KoalbyMQP/Hardware-Parts/datasheets/ESP-Prog/Info.txt

Product
https://www.amazon.com/dp/B0CB3Y18Z5?ref=ppx_yo2ov_dt_b_fed_asin_title

Setup
https://www.youtube.com/watch?v=d6toH-qJbOI
