KoalbyMQP/Hardware-Parts/mechanical/cad/assemblies/subsystems/hand/gripperAssem.SLDASM

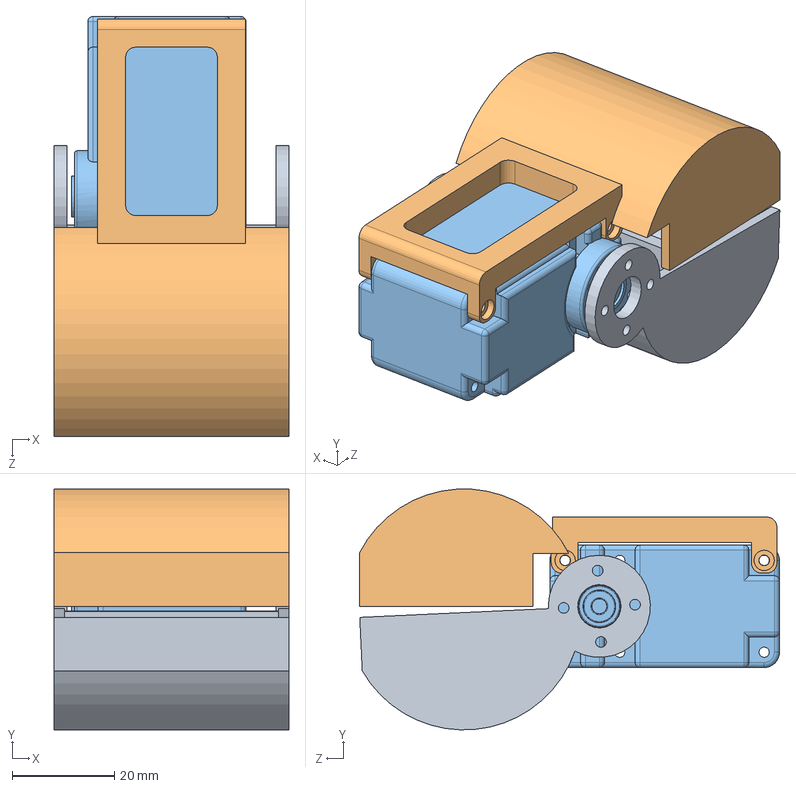
[picture p1: CAD file, 2025-09-24]
mechanical/cad/assemblies/subsystems/hand/gripperAssem.SLDASM
46.0 x 47.2 x 82.3 mm
herkulex_0201
SmallScoopFixed v1
SmallScoopFloat v1
