KoalbyMQP/Hardware-Parts/mechanical/cad/assemblies/subsystems/leg/Right Leg Assembly.SLDASM

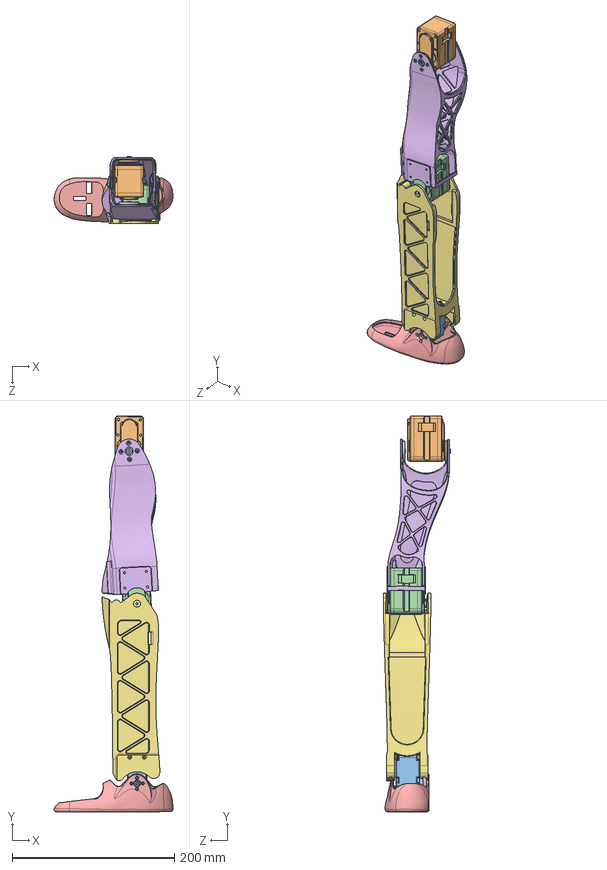
[picture p2: CAD file, 2025-09-24]
mechanical/cad/assemblies/subsystems/leg/Right Leg Assembly.SLDASM
146.7 x 488.7 x 83.3 mm
Right Shin v1
Right Thigh v1
Foot v1
0601_No_Horn
herkulex_0201
herkulex_0601
0601 Spacer v1
