KoalbyMQP/Hardware-Parts/Chess/Board/Chess Board asembly.SLDASM

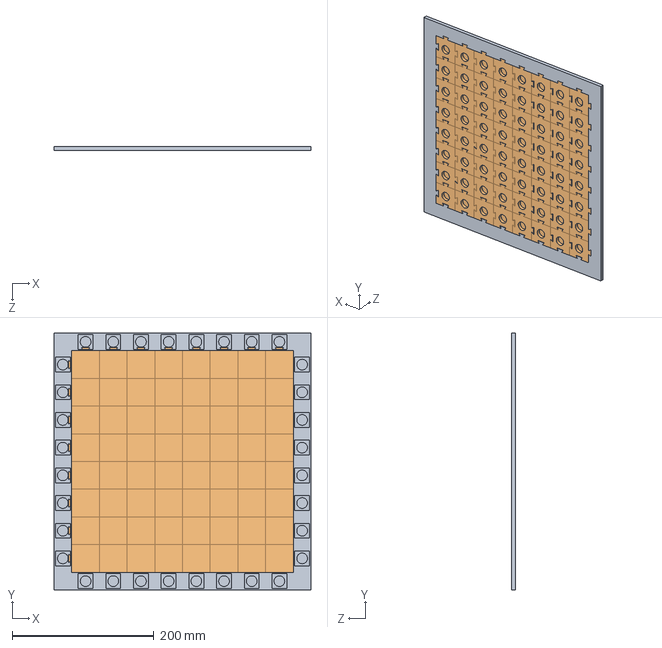
[picture p3: CAD file, 2026-02-05]
Chess/Board/Chess Board asembly.SLDASM
362.0 x 362.0 x 6.00 mm
chess square v4 x 64
Chess-Board-Boarder
