KoalbyMQP/Hardware-Parts/Chess/Board/chess square v4.SLDPRT

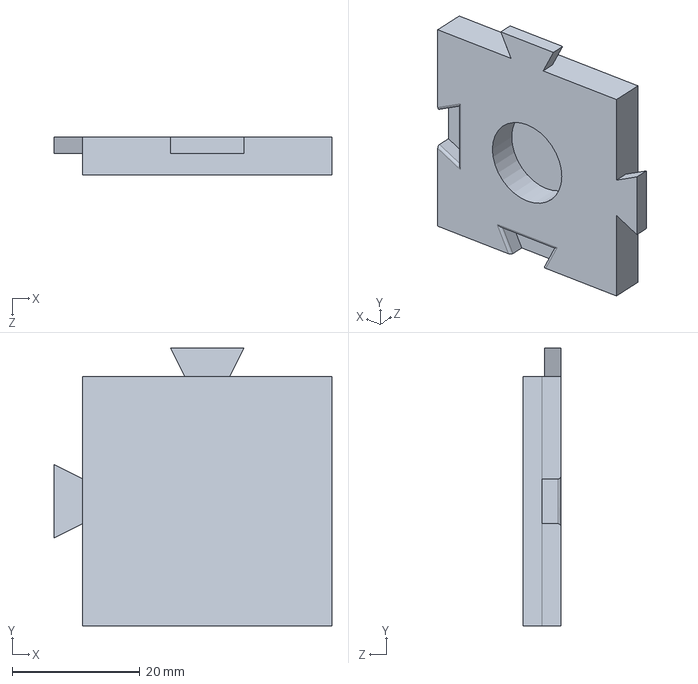
[picture p4: CAD file, 2026-02-05]
Chess/Board/chess square v4.SLDPRT
43.5 x 43.5 x 6.00 mm
