KoalbyMQP/Hardware-Parts/Chess/Camera/camera mount.SLDPRT

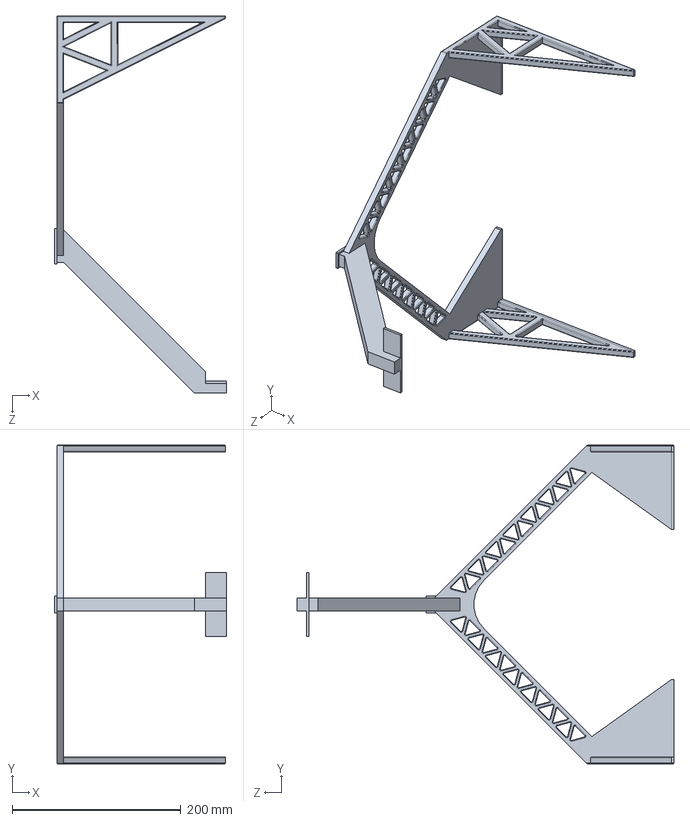
[picture p5: CAD file, 2026-02-05]
Chess/Camera/camera mount.SLDPRT
204.1 x 378.0 x 447.3 mm
