KoalbyMQP/Hardware-Parts/Chess/Pieces/Chess Board Squares/chess square v3.3mf

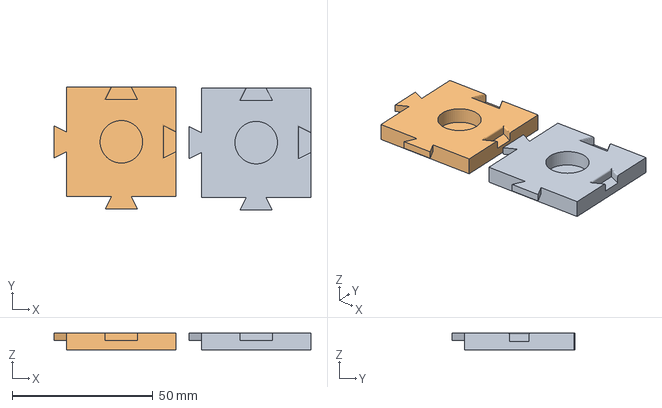
[picture p6: CAD file, 2026-02-05]
Chess/Pieces/Chess Board Squares/chess square v3.3mf
91.5 x 43.8 x 6.00 mm
chess square v3.stl x 2
