KoalbyMQP/Hardware-Parts/Chess/Pieces/Queen/Queen_Redo.3mf

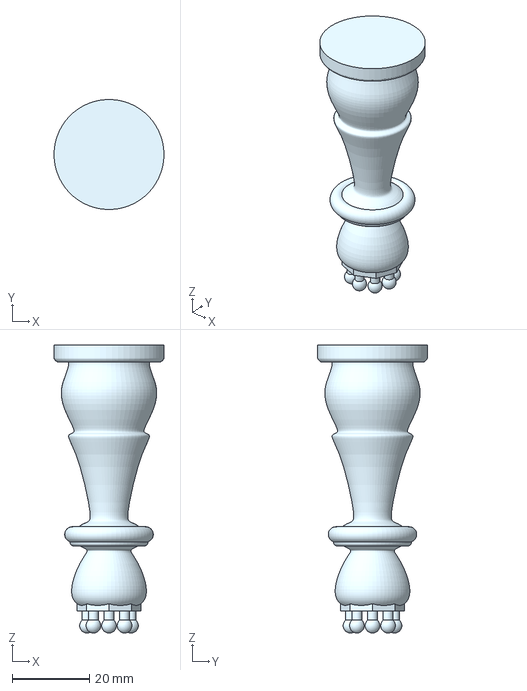
[picture p7: CAD file, 2026-02-05]
Chess/Pieces/Queen/Queen_Redo.3mf
28.5 x 28.5 x 74.6 mm
