KoalbyMQP/Hardware-Parts/mechanical/cad/parts/custom/grippers/scoops/SmallScoopFloat v1.SLDPRT

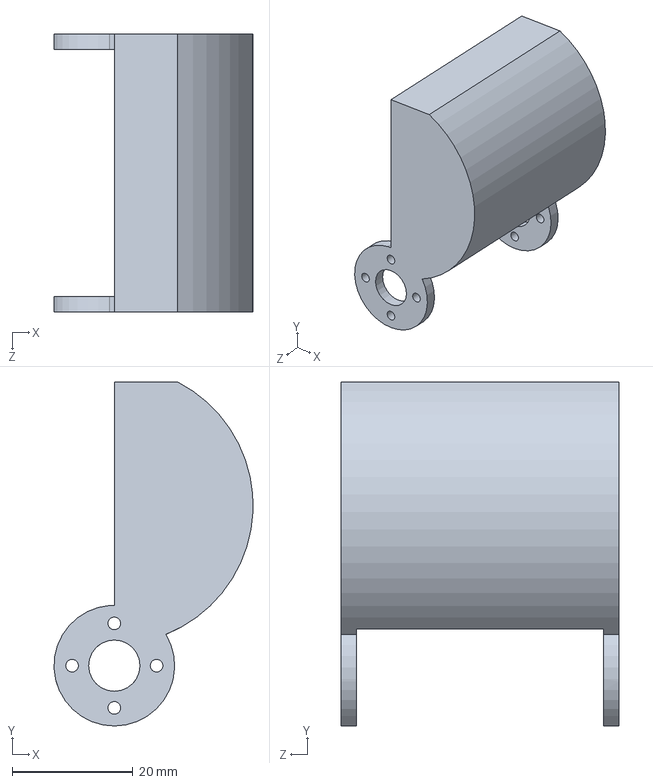
[picture p8: CAD file, 2025-09-24]
mechanical/cad/parts/custom/grippers/scoops/SmallScoopFloat v1.SLDPRT
33.0 x 57.0 x 46.0 mm
