KoalbyMQP/Hardware-Parts/mechanical/cad/parts/custom/mounts/0601 Spacer v1.SLDPRT

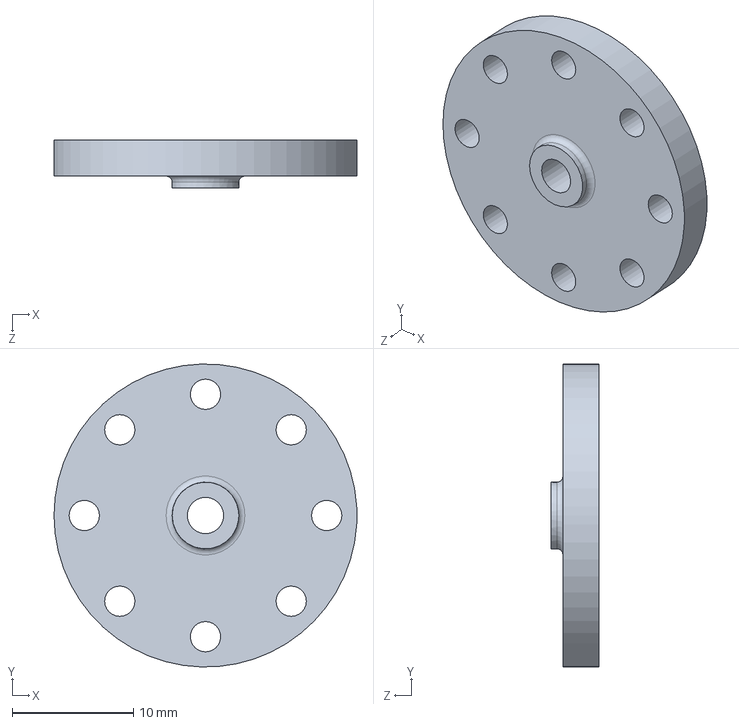
[picture p9: CAD file, 2025-09-24]
mechanical/cad/parts/custom/mounts/0601 Spacer v1.SLDPRT
25.0 x 25.0 x 4.00 mm
