KoalbyMQP/Hardware-Parts/mechanical/cad/parts/custom/mounts/Mounts_Head/RPi_Backplate_Head.SLDPRT

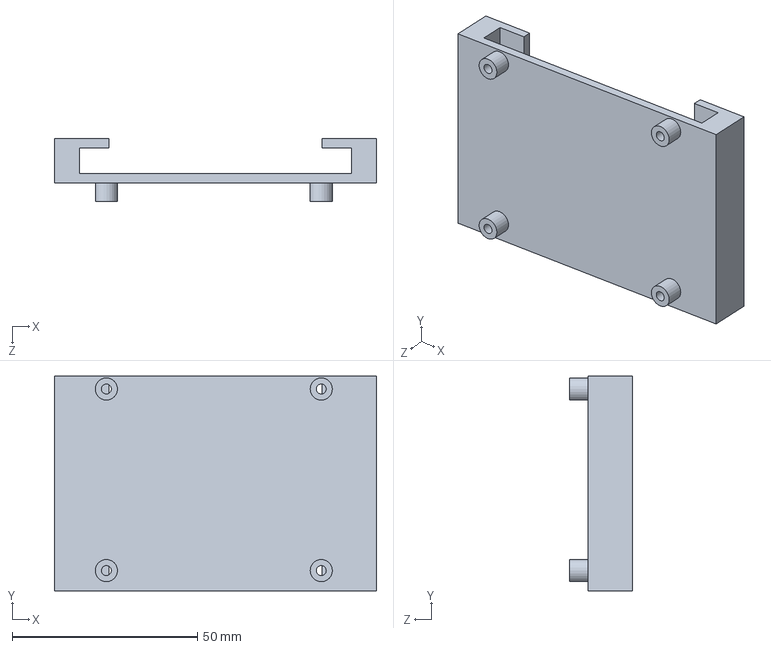
[picture p10: CAD file, 2025-09-24]
mechanical/cad/parts/custom/mounts/Mounts_Head/RPi_Backplate_Head.SLDPRT
86.9 x 58.0 x 17.0 mm
