KoalbyMQP/Hardware-Parts/mechanical/cad/parts/custom/structural/arms/Finley Shoulder Pulley/3421-0014-0060/3421-0014-0060 SW part.SLDPRT

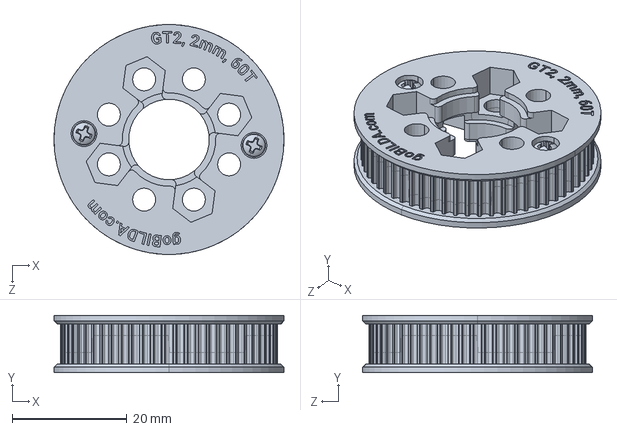
[picture p11: CAD file, 2025-09-10]
mechanical/cad/parts/custom/structural/arms/Finley Shoulder Pulley/3421-0014-0060/3421-0014-0060 SW part.SLDPRT
40.0 x 10.0 x 40.0 mm
