KoalbyMQP/Hardware-Parts/mechanical/cad/parts/custom/structural/arms/Finley Shoulder Pulley/Bicep v1.SLDPRT

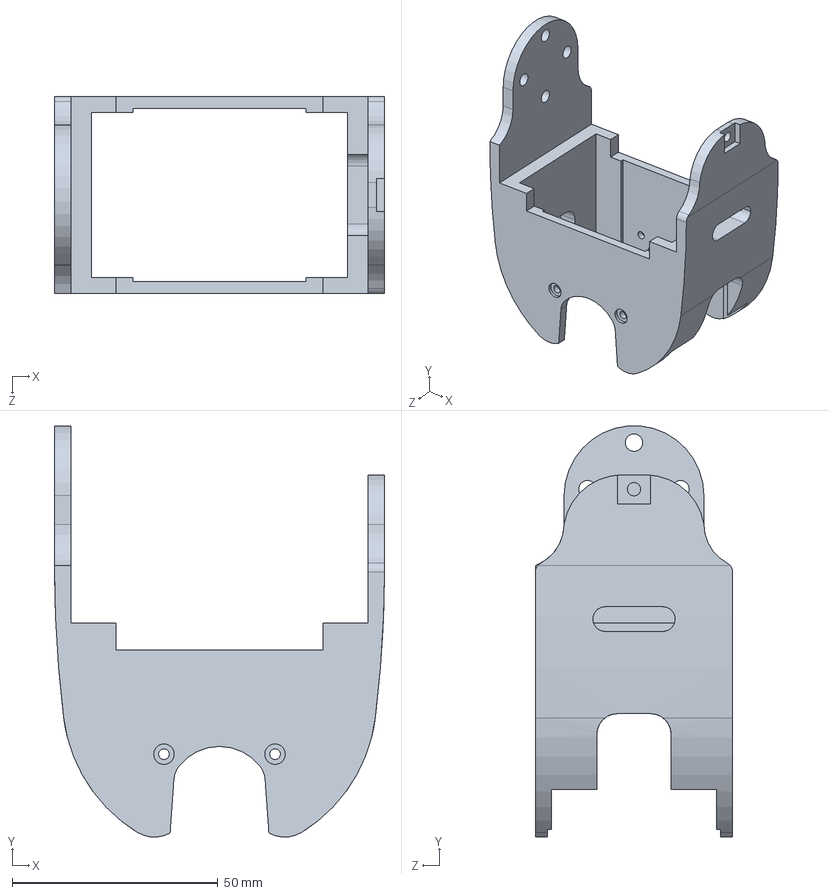
[picture p12: CAD file, 2025-09-24]
mechanical/cad/parts/custom/structural/arms/Finley Shoulder Pulley/Bicep v1.SLDPRT
80.2 x 99.9 x 48.0 mm
