KoalbyMQP/Hardware-Parts/mechanical/cad/parts/custom/structural/arms/Lower Forearm Bracket v1.SLDPRT

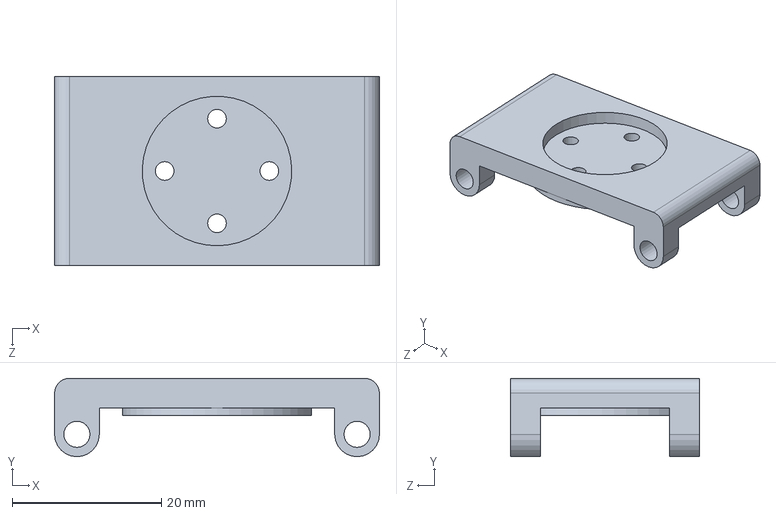
[picture p13: CAD file, 2025-09-24]
mechanical/cad/parts/custom/structural/arms/Lower Forearm Bracket v1.SLDPRT
43.5 x 10.5 x 25.2 mm
