KoalbyMQP/Hardware-Parts/mechanical/cad/parts/custom/structural/head/Head 2.0/Head 2.0.SLDPRT

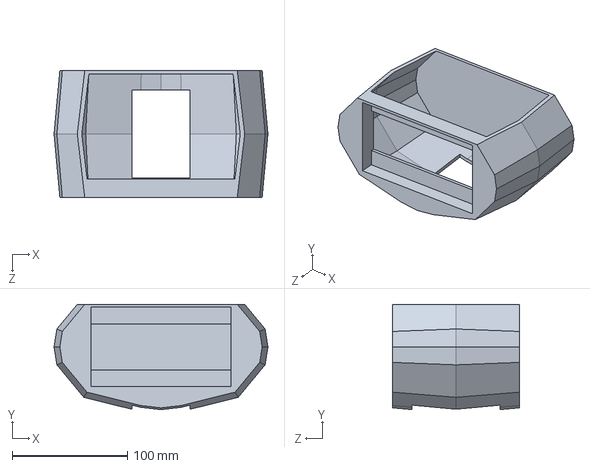
[picture p14: CAD file, 2025-09-24]
mechanical/cad/parts/custom/structural/head/Head 2.0/Head 2.0.SLDPRT
186.0 x 91.5 x 110.0 mm
