KoalbyMQP/Hardware-Parts/mechanical/cad/parts/custom/structural/head/Head v1.SLDPRT

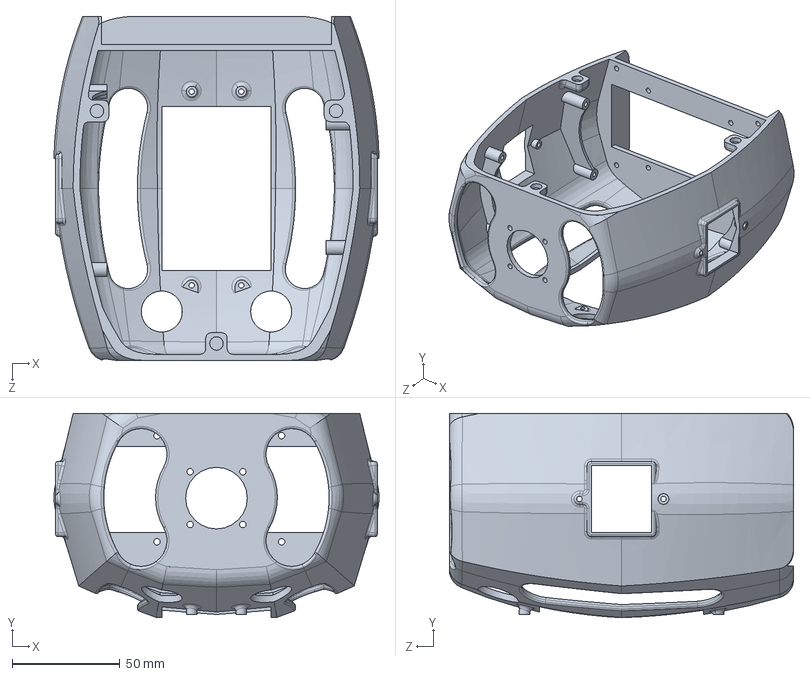
[picture p15: CAD file, 2025-09-24]
mechanical/cad/parts/custom/structural/head/Head v1.SLDPRT
151.0 x 95.0 x 160.0 mm
