KoalbyMQP/Hardware-Parts/mechanical/cad/parts/custom/structural/legs/Foot v1.SLDPRT

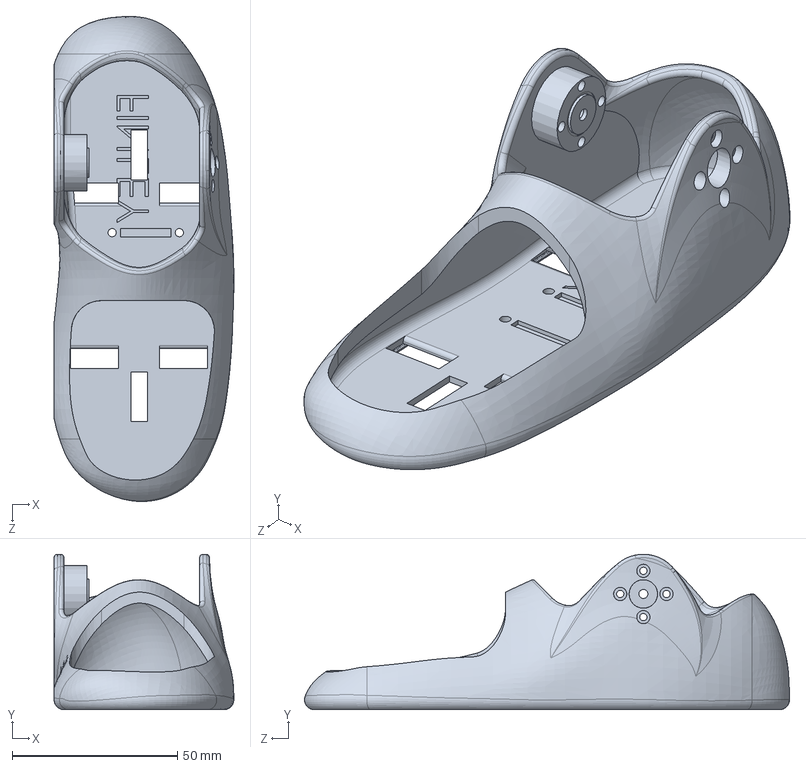
[picture p16: CAD file, 2025-09-24]
mechanical/cad/parts/custom/structural/legs/Foot v1.SLDPRT
54.4 x 47.0 x 146.7 mm
