KoalbyMQP/Hardware-Parts/mechanical/cad/parts/custom/structural/torso/Left Hip v1.SLDPRT

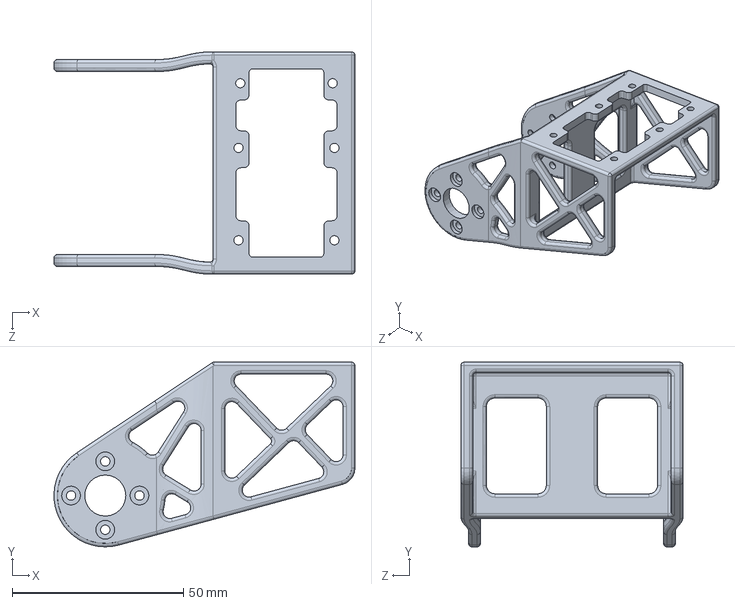
[picture p17: CAD file, 2025-09-24]
mechanical/cad/parts/custom/structural/torso/Left Hip v1.SLDPRT
88.0 x 54.0 x 65.0 mm
