KoalbyMQP/Hardware-Parts/mechanical/cad/parts/open-source/hardware/misc/electromagnet.SLDPRT

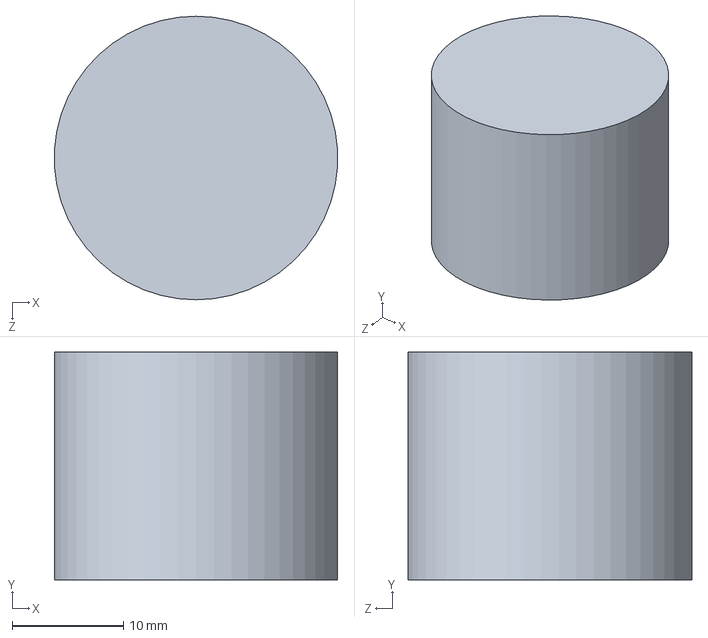
[picture p18: CAD file, 2025-09-03]
mechanical/cad/parts/open-source/hardware/misc/electromagnet.SLDPRT
25.4 x 20.5 x 25.5 mm
