KoalbyMQP/Hardware-Parts/mechanical/cad/parts/open-source/motors/herkulex_0201.SLDPRT

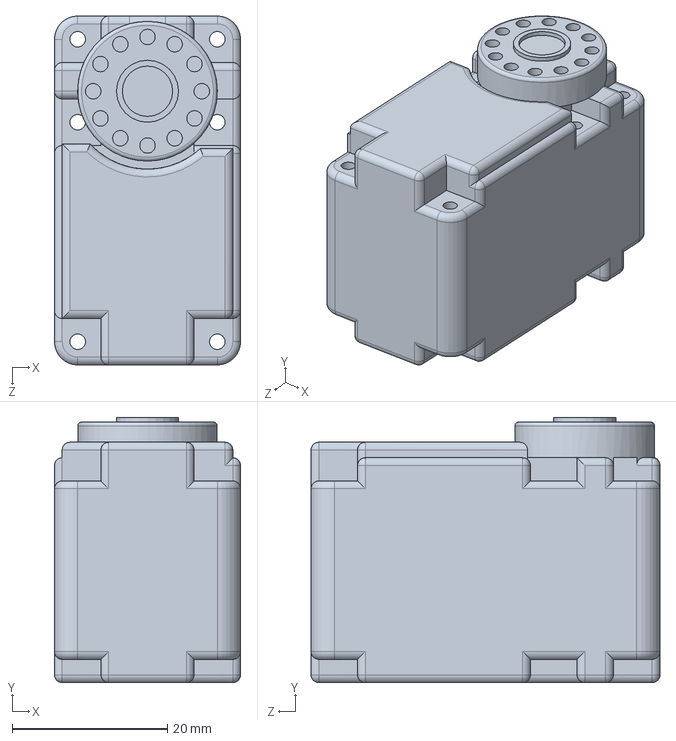
[picture p19: CAD file, 2025-09-10]
mechanical/cad/parts/open-source/motors/herkulex_0201.SLDPRT
24.0 x 34.2 x 45.0 mm
