KoalbyMQP/Hardware-Parts/mechanical/Simulation Files/SolidWorks/URDF_Links_Parts/foot_right.SLDPRT

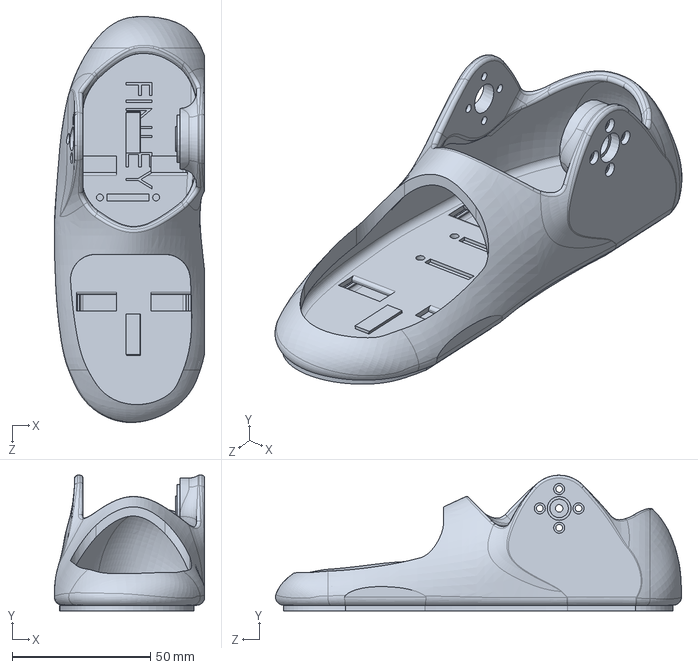
[picture p20: CAD file, 2025-09-10]
mechanical/Simulation Files/SolidWorks/URDF_Links_Parts/foot_right.SLDPRT
54.4 x 49.0 x 146.7 mm
