KoalbyMQP/Hardware-Parts/Chess/Board/Chess-Board-Boarder.SLDPRT

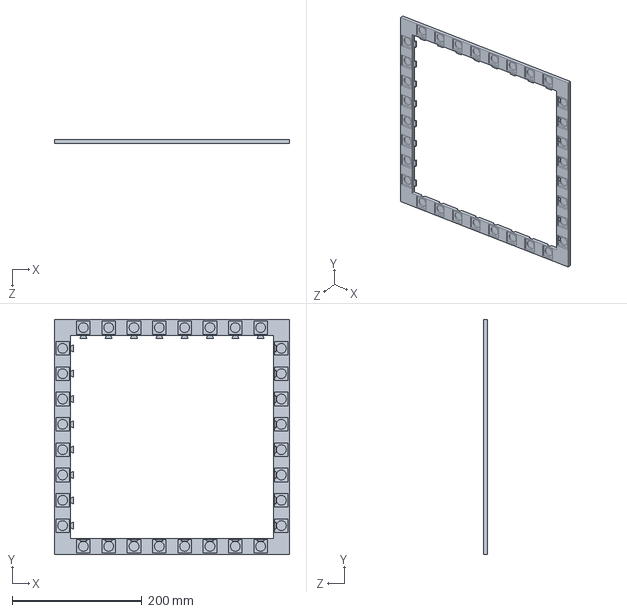
[picture p21: CAD file, 2026-02-05]
Chess/Board/Chess-Board-Boarder.SLDPRT
362.0 x 362.0 x 6.00 mm
