KoalbyMQP/Hardware-Parts/Chess/Camera/oakd camera.SLDPRT

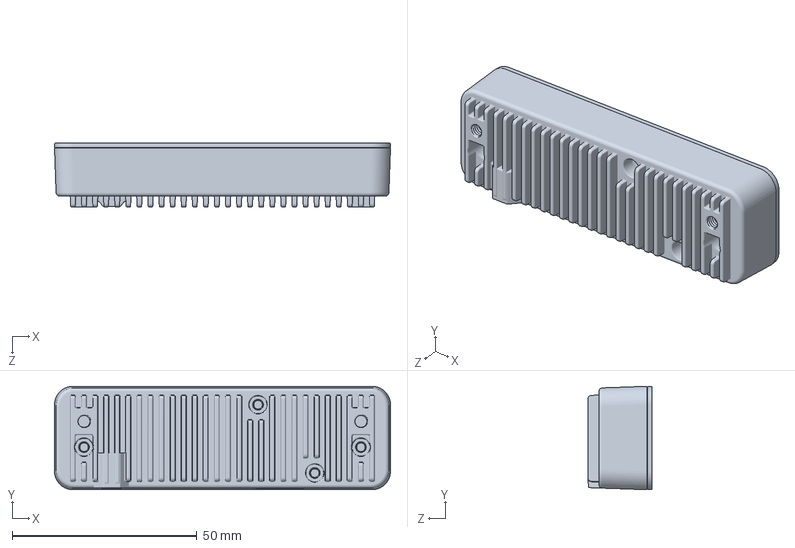
[picture p22: CAD file, 2026-02-05]
Chess/Camera/oakd camera.SLDPRT
91.0 x 28.0 x 17.5 mm
