KoalbyMQP/Hardware-Parts/Chess/Pieces/Pawn/insence match holder.3mf

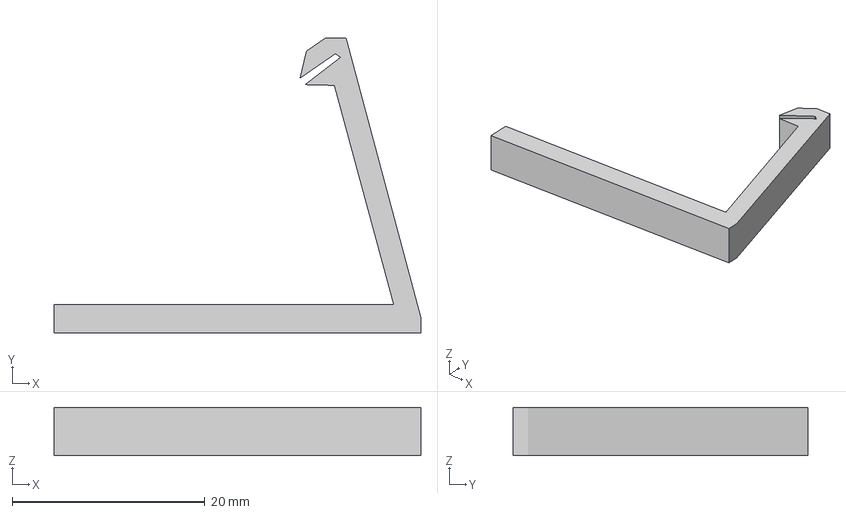
[picture p23: CAD file, 2026-02-05]
Chess/Pieces/Pawn/insence match holder.3mf
38.1 x 30.7 x 5.00 mm
