KoalbyMQP/Hardware-Parts/mechanical/cad/parts/custom/grippers/scoops/SmallScoopFixed v1.SLDPRT

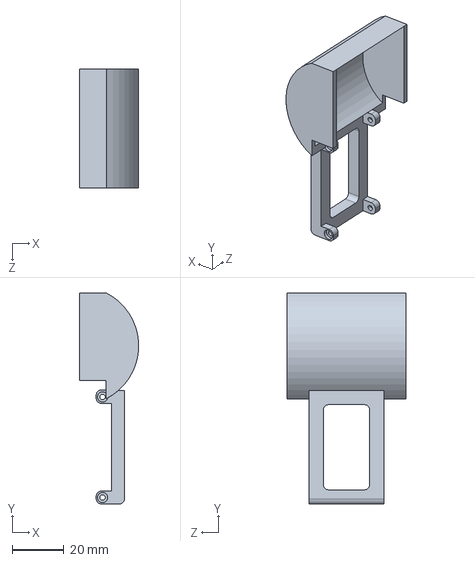
[picture p24: CAD file, 2025-09-24]
mechanical/cad/parts/custom/grippers/scoops/SmallScoopFixed v1.SLDPRT
23.0 x 81.8 x 46.0 mm
