KoalbyMQP/Hardware-Parts/mechanical/cad/parts/custom/KneeGearboxRedesign/24T_Carrier.SLDPRT

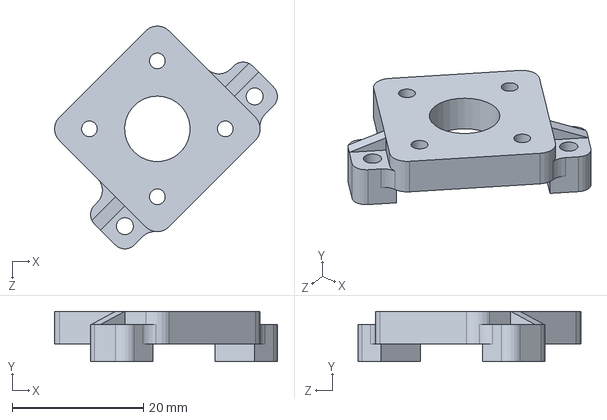
[picture p25: CAD file, 2025-12-09]
mechanical/cad/parts/custom/KneeGearboxRedesign/24T_Carrier.SLDPRT
34.0 x 7.70 x 34.0 mm
