KoalbyMQP/Hardware-Parts/mechanical/cad/parts/custom/mounts/Switch Mount v1.SLDPRT

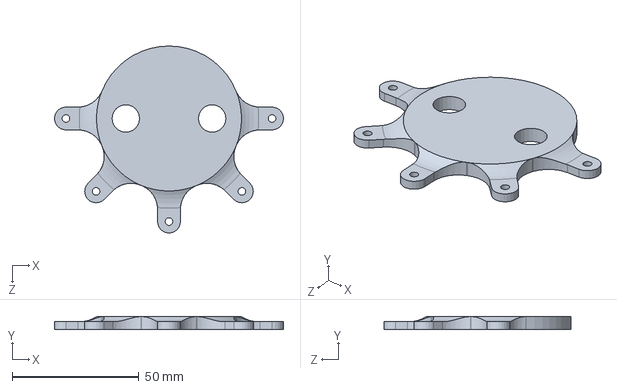
[picture p26: CAD file, 2025-09-24]
mechanical/cad/parts/custom/mounts/Switch Mount v1.SLDPRT
90.3 x 5.00 x 73.7 mm
