KoalbyMQP/Hardware-Parts/mechanical/cad/parts/custom/structural/arms/Finley Shoulder Pulley/Shoulder v1.SLDPRT

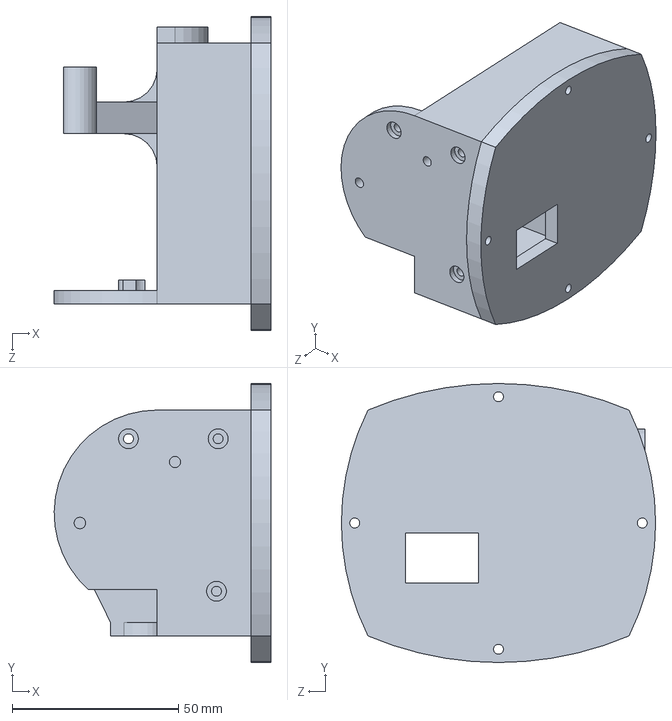
[picture p27: CAD file, 2025-09-24]
mechanical/cad/parts/custom/structural/arms/Finley Shoulder Pulley/Shoulder v1.SLDPRT
65.2 x 84.0 x 94.6 mm
