KoalbyMQP/Hardware-Parts/mechanical/cad/parts/custom/structural/arms/Wrist Mounting Pyramid v1.SLDPRT

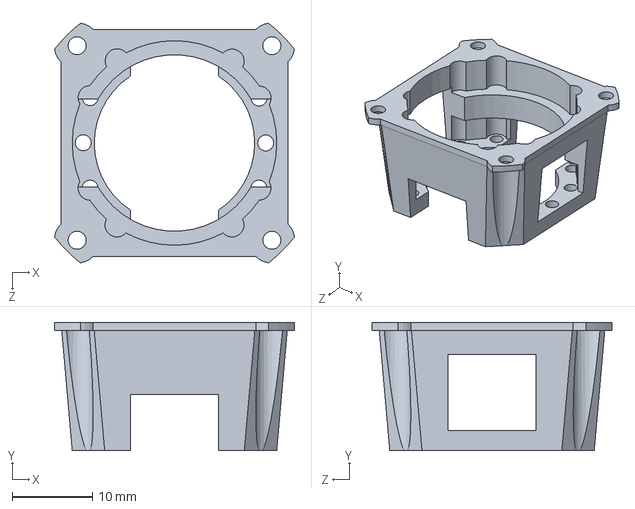
[picture p28: CAD file, 2025-09-24]
mechanical/cad/parts/custom/structural/arms/Wrist Mounting Pyramid v1.SLDPRT
29.9 x 16.0 x 29.9 mm
