KoalbyMQP/Hardware-Parts/mechanical/cad/parts/custom/structural/head/Blindfold v1.SLDPRT

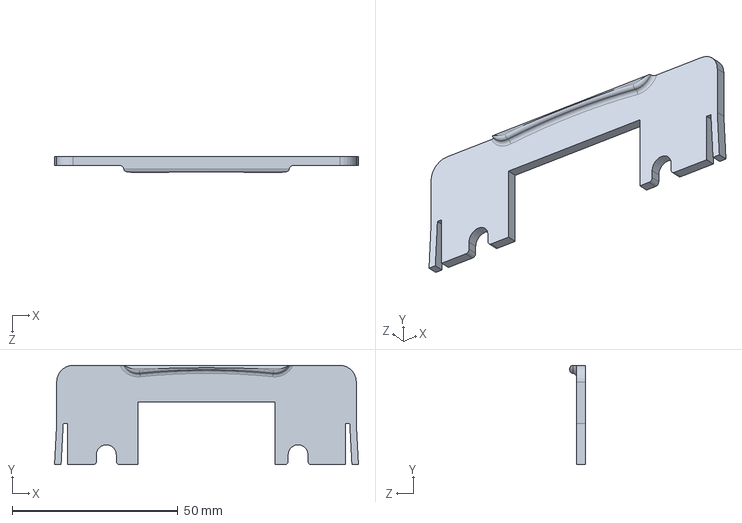
[picture p29: CAD file, 2025-09-24]
mechanical/cad/parts/custom/structural/head/Blindfold v1.SLDPRT
91.8 x 30.0 x 4.70 mm
