KoalbyMQP/Hardware-Parts/mechanical/cad/parts/custom/structural/legs/Right Thigh v1.SLDPRT

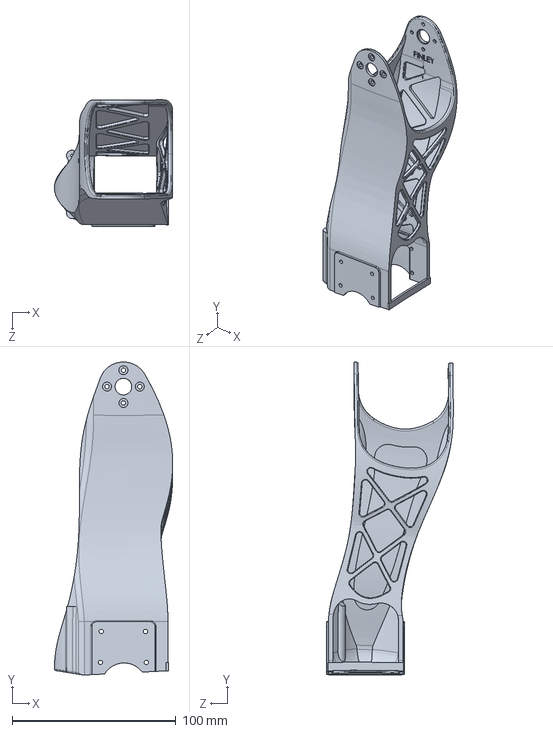
[picture p30: CAD file, 2025-09-24]
mechanical/cad/parts/custom/structural/legs/Right Thigh v1.SLDPRT
72.2 x 191.1 x 77.3 mm
