KoalbyMQP/Hardware-Parts/mechanical/cad/parts/open-source/motors/herkulex_0601.SLDPRT

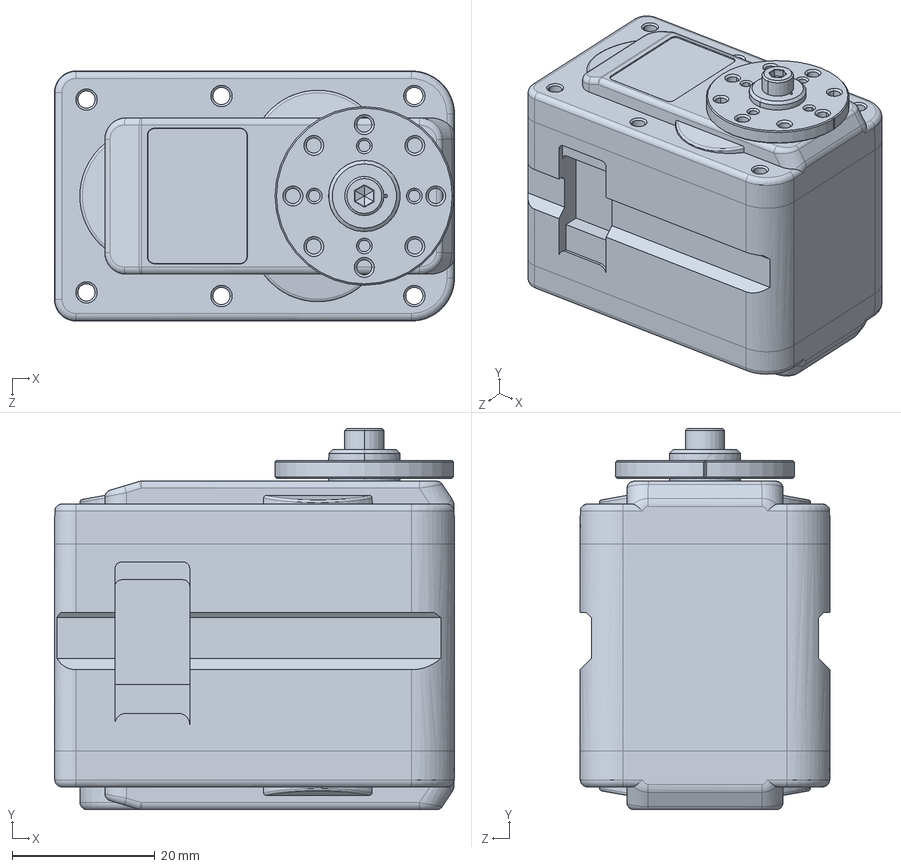
[picture p31: CAD file, 2025-09-10]
mechanical/cad/parts/open-source/motors/herkulex_0601.SLDPRT
56.0 x 53.4 x 35.0 mm
