KoalbyMQP/Hardware-Parts/mechanical/Simulation Files/SolidWorks/URDF_Links_Parts/head.SLDPRT

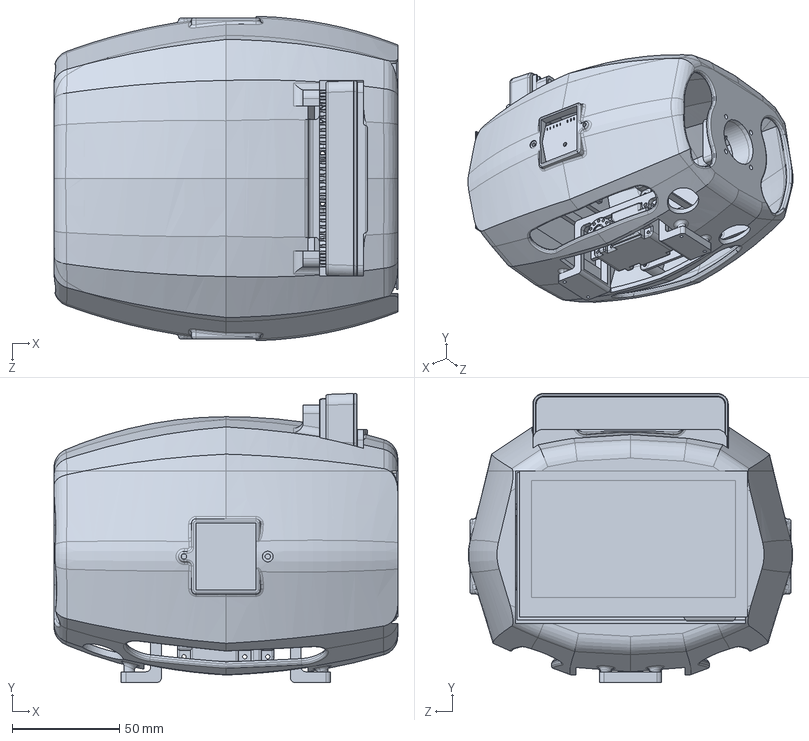
[picture p32: CAD file, 2025-09-10]
mechanical/Simulation Files/SolidWorks/URDF_Links_Parts/head.SLDPRT
160.1 x 134.5 x 151.0 mm
