KoalbyMQP/Hardware-Parts/mechanical/cad/parts/custom/KneeGearboxRedesign/16-24Ring.SLDPRT

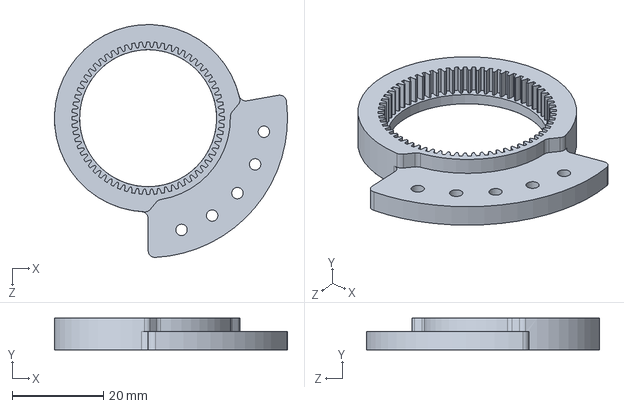
[picture p33: CAD file, 2025-12-09]
mechanical/cad/parts/custom/KneeGearboxRedesign/16-24Ring.SLDPRT
51.0 x 7.00 x 50.9 mm
