KoalbyMQP/Hardware-Parts/mechanical/cad/parts/custom/mounts/Head Mounting Bracket v1.SLDPRT

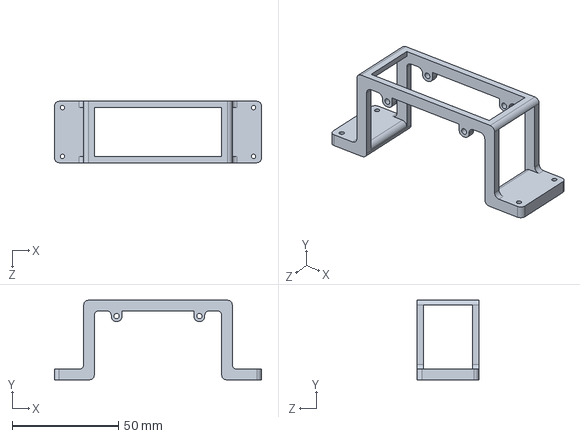
[picture p34: CAD file, 2025-09-24]
mechanical/cad/parts/custom/mounts/Head Mounting Bracket v1.SLDPRT
97.5 x 37.5 x 29.0 mm
