KoalbyMQP/Hardware-Parts/mechanical/cad/parts/custom/mounts/Mounts_Head/Arduino_Backplate_Head.SLDPRT

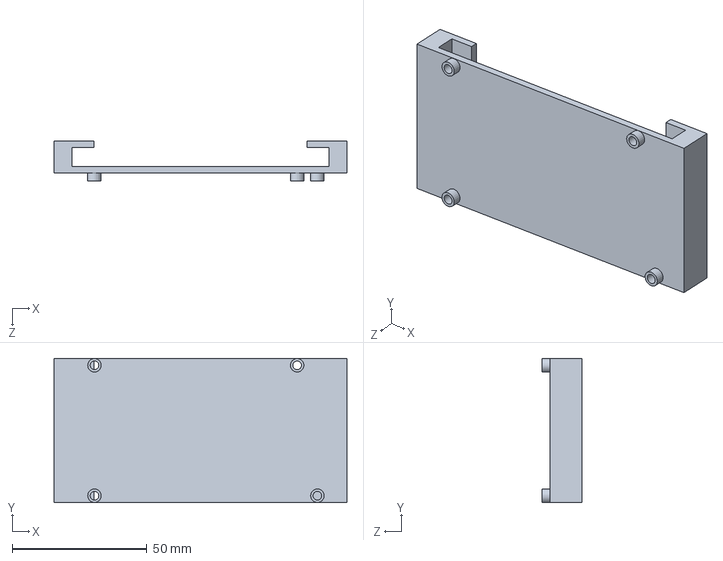
[picture p35: CAD file, 2025-09-24]
mechanical/cad/parts/custom/mounts/Mounts_Head/Arduino_Backplate_Head.SLDPRT
108.6 x 53.4 x 15.0 mm
