KoalbyMQP/Hardware-Parts/mechanical/cad/parts/custom/structural/arms/Finley Shoulder Pulley/Shoulder Adapter v1.SLDPRT

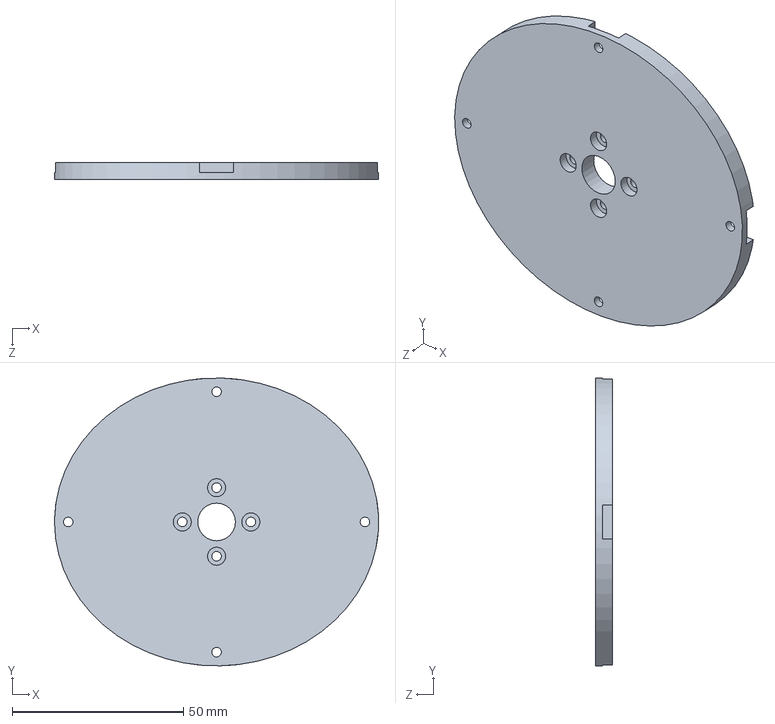
[picture p36: CAD file, 2025-09-24]
mechanical/cad/parts/custom/structural/arms/Finley Shoulder Pulley/Shoulder Adapter v1.SLDPRT
94.5 x 83.9 x 5.00 mm
