KoalbyMQP/Hardware-Parts/mechanical/cad/parts/custom/structural/arms/Wrist v1.SLDPRT

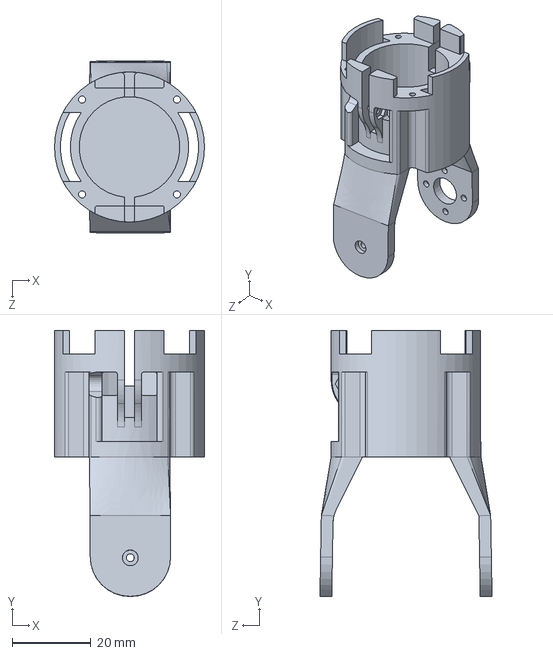
[picture p37: CAD file, 2025-09-24]
mechanical/cad/parts/custom/structural/arms/Wrist v1.SLDPRT
38.0 x 67.4 x 43.6 mm
