KoalbyMQP/Hardware-Parts/mechanical/cad/parts/custom/structural/head/Neck v1.SLDPRT

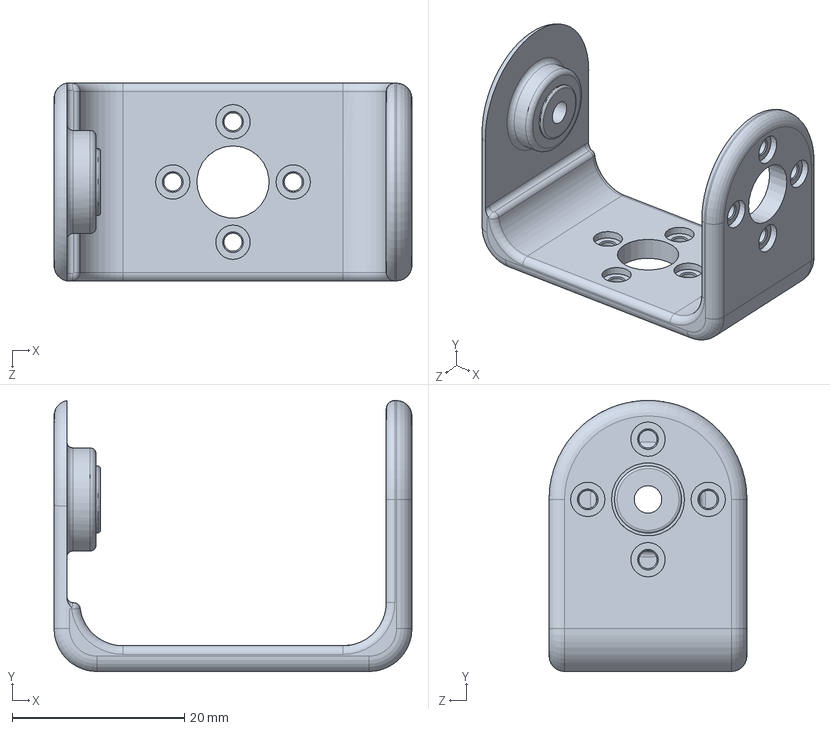
[picture p38: CAD file, 2025-09-24]
mechanical/cad/parts/custom/structural/head/Neck v1.SLDPRT
41.6 x 31.5 x 23.0 mm
