KoalbyMQP/Hardware-Parts/mechanical/cad/parts/custom/structural/legs/Right Shin v1.SLDPRT

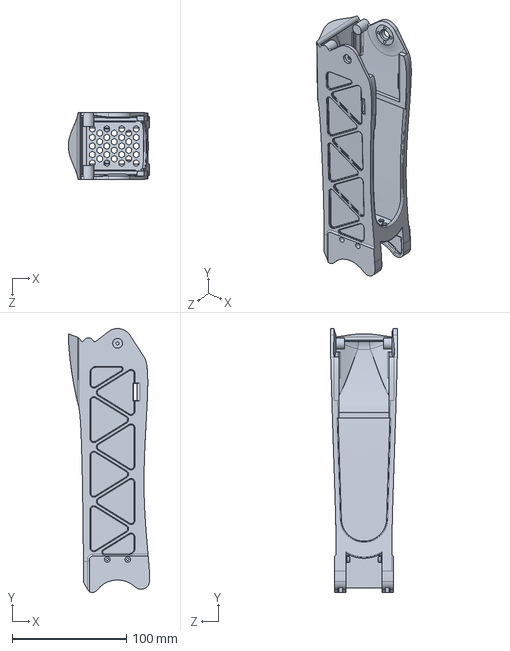
[picture p39: CAD file, 2025-09-24]
mechanical/cad/parts/custom/structural/legs/Right Shin v1.SLDPRT
71.3 x 231.5 x 59.0 mm
