KoalbyMQP/Hardware-Parts/mechanical/cad/parts/custom/structural/torso/Abdomen v1.SLDPRT

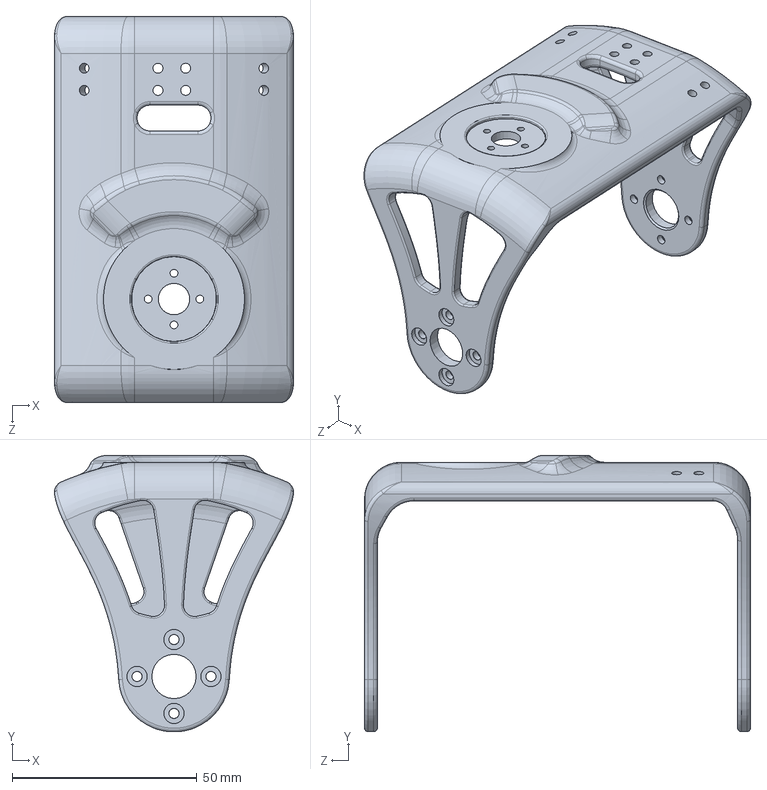
[picture p40: CAD file, 2025-09-24]
mechanical/cad/parts/custom/structural/torso/Abdomen v1.SLDPRT
64.8 x 74.8 x 104.5 mm
