KoalbyMQP/Hardware-Parts/mechanical/Simulation Files/SolidWorks/URDF_Links_Parts/wrist_left.SLDPRT

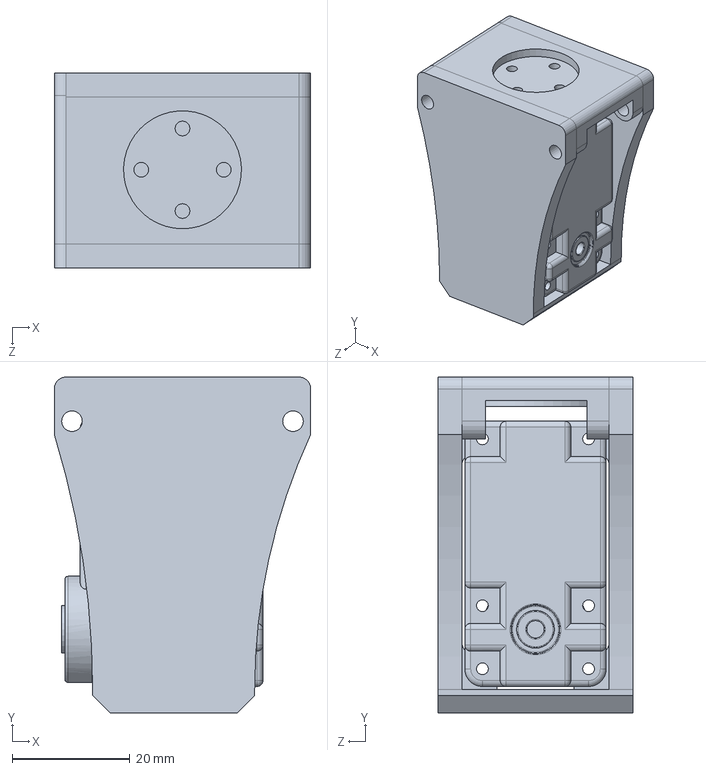
[picture p41: CAD file, 2025-09-10]
mechanical/Simulation Files/SolidWorks/URDF_Links_Parts/wrist_left.SLDPRT
43.5 x 57.0 x 33.0 mm
