KoalbyMQP/Hardware-Parts/Chess/Board/april tags.SLDPRT

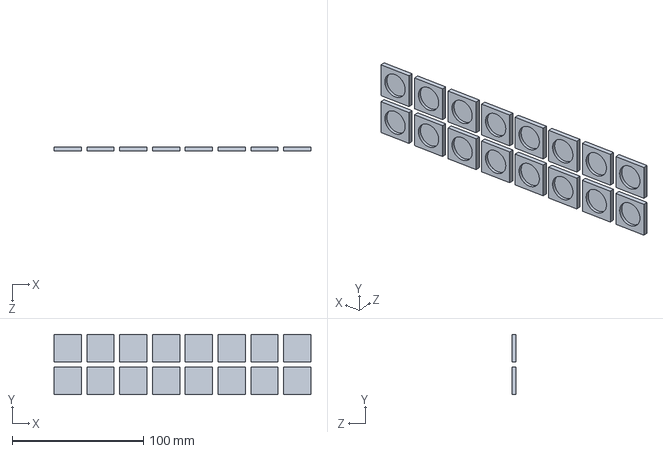
[picture p42: CAD file, 2026-02-05]
Chess/Board/april tags.SLDPRT
195.9 x 45.9 x 3.00 mm
