KoalbyMQP/Hardware-Parts/mechanical/cad/assemblies/New Motor Attachment/Countersunk Motor Bracket.SLDPRT

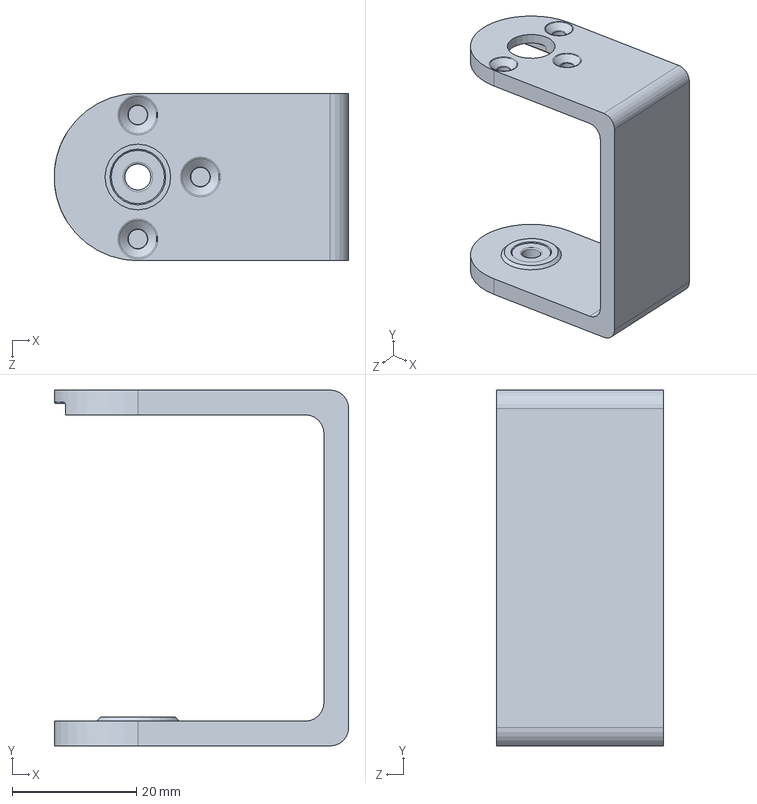
[picture p43: CAD file, 2025-09-24]
mechanical/cad/assemblies/New Motor Attachment/Countersunk Motor Bracket.SLDPRT
47.5 x 57.4 x 27.0 mm
