KoalbyMQP/Hardware-Parts/mechanical/cad/parts/custom/KneeGearboxRedesign/0601_No_Horn.SLDPRT

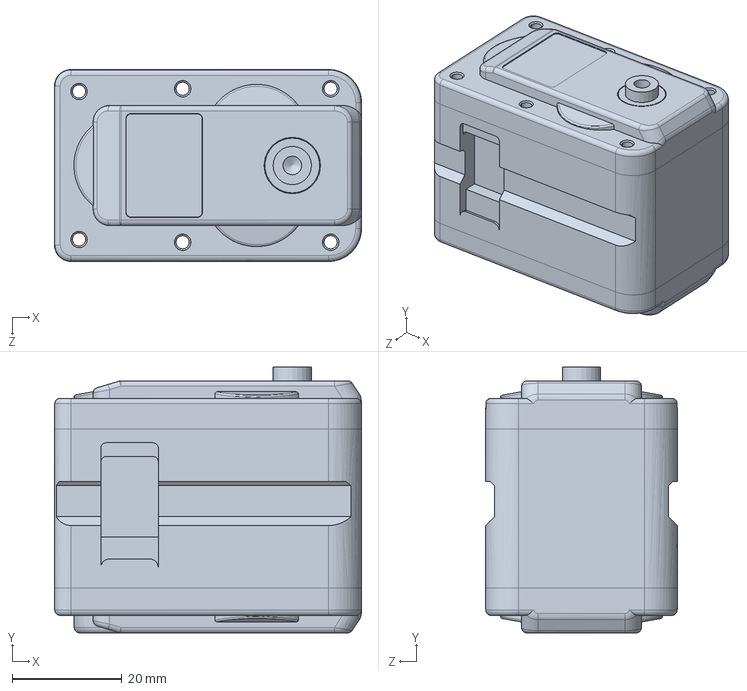
[picture p44: CAD file, 2025-12-09]
mechanical/cad/parts/custom/KneeGearboxRedesign/0601_No_Horn.SLDPRT
56.0 x 48.5 x 35.0 mm
