KoalbyMQP/Hardware-Parts/mechanical/cad/parts/custom/mounts/Motor Mount B v1.SLDPRT

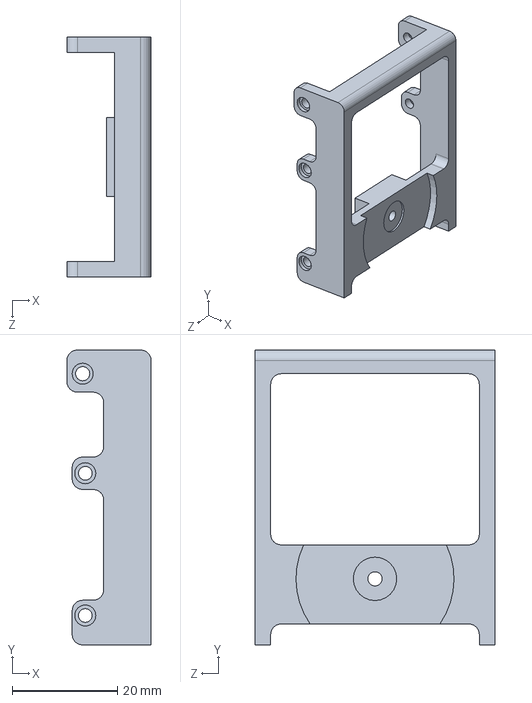
[picture p45: CAD file, 2025-09-24]
mechanical/cad/parts/custom/mounts/Motor Mount B v1.SLDPRT
16.0 x 56.0 x 45.6 mm
