KoalbyMQP/Hardware-Parts/mechanical/cad/parts/custom/mounts/Mounts_Head/Head_Boards_Mount_2.SLDPRT

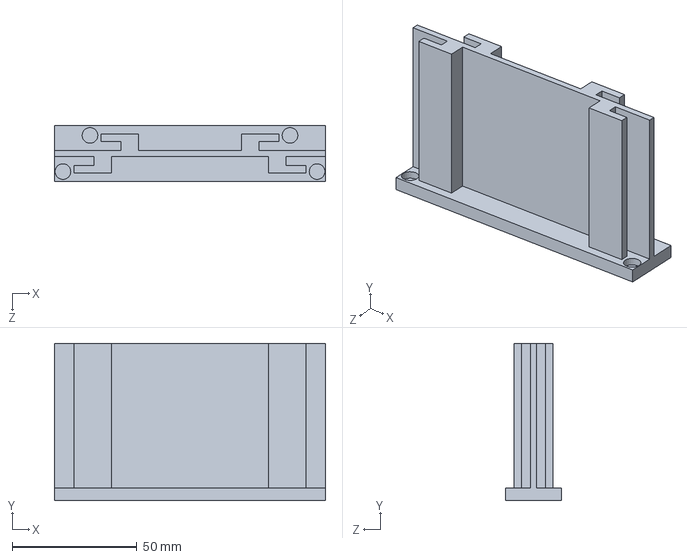
[picture p46: CAD file, 2025-09-24]
mechanical/cad/parts/custom/mounts/Mounts_Head/Head_Boards_Mount_2.SLDPRT
108.6 x 63.0 x 22.5 mm
