KoalbyMQP/Hardware-Parts/mechanical/cad/parts/custom/structural/arms/Lower Forearm v1.SLDPRT

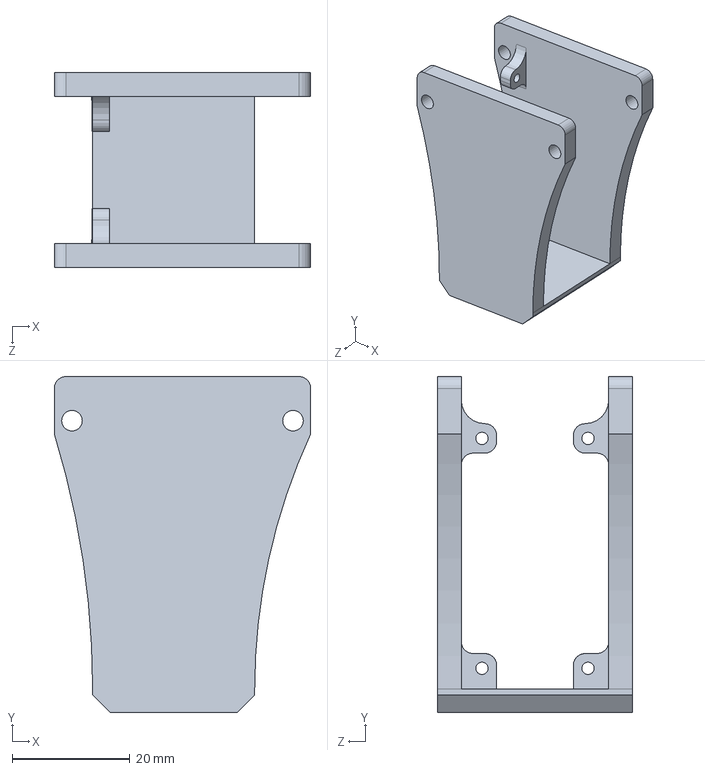
[picture p47: CAD file, 2025-09-24]
mechanical/cad/parts/custom/structural/arms/Lower Forearm v1.SLDPRT
43.5 x 57.0 x 33.0 mm
