KoalbyMQP/Hardware-Parts/mechanical/cad/parts/custom/structural/head/Head Lid v1.SLDPRT

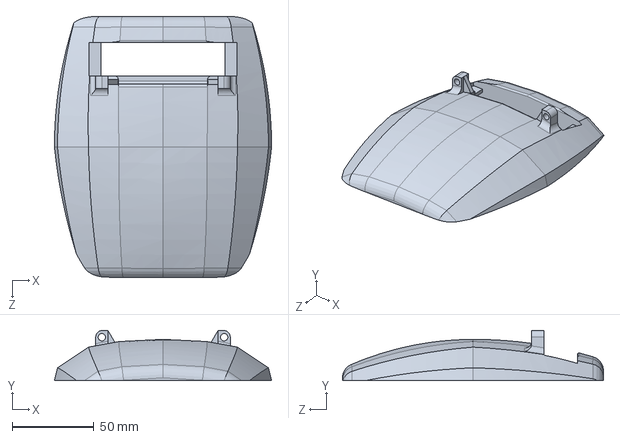
[picture p48: CAD file, 2025-09-24]
mechanical/cad/parts/custom/structural/head/Head Lid v1.SLDPRT
133.1 x 30.7 x 160.0 mm
