KoalbyMQP/Hardware-Parts/mechanical/cad/parts/custom/structural/torso/Waist Horn Spacer v1.SLDPRT

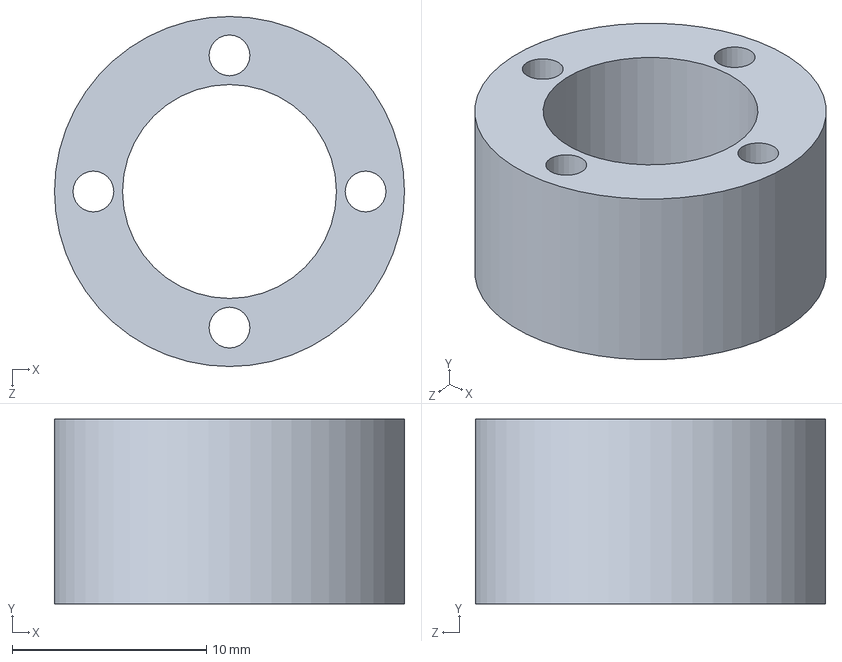
[picture p49: CAD file, 2025-09-24]
mechanical/cad/parts/custom/structural/torso/Waist Horn Spacer v1.SLDPRT
18.0 x 9.50 x 18.0 mm
