KoalbyMQP/Hardware-Parts/mechanical/cad/parts/custom/KneeGearboxRedesign/16TGear.SLDPRT

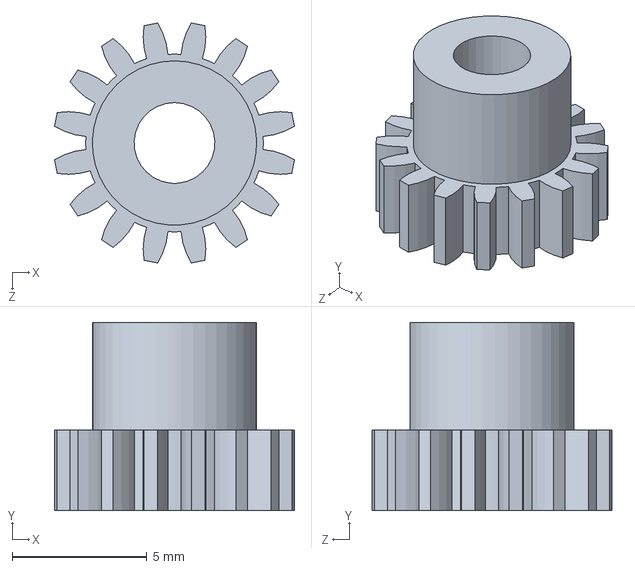
[picture p50: CAD file, 2025-12-09]
mechanical/cad/parts/custom/KneeGearboxRedesign/16TGear.SLDPRT
8.91 x 7.00 x 8.91 mm
