KoalbyMQP/Hardware-Parts/mechanical/cad/parts/custom/mounts/Motor Mount A v1.SLDPRT

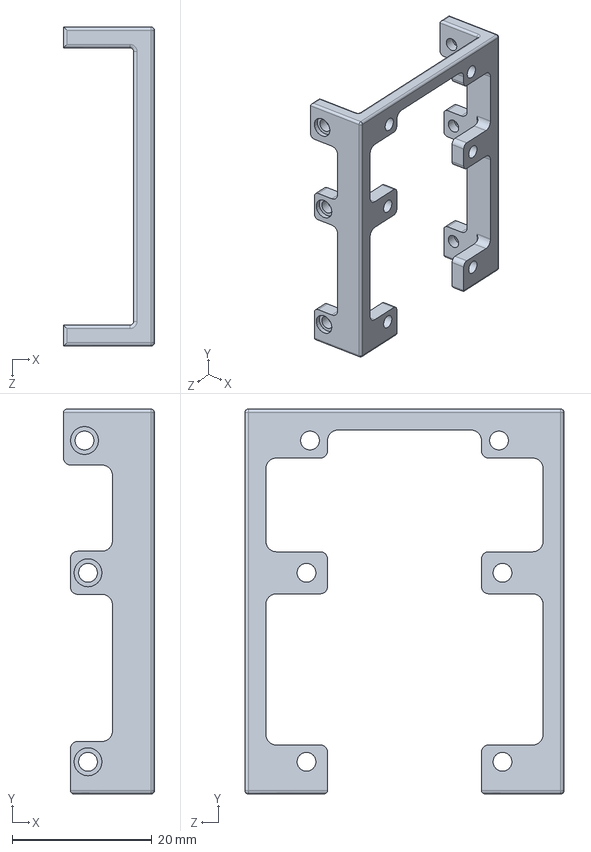
[picture p51: CAD file, 2025-09-24]
mechanical/cad/parts/custom/mounts/Motor Mount A v1.SLDPRT
13.0 x 55.0 x 45.6 mm
