KoalbyMQP/Hardware-Parts/mechanical/cad/parts/custom/structural/arms/Upper Forearm v1.SLDPRT

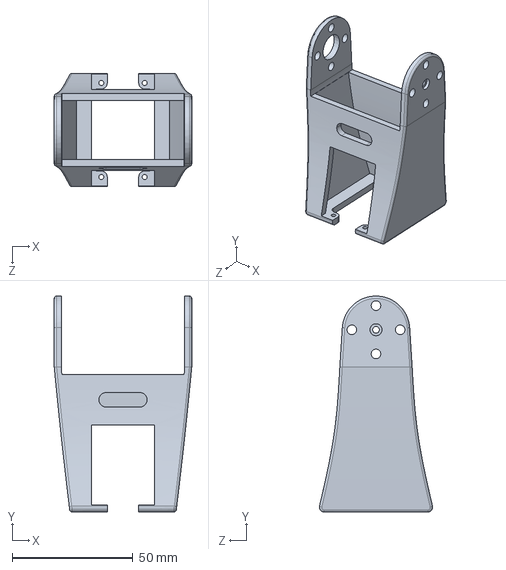
[picture p52: CAD file, 2025-09-24]
mechanical/cad/parts/custom/structural/arms/Upper Forearm v1.SLDPRT
57.0 x 89.5 x 46.9 mm
