KoalbyMQP/Hardware-Parts/mechanical/cad/parts/custom/structural/legs/Foot Sole v1.SLDPRT

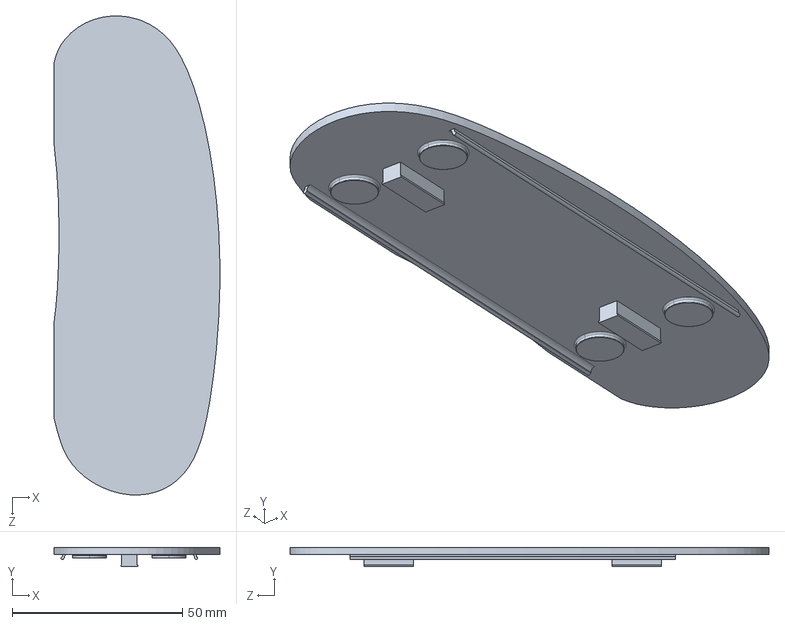
[picture p53: CAD file, 2025-09-24]
mechanical/cad/parts/custom/structural/legs/Foot Sole v1.SLDPRT
48.6 x 5.60 x 140.6 mm
