KoalbyMQP/Hardware-Parts/mechanical/cad/parts/custom/structural/torso/Hip Connector v1.SLDPRT

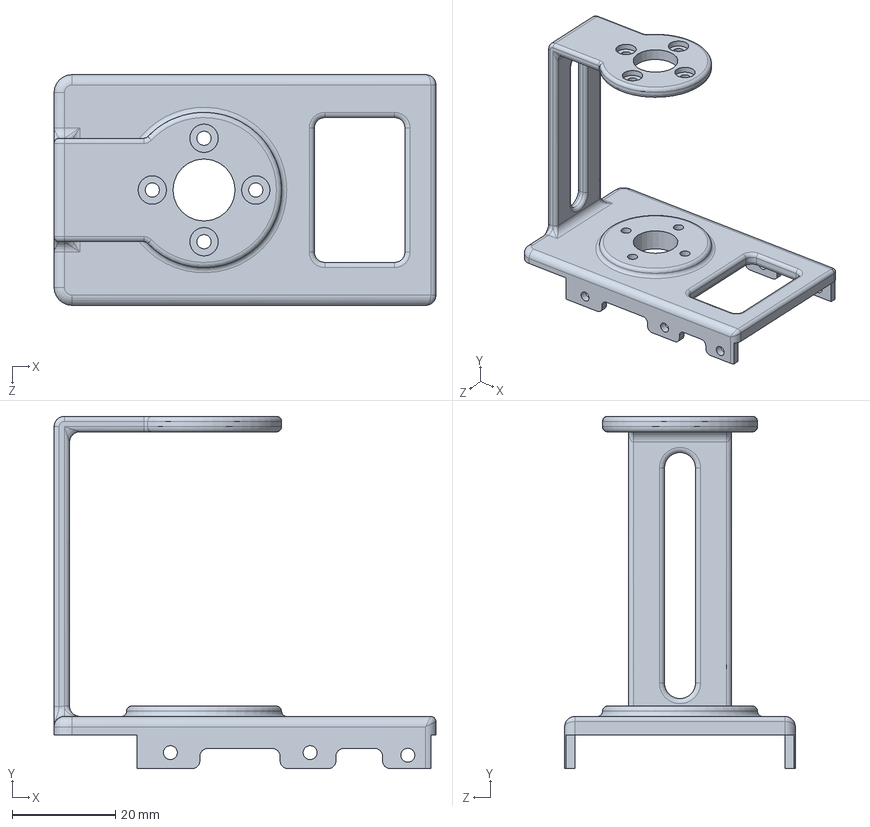
[picture p54: CAD file, 2025-09-24]
mechanical/cad/parts/custom/structural/torso/Hip Connector v1.SLDPRT
73.8 x 68.1 x 44.6 mm
