KoalbyMQP/Hardware-Parts/mechanical/cad/parts/custom/structural/arms/Male_Plug_Central_Cut_REV2.SLDPRT

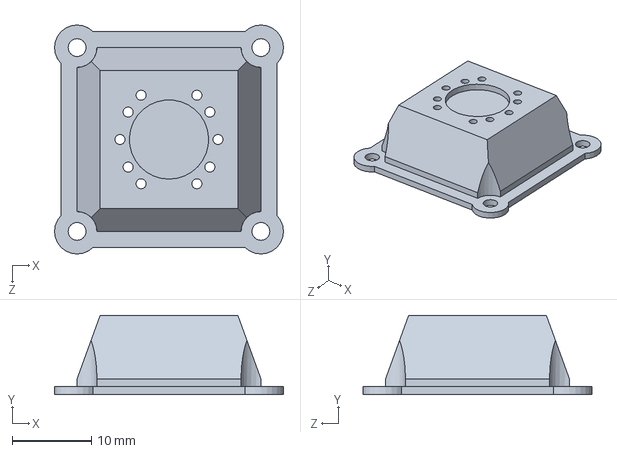
[picture p55: CAD file, 2025-09-22]
mechanical/cad/parts/custom/structural/arms/Male_Plug_Central_Cut_REV2.SLDPRT
28.9 x 10.0 x 28.9 mm
