KoalbyMQP/Hardware-Parts/mechanical/cad/parts/custom/structural/torso/Back Hook v1.SLDPRT

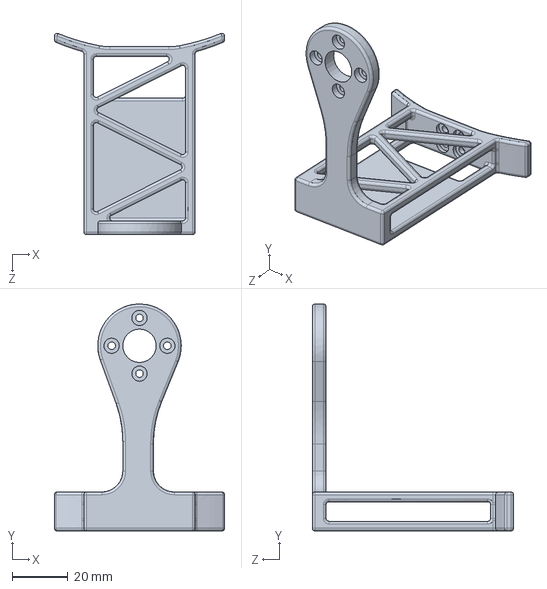
[picture p56: CAD file, 2025-09-24]
mechanical/cad/parts/custom/structural/torso/Back Hook v1.SLDPRT
61.2 x 81.5 x 72.3 mm
