KoalbyMQP/Hardware-Parts/mechanical/Simulation Files/SolidWorks/URDF_Links_Parts/forearm_left.SLDPRT

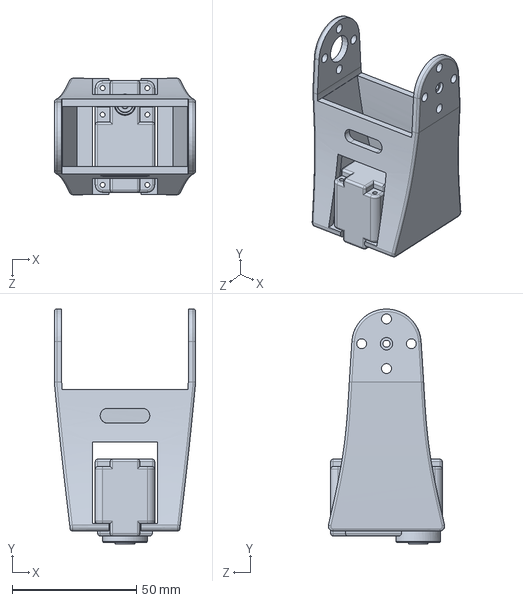
[picture p57: CAD file, 2025-09-10]
mechanical/Simulation Files/SolidWorks/URDF_Links_Parts/forearm_left.SLDPRT
57.0 x 94.7 x 46.9 mm
