KoalbyMQP/Hardware-Parts/mechanical/cad/parts/custom/structural/arms/Finley Shoulder Pulley/timingBelt.SLDPRT

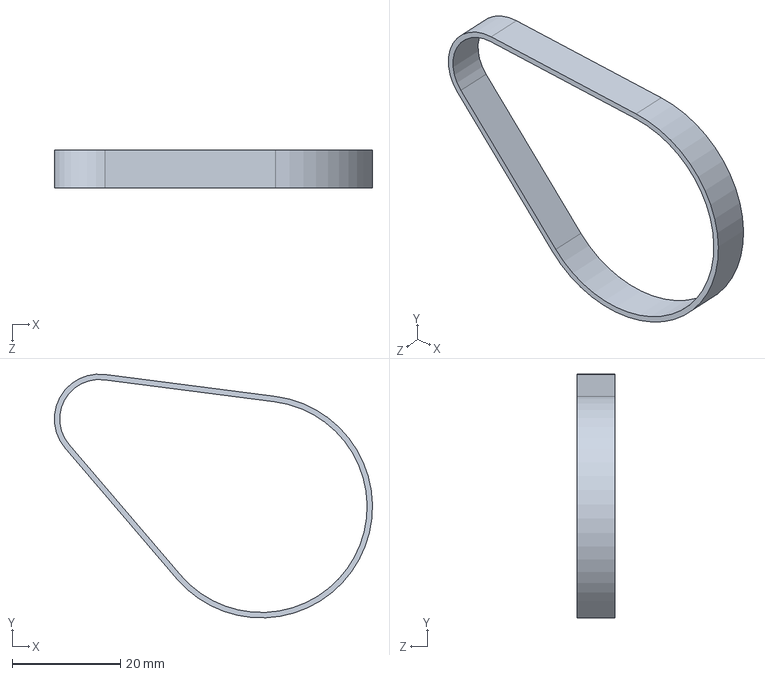
[picture p58: CAD file, 2025-09-10]
mechanical/cad/parts/custom/structural/arms/Finley Shoulder Pulley/timingBelt.SLDPRT
58.6 x 44.9 x 7.00 mm
