KoalbyMQP/Hardware-Parts/mechanical/cad/parts/custom/structural/torso/Waist Bearing Connector v1.SLDPRT

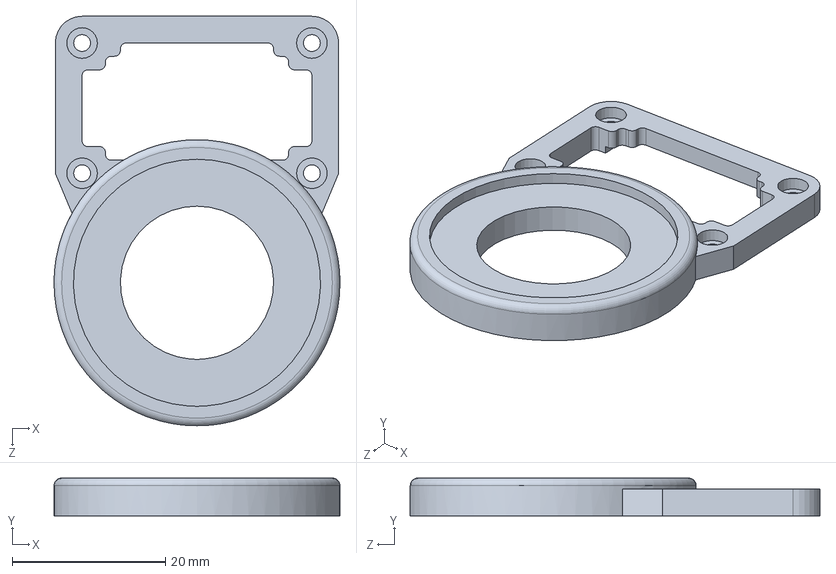
[picture p59: CAD file, 2025-09-24]
mechanical/cad/parts/custom/structural/torso/Waist Bearing Connector v1.SLDPRT
37.3 x 4.95 x 53.5 mm
