KoalbyMQP/Hardware-Parts/mechanical/Simulation Files/SolidWorks/URDF_Links_Parts/bicep_left.SLDPRT

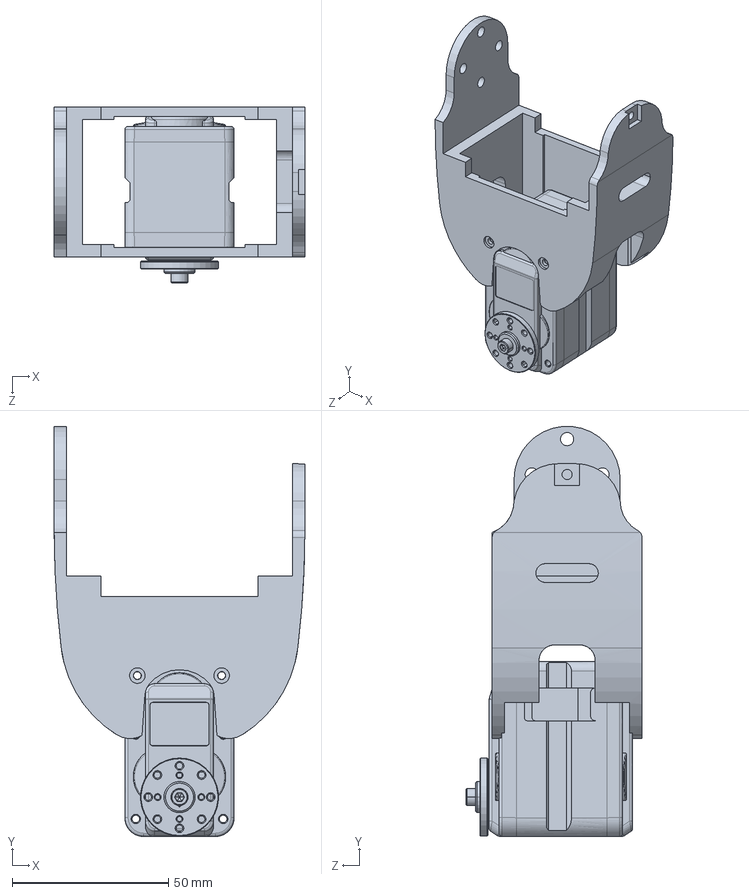
[picture p60: CAD file, 2025-09-10]
mechanical/Simulation Files/SolidWorks/URDF_Links_Parts/bicep_left.SLDPRT
80.2 x 131.3 x 56.4 mm
