KoalbyMQP/Hardware-Parts/mechanical/cad/parts/custom/structural/torso/Pelvis v1.SLDPRT

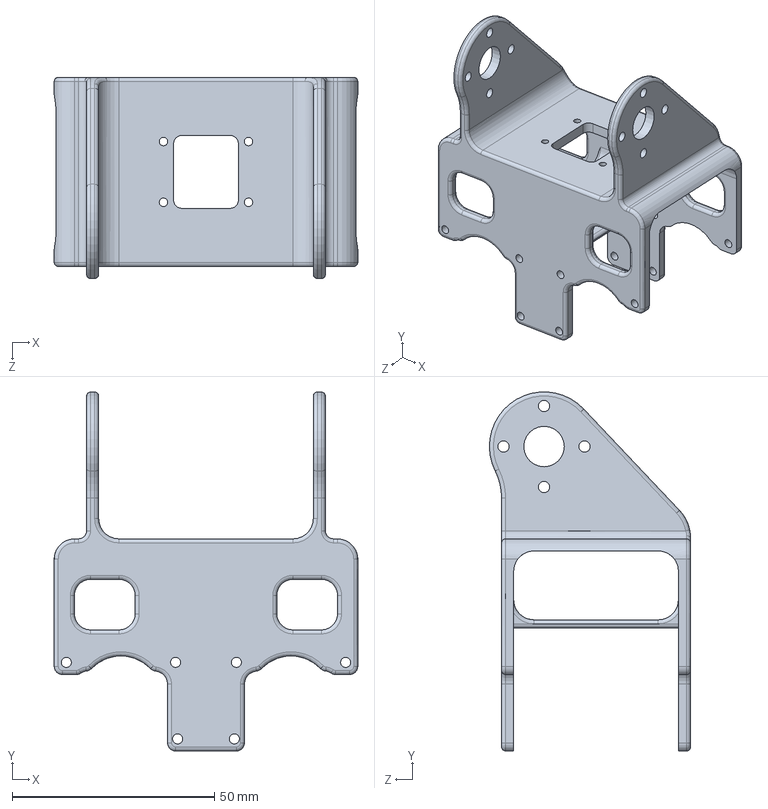
[picture p61: CAD file, 2025-09-24]
mechanical/cad/parts/custom/structural/torso/Pelvis v1.SLDPRT
75.0 x 88.7 x 49.7 mm
