KoalbyMQP/Hardware-Parts/mechanical/cad/parts/custom/KneeGearboxRedesign/24T_Gear.SLDPRT

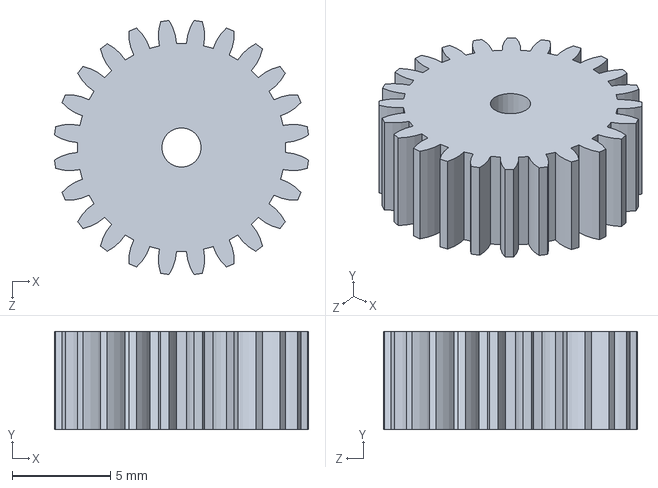
[picture p62: CAD file, 2025-12-09]
mechanical/cad/parts/custom/KneeGearboxRedesign/24T_Gear.SLDPRT
12.9 x 5.00 x 12.9 mm
