KoalbyMQP/Hardware-Parts/mechanical/cad/parts/custom/structural/torso/Chest v1.SLDPRT

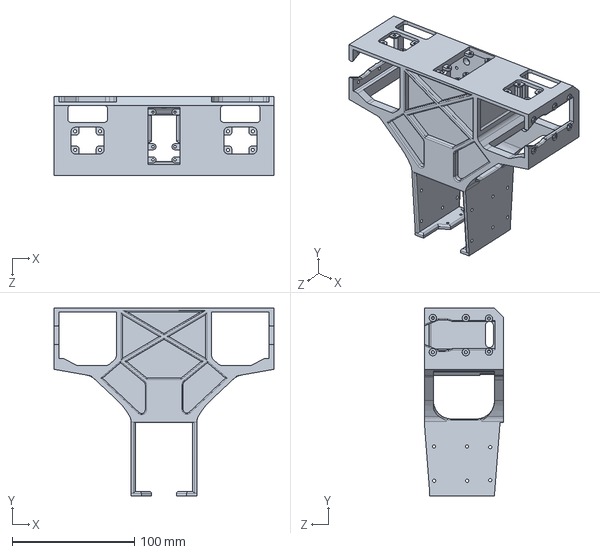
[picture p63: CAD file, 2025-09-24]
mechanical/cad/parts/custom/structural/torso/Chest v1.SLDPRT
180.0 x 153.5 x 65.0 mm
