KoalbyMQP/Hardware-Parts/mechanical/Simulation Files/SolidWorks/URDF_Links_Parts/hipconnector_right.SLDPRT

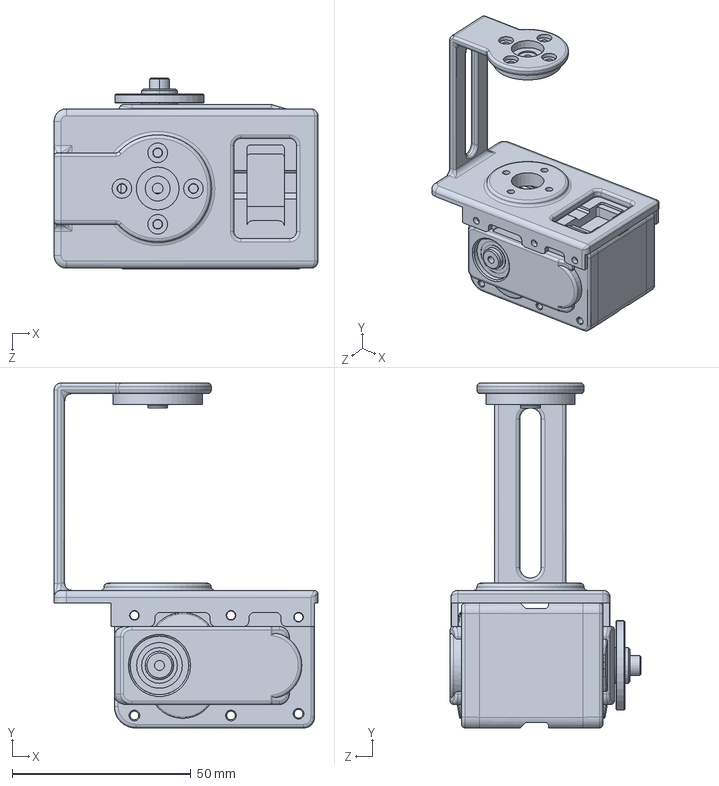
[picture p64: CAD file, 2025-09-10]
mechanical/Simulation Files/SolidWorks/URDF_Links_Parts/hipconnector_right.SLDPRT
73.8 x 96.5 x 53.4 mm
