KoalbyMQP/Hardware-Parts/mechanical/cad/parts/custom/KneeGearboxRedesign/GearboxTestRig.SLDPRT

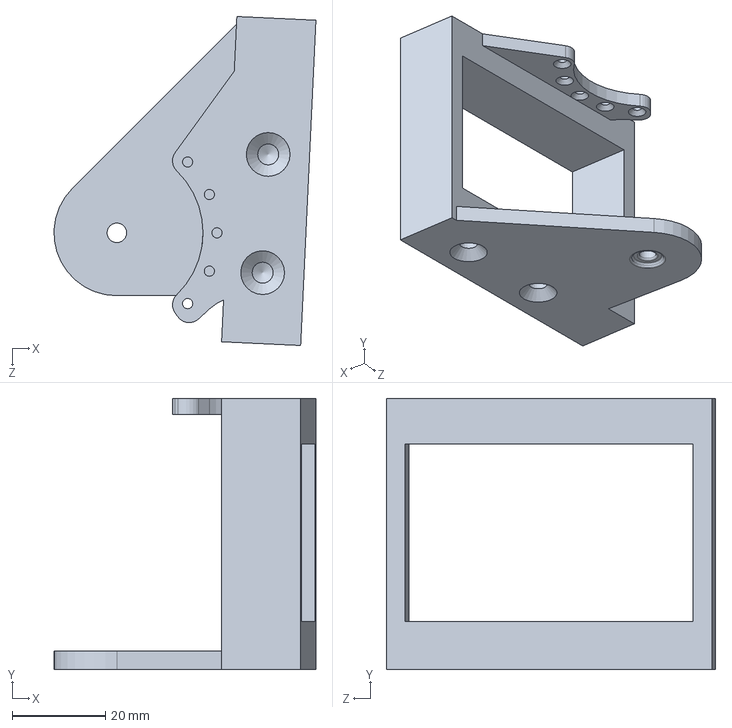
[picture p65: CAD file, 2025-12-09]
mechanical/cad/parts/custom/KneeGearboxRedesign/GearboxTestRig.SLDPRT
56.2 x 58.2 x 70.6 mm
