KoalbyMQP/Hardware-Parts/mechanical/Simulation Files/SolidWorks/URDF_Links_Parts/hip_right.SLDPRT

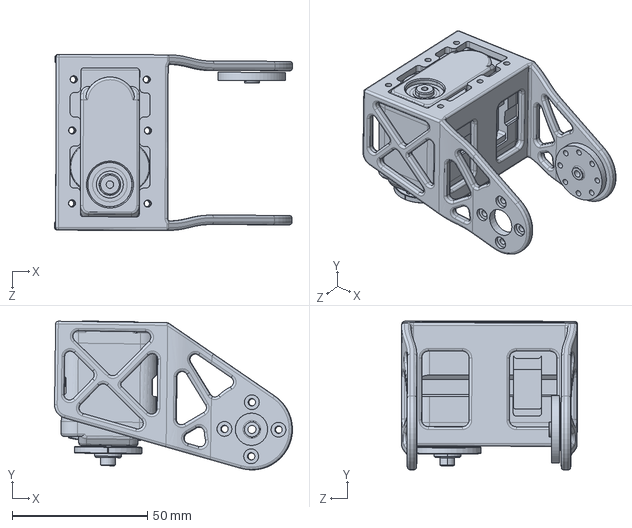
[picture p66: CAD file, 2025-09-10]
mechanical/Simulation Files/SolidWorks/URDF_Links_Parts/hip_right.SLDPRT
88.1 x 55.1 x 65.2 mm
