KoalbyMQP/Hardware-Parts/mechanical/Simulation Files/SolidWorks/URDF_Links_Parts/shoulder_right.SLDPRT

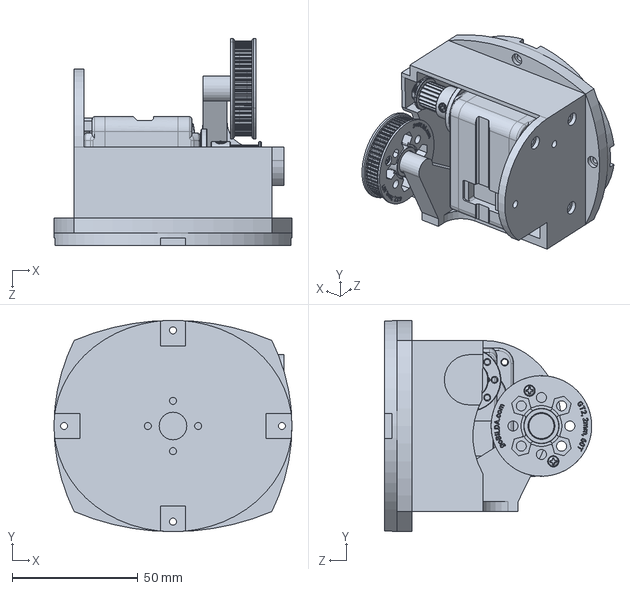
[picture p67: CAD file, 2025-09-10]
mechanical/Simulation Files/SolidWorks/URDF_Links_Parts/shoulder_right.SLDPRT
94.6 x 84.0 x 82.5 mm
