KoalbyMQP/Hardware-Parts/mechanical/Simulation Files/SolidWorks/URDF_Links_Parts/thigh_left.SLDPRT

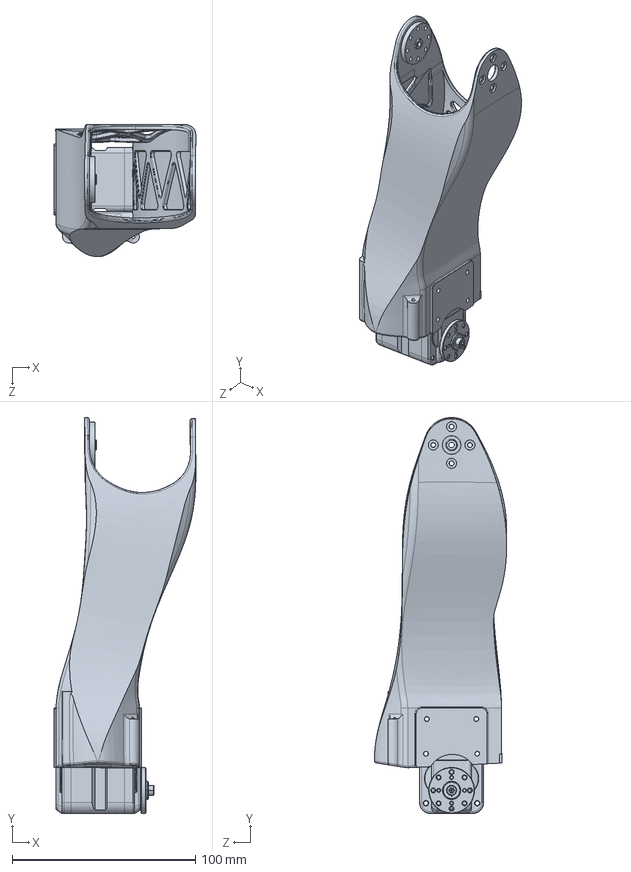
[picture p68: CAD file, 2025-09-10]
mechanical/Simulation Files/SolidWorks/URDF_Links_Parts/thigh_left.SLDPRT
77.3 x 216.0 x 72.2 mm
