KoalbyMQP/Hardware-Parts/mechanical/Simulation Files/SolidWorks/URDF_Links_Parts/abdominals.SLDPRT

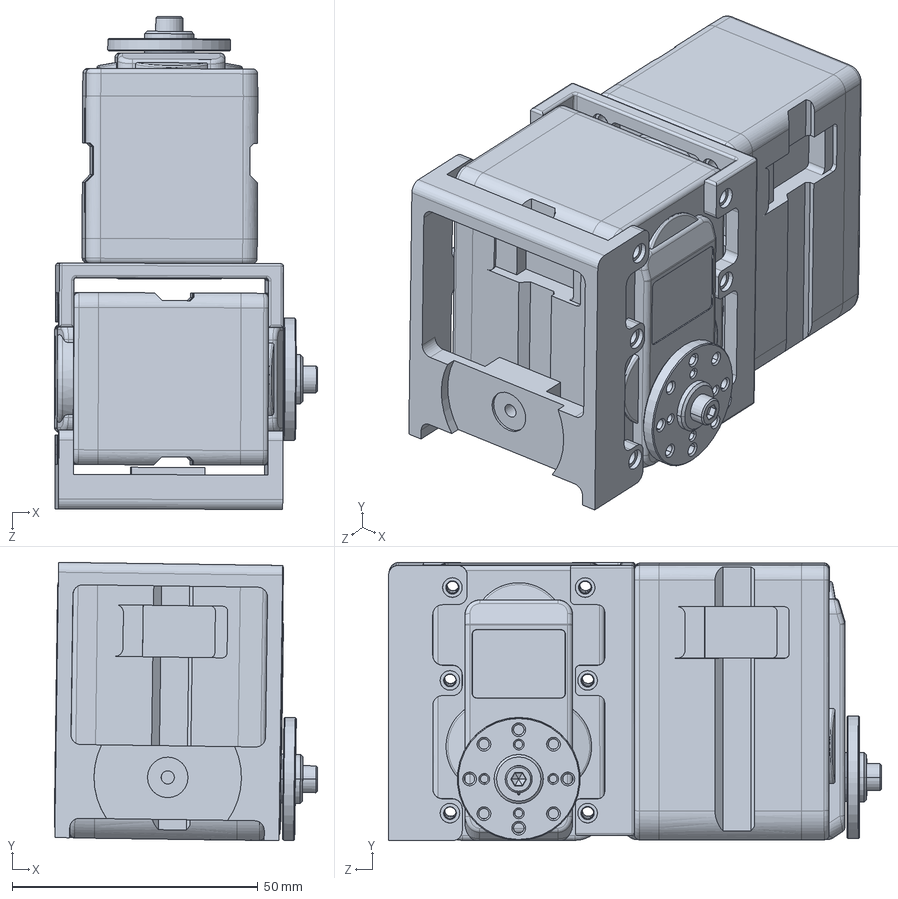
[picture p69: CAD file, 2025-09-10]
mechanical/Simulation Files/SolidWorks/URDF_Links_Parts/abdominals.SLDPRT
53.6 x 56.6 x 100.3 mm
