KoalbyMQP/Hardware-Parts/mechanical/Simulation Files/SolidWorks/URDF_Links_Parts/pelvis.SLDPRT

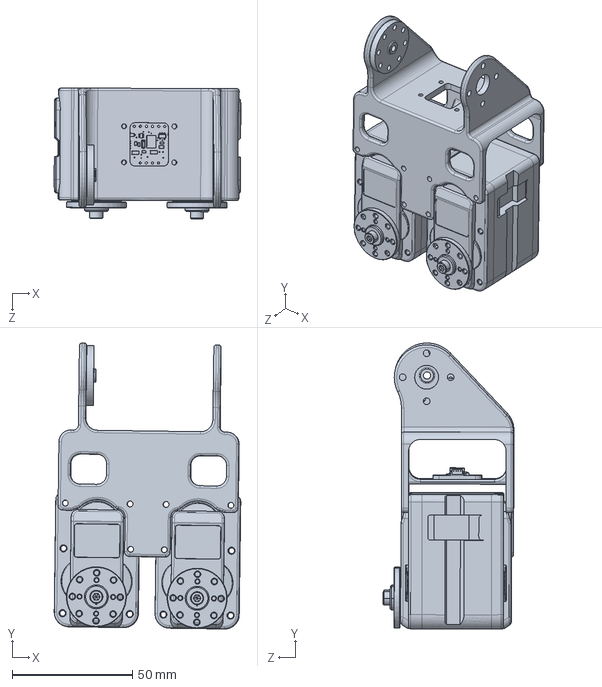
[picture p70: CAD file, 2025-09-10]
mechanical/Simulation Files/SolidWorks/URDF_Links_Parts/pelvis.SLDPRT
77.7 x 119.1 x 54.5 mm
