KoalbyMQP/Hardware-Parts/mechanical/Simulation Files/SolidWorks/URDF_Links_Parts/waist.SLDPRT

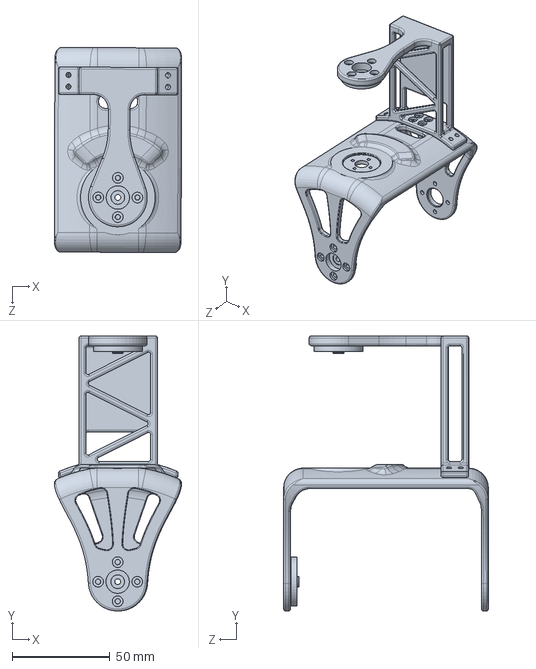
[picture p71: CAD file, 2025-09-10]
mechanical/Simulation Files/SolidWorks/URDF_Links_Parts/waist.SLDPRT
65.1 x 140.4 x 104.7 mm
