KoalbyMQP/Hardware-Parts/mechanical/Simulation Files/SolidWorks/URDF_Links_Parts/hip_left.SLDPRT

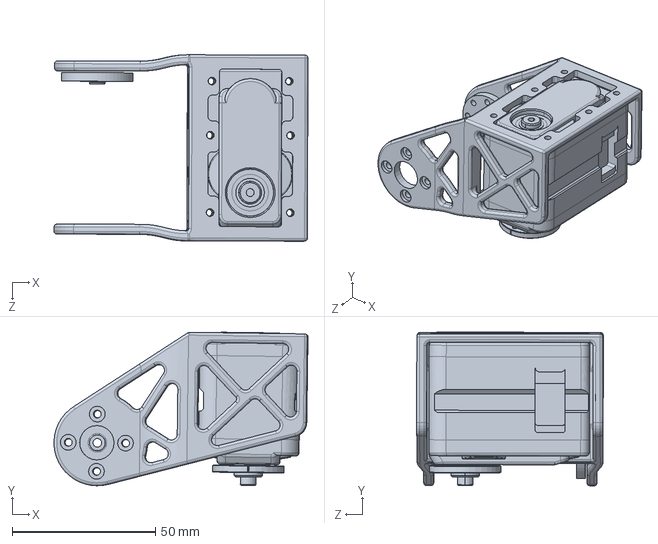
[picture p72: CAD file, 2025-09-10]
mechanical/Simulation Files/SolidWorks/URDF_Links_Parts/hip_left.SLDPRT
88.7 x 53.6 x 65.2 mm
