KoalbyMQP/Hardware-Parts/mechanical/Simulation Files/SolidWorks/URDF_Links_Parts/chest.SLDPRT

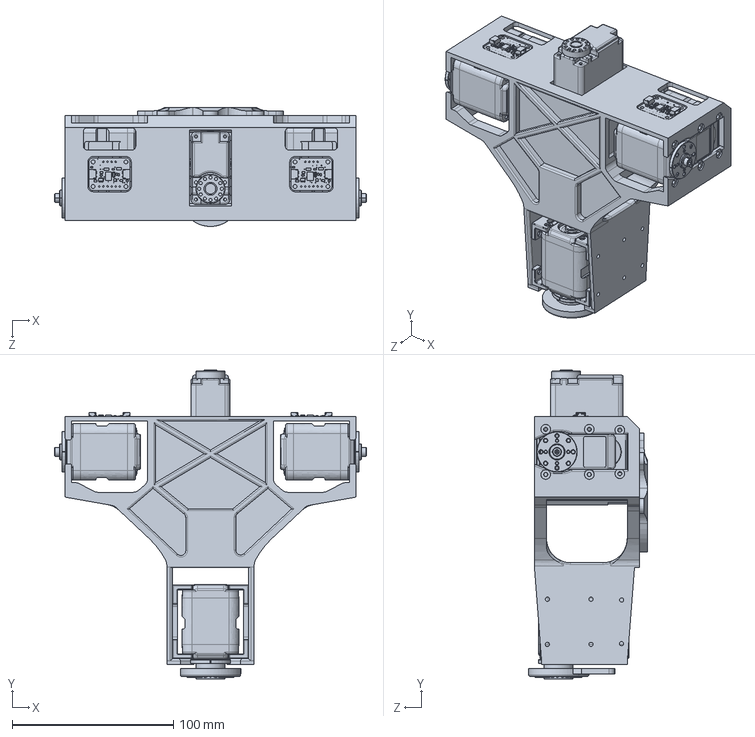
[picture p73: CAD file, 2025-09-10]
mechanical/Simulation Files/SolidWorks/URDF_Links_Parts/chest.SLDPRT
193.2 x 191.3 x 73.6 mm
