KoalbyMQP/Hardware-Parts/mechanical/Simulation Files/SolidWorks/URDF_Links_Parts/hand_right.SLDPRT

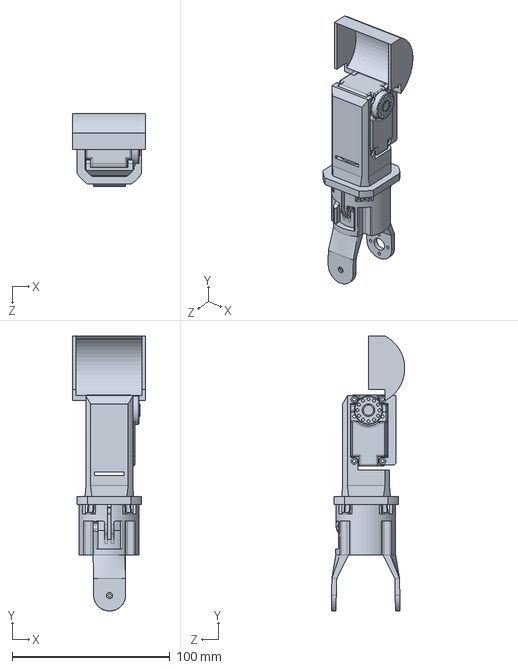
[picture p74: CAD file, 2025-09-10]
mechanical/Simulation Files/SolidWorks/URDF_Links_Parts/hand_right.SLDPRT
46.0 x 174.2 x 46.5 mm
