KoalbyMQP/Hardware-Parts/mechanical/Simulation Files/SolidWorks/URDF_Links_Parts/shin_right.SLDPRT

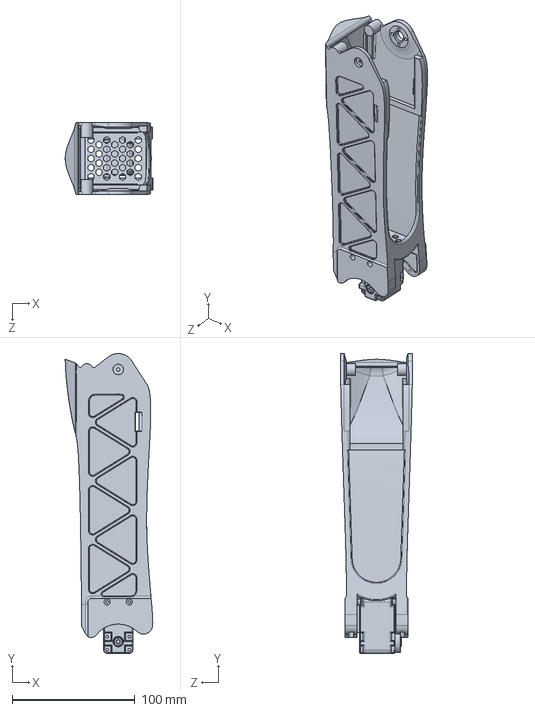
[picture p75: CAD file, 2025-09-10]
mechanical/Simulation Files/SolidWorks/URDF_Links_Parts/shin_right.SLDPRT
71.3 x 244.5 x 59.0 mm
