KoalbyMQP/Hardware-Parts/mechanical/cad/assemblies/subsystems/arm/Arm Assembly.SLDASM

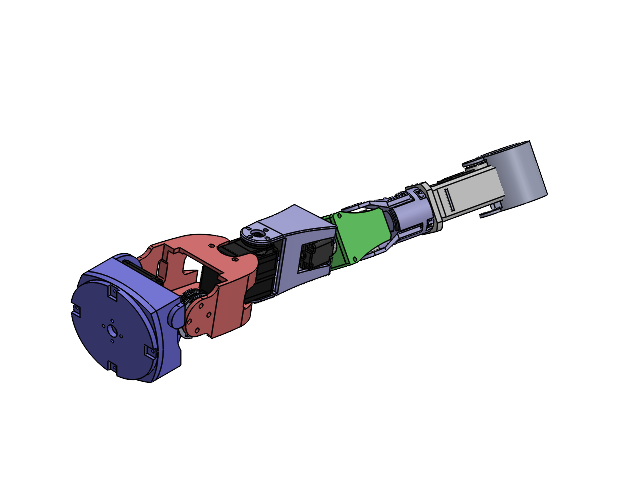
[picture p76: CAD file, 2025-09-24]
mechanical/cad/assemblies/subsystems/arm/Arm Assembly.SLDASM
Shoulder Adapter v1
Wrist Mounting Pyramid v1
Wrist v1
Lower Forearm v1
Upper Forearm v1
Bicep v1
Lower Forearm Bracket v1
herkulex_0601 x 2
herkulex_0201 x 3
electromagnet
WristMotorMount
5-8ths_Magnet
Magnet_Shroud
SmallScoopFixed v1
SmallScoopFloat v1
Shoulder v1
3684N13_Corrosion-Resistant HTD Timing Belt Pulley
90265A199_18-8 Stainless Steel Shoulder Screw
3421-0014-0060.STEP x 2
3421-0014-0060 screw.STEP x 4
5905K354_Needle-Roller Bearing
