KoalbyMQP/Hardware-Parts/mechanical/cad/assemblies/subsystems/head/Head Assembly.SLDASM

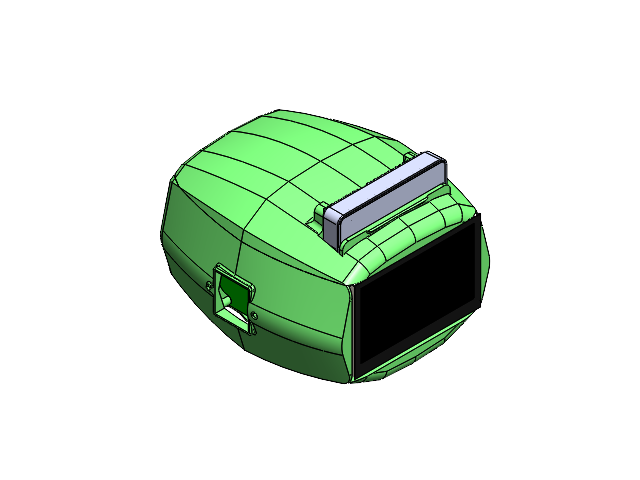
[picture p77: CAD file, 2025-09-24]
mechanical/cad/assemblies/subsystems/head/Head Assembly.SLDASM
Head v1
Head Lid v1
Head Mounting Bracket v1
Neck v1
Blindfold v1
Arduino_Mega
PCB_RPi4ModelB
D-LITE-LENS-ADHESIVE.stp
609-00004_1.stp
606-00008_V01-20211224_1.stp
611-00008_1.stp x 2
611-00009_1.stp
611-00015_1.stp
606-00009_V01-20211224_1.stp
612-00002_1.stp
602-00001.stp x 4
LCD
RPiFan
herkulex_0201
