KoalbyMQP/Hardware-Parts/mechanical/cad/assemblies/subsystems/leg/Left Leg Assembly.SLDASM

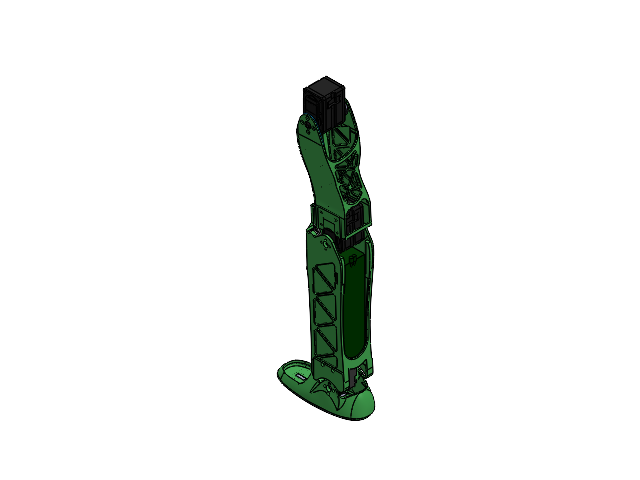
[picture p78: CAD file, 2025-09-24]
mechanical/cad/assemblies/subsystems/leg/Left Leg Assembly.SLDASM
Left Shin v1
Left Thigh v1
Foot v1
Foot Sole v1
9271K612_Torsion_Spring
9271K677_Torsion_Spring
0601_No_Horn
herkulex_0201
herkulex_0601
0601 Spacer v1
Battery
