KoalbyMQP/Hardware-Parts/mechanical/cad/assemblies/subsystems/torso/Torso Assembly.SLDASM

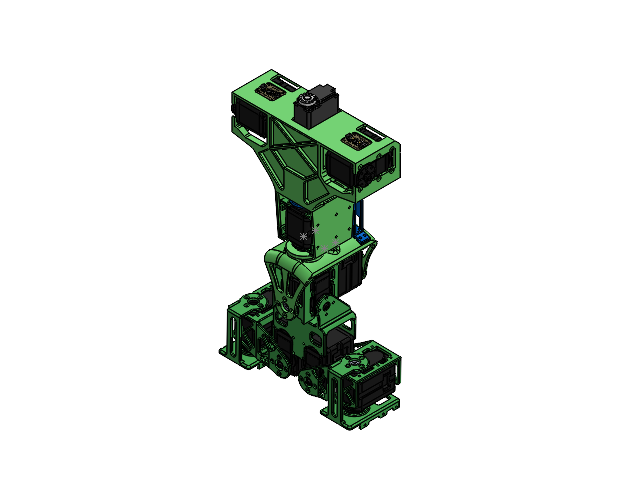
[picture p79: CAD file, 2025-09-24]
mechanical/cad/assemblies/subsystems/torso/Torso Assembly.SLDASM
Chest v1
Waist Bearing Connector v1
Motor Mount A v1 x 3
Abdomen v1
Back Hook v1
Waist Horn Spacer v1
Motor Mount B v1
Pelvis v1
Left Hip v1
Hip Connector v1 x 2
Right Hip v1
Switch Mount v1
0601 Spacer v1 x 6
herkulex_0601 x 9
herkulex_0201
Board.step x 3
BNO055.step x 3
10K.step x 15
1n4148.step x 3
10uF.step x 6
AP2112K-3.3.step x 3
10K_1.step x 6
BSS138.step x 3
STEMMA_I2C_QT.step x 6
GREEN.step x 3
32.768.step x 3
5909K33_Needle_Roller_Thrust_Bearing
