KoalbyMQP/Hardware-Parts/mechanical/cad/assemblies/subsystems/arm/FinleyPulleyShoulderAssy.SLDASM

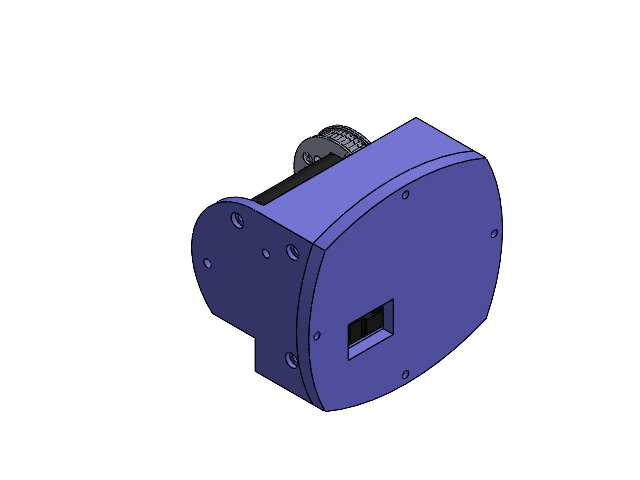
[picture p80: CAD file, 2025-09-24]
mechanical/cad/assemblies/subsystems/arm/FinleyPulleyShoulderAssy.SLDASM
Shoulder v1
herkulex_0601
3684N13_Corrosion-Resistant HTD Timing Belt Pulley
90265A199_18-8 Stainless Steel Shoulder Screw
3421-0014-0060.STEP x 2
3421-0014-0060 screw.STEP x 4
5905K354_Needle-Roller Bearing
