KoalbyMQP/Hardware-Parts/mechanical/cad/assemblies/subsystems/hand/MotorMagnetAssem.SLDASM

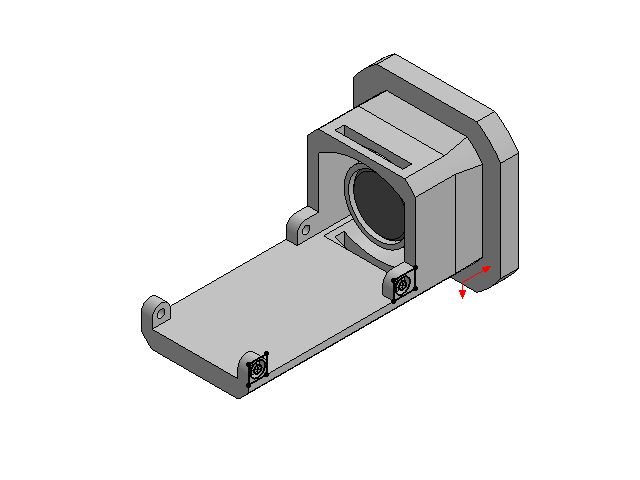
[picture p81: CAD file, 2025-09-10]
mechanical/cad/assemblies/subsystems/hand/MotorMagnetAssem.SLDASM
WristMotorMount
5-8ths_Magnet
