KoalbyMQP/Hardware-Parts/mechanical/cad/parts/custom/mounts/Mounts_Head/Head_Boards_Mount.SLDASM

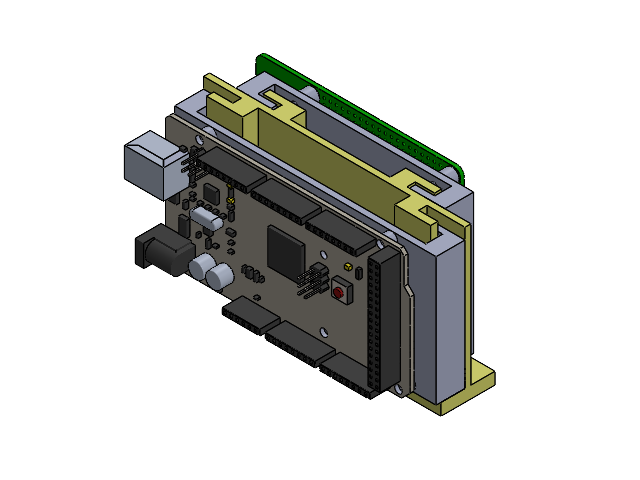
[picture p83: CAD file, 2025-09-24]
mechanical/cad/parts/custom/mounts/Mounts_Head/Head_Boards_Mount.SLDASM
Arduino_Backplate_Head
RPi_Backplate_Head
PCB_RPi4ModelB
Arduino_Mega
Head_Boards_Mount_2
