KoalbyMQP/Hardware-Parts/mechanical/cad/assemblies/New Motor Attachment/Assy.SLDASM

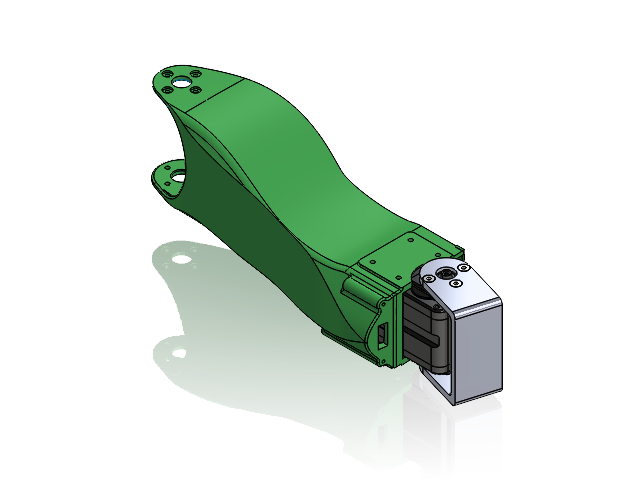
[picture p84: CAD file, 2025-09-24]
mechanical/cad/assemblies/New Motor Attachment/Assy.SLDASM
herkulex_0601
Countersunk Motor Bracket
97505A103_Slotted Low-Profile Steel Shoulder Screw
92125A126_18-8 Stainless Steel Hex Drive Flat Head Screw x 3
Left Thigh v1
