KoalbyMQP/Hardware-Parts/mechanical/cad/assemblies/subsystems/leg/16-24_Gearbox.SLDASM

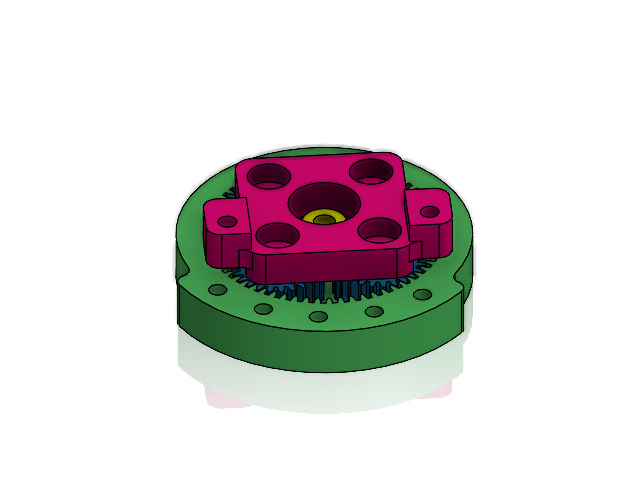
[picture p85: CAD file, 2025-09-03]
mechanical/cad/assemblies/subsystems/leg/16-24_Gearbox.SLDASM
16-24Ring
16TGear
24T_Gear
24T_Carrier
