KoalbyMQP/Hardware-Parts/mechanical/cad/parts/custom/structural/arms/Finley Shoulder Pulley/3421-0014-0060/3421-0014-0060 SW assembly.SLDASM

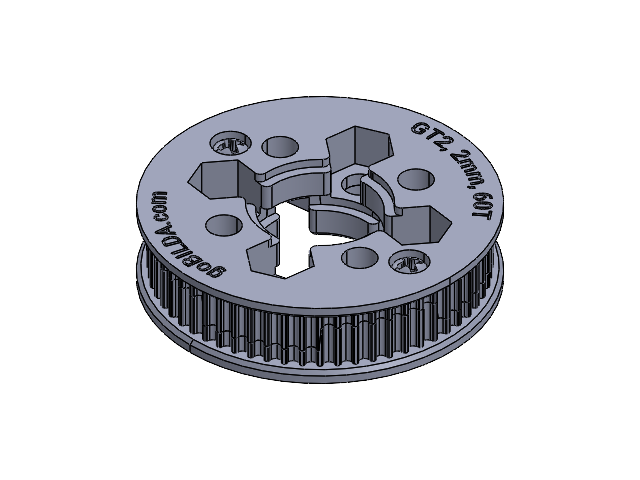
[picture p86: CAD file, 2025-09-03]
mechanical/cad/parts/custom/structural/arms/Finley Shoulder Pulley/3421-0014-0060/3421-0014-0060 SW assembly.SLDASM
3421-0014-0060.STEP x 2
3421-0014-0060 screw.STEP x 4
