KoalbyMQP/Hardware-Parts/mechanical/cad/parts/custom/KneeGearboxRedesign/Test Rig Assem.SLDASM

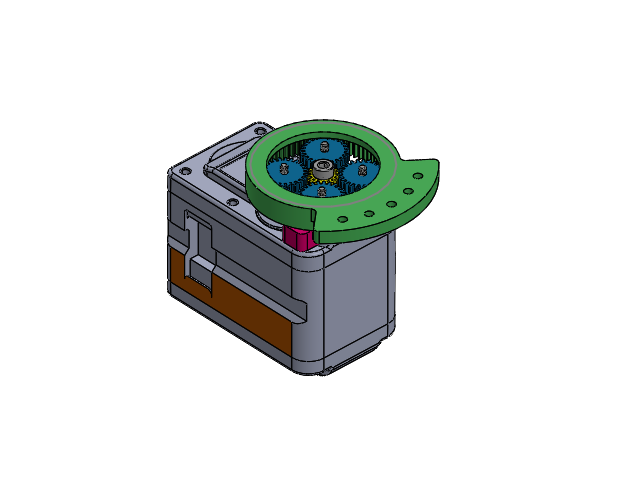
[picture p87: CAD file, 2025-12-09]
mechanical/cad/parts/custom/KneeGearboxRedesign/Test Rig Assem.SLDASM
24T_Carrier
16-24Ring
90236A107_(M2x12mm) x 4
24T_Gear x 4
16TGear
91290A111_(M3x6mm)
0601_No_Horn
