KoalbyMQP/Hardware-Parts/(list of files, cad)

Other CAD files:
mechanical/cad/parts/custom/structural/arms/Finley Shoulder Pulley/3421-0014-0060/3421-0014-0060 assembly.STEP
Chess/Chess clock/Chess clock top.stl
Chess/Pieces/Bishop/Bishop.step
Chess/Pieces/King/King - Part 2.step
Chess/Pieces/Knight/Knight.step
Chess/Pieces/Pawn/Pawn.step
Chess/Pieces/Rook/Rook Version 2.step
mechanical/Simulation Files/URDFs/Humanoid_URDF_9-10/meshes/waist.STL
Chess/Chess clock/CLOCK.step
mechanical/cad/parts/custom/structural/torso/Right Hip v1.SLDPRT
mechanical/Simulation Files/URDFs/Humanoid_URDF_9-10/meshes/abdominals.STL
mechanical/Simulation Files/URDFs/Humanoid_URDF_9-10/meshes/forearm_left.STL
mechanical/cad/parts/custom/structural/legs/Left Thigh v1.SLDPRT
mechanical/Simulation Files/SolidWorks/URDF_Links_Parts/foot_left.SLDPRT
mechanical/Simulation Files/URDFs/Humanoid_URDF_9-10/meshes/shin_left.STL
mechanical/cad/parts/custom/structural/arms/Finley Shoulder Pulley/PulleyShoulderFIN_3-31 (Right).STL
mechanical/Simulation Files/SolidWorks/URDF_Links_Parts/gripper_left.SLDPRT
mechanical/Simulation Files/URDFs/Humanoid_URDF_9-10/meshes/hip_right.STL
mechanical/cad/parts/custom/structural/legs/Left Shin v1.SLDPRT
mechanical/Simulation Files/URDFs/Humanoid_URDF_9-10/meshes/hip_left.STL
mechanical/cad/parts/custom/structural/arms/herkulex_0201.SLDPRT
mechanical/Simulation Files/URDFs/Humanoid_URDF_9-10/meshes/wrist_left.STL
mechanical/Simulation Files/SolidWorks/URDF_Links_Parts/gripper_right.SLDPRT
mechanical/Simulation Files/URDFs/Humanoid_URDF_9-10/meshes/chest.STL
mechanical/Simulation Files/URDFs/Humanoid_URDF_9-10/meshes/head.STL
mechanical/Simulation Files/URDFs/Humanoid_URDF_9-10/meshes/thigh_left.STL
mechanical/Simulation Files/URDFs/Humanoid_URDF_9-10/meshes/hipconnector_right.STL
mechanical/Simulation Files/SolidWorks/URDF_Links_Parts/neck.SLDPRT
mechanical/Simulation Files/URDFs/Humanoid_URDF_9-10/meshes/gripper_left.STL
mechanical/Simulation Files/URDFs/Humanoid_URDF_9-10/meshes/bicep_right.STL
mechanical/Simulation Files/URDFs/Humanoid_URDF_9-10/meshes/forearm_right.STL
mechanical/Simulation Files/SolidWorks/URDF_Links_Parts/shoulder_left.SLDPRT
mechanical/Simulation Files/URDFs/Humanoid_URDF_9-10/meshes/hand_left.STL
mechanical/Simulation Files/SolidWorks/URDF_Links_Parts/thigh_right.SLDPRT
mechanical/Simulation Files/URDFs/Humanoid_URDF_9-10/meshes/shin_right.STL
mechanical/Simulation Files/SolidWorks/URDF_Links_Parts/wrist_right.SLDPRT
mechanical/Simulation Files/URDFs/Humanoid_URDF_9-10/meshes/foot_right.STL
mechanical/Simulation Files/URDFs/Humanoid_URDF_9-10/meshes/bicep_left.STL
mechanical/Simulation Files/URDFs/Humanoid_URDF_9-10/meshes/hand_right.STL
mechanical/Simulation Files/SolidWorks/URDF_Links_Parts/hipconnector_left.SLDPRT
mechanical/Simulation Files/URDFs/Humanoid_URDF_9-10/meshes/thigh_right.STL
mechanical/Simulation Files/SolidWorks/URDF_Links_Parts/forearm_right.SLDPRT
mechanical/Simulation Files/URDFs/Humanoid_URDF_9-10/meshes/pelvis.STL
mechanical/Simulation Files/SolidWorks/URDF_Links_Parts/bicep_right.SLDPRT
mechanical/Simulation Files/URDFs/Humanoid_URDF_9-10/meshes/shoulder_left.STL
mechanical/Simulation Files/URDFs/Humanoid_URDF_9-10/meshes/foot_left.STL
mechanical/Simulation Files/URDFs/Humanoid_URDF_9-10/meshes/gripper_right.STL
mechanical/Simulation Files/URDFs/Humanoid_URDF_9-10/meshes/neck.STL
mechanical/Simulation Files/URDFs/Humanoid_URDF_9-10/meshes/hipconnector_left.STL
mechanical/Simulation Files/SolidWorks/URDF_Links_Parts/hand_left.SLDPRT
mechanical/Simulation Files/URDFs/Humanoid_URDF_9-10/meshes/wrist_right.STL
mechanical/Simulation Files/SolidWorks/URDF_Links_Parts/shin_left.SLDPRT
mechanical/Simulation Files/URDFs/Humanoid_URDF_9-10/meshes/shoulder_right.STL
Chess/Pieces/Chess Board Squares/chess square v3.stl
mechanical/cad/assemblies/New Motor Attachment/92125A126_18-8 Stainless Steel Hex Drive Flat Head Screw.SLDPRT
mechanical/cad/assemblies/New Motor Attachment/97505A103_Slotted Low-Profile Steel Shoulder Screw.SLDPRT
mechanical/cad/assemblies/New Motor Attachment/Countersunk Motor Bracket.STL
mechanical/cad/parts/custom/KneeGearboxRedesign/90236A107_(M2x12mm).SLDPRT
mechanical/cad/parts/custom/KneeGearboxRedesign/90236A114_(M2.5x12mm).SLDPRT
mechanical/cad/parts/custom/KneeGearboxRedesign/91290A111_(M3x6mm).SLDPRT
mechanical/cad/parts/custom/mounts/Mounts_Head/Head_Boards_Mount.SLDPRT
mechanical/cad/parts/custom/structural/arms/Finley Shoulder Pulley/3684N13_Corrosion-Resistant HTD Timing Belt Pulley.SLDPRT
mechanical/cad/parts/custom/structural/arms/Finley Shoulder Pulley/5905K354_Needle-Roller Bearing.SLDPRT
mechanical/cad/parts/custom/structural/arms/Finley Shoulder Pulley/7947K717_High-Strength Ultra-Quiet Timing Belt.SLDPRT
mechanical/cad/parts/custom/structural/arms/Finley Shoulder Pulley/90265A199_18-8 Stainless Steel Shoulder Screw.SLDPRT
mechanical/cad/parts/custom/structural/arms/Finley Shoulder Pulley/90323A604_18-8 Stainless Steel Low-Profile Precision Shoulder Screw.SLDPRT
