KoalbyMQP/Hardware-Parts/mechanical/Simulation Files/Solidworks to URDF Export Guide.pdf

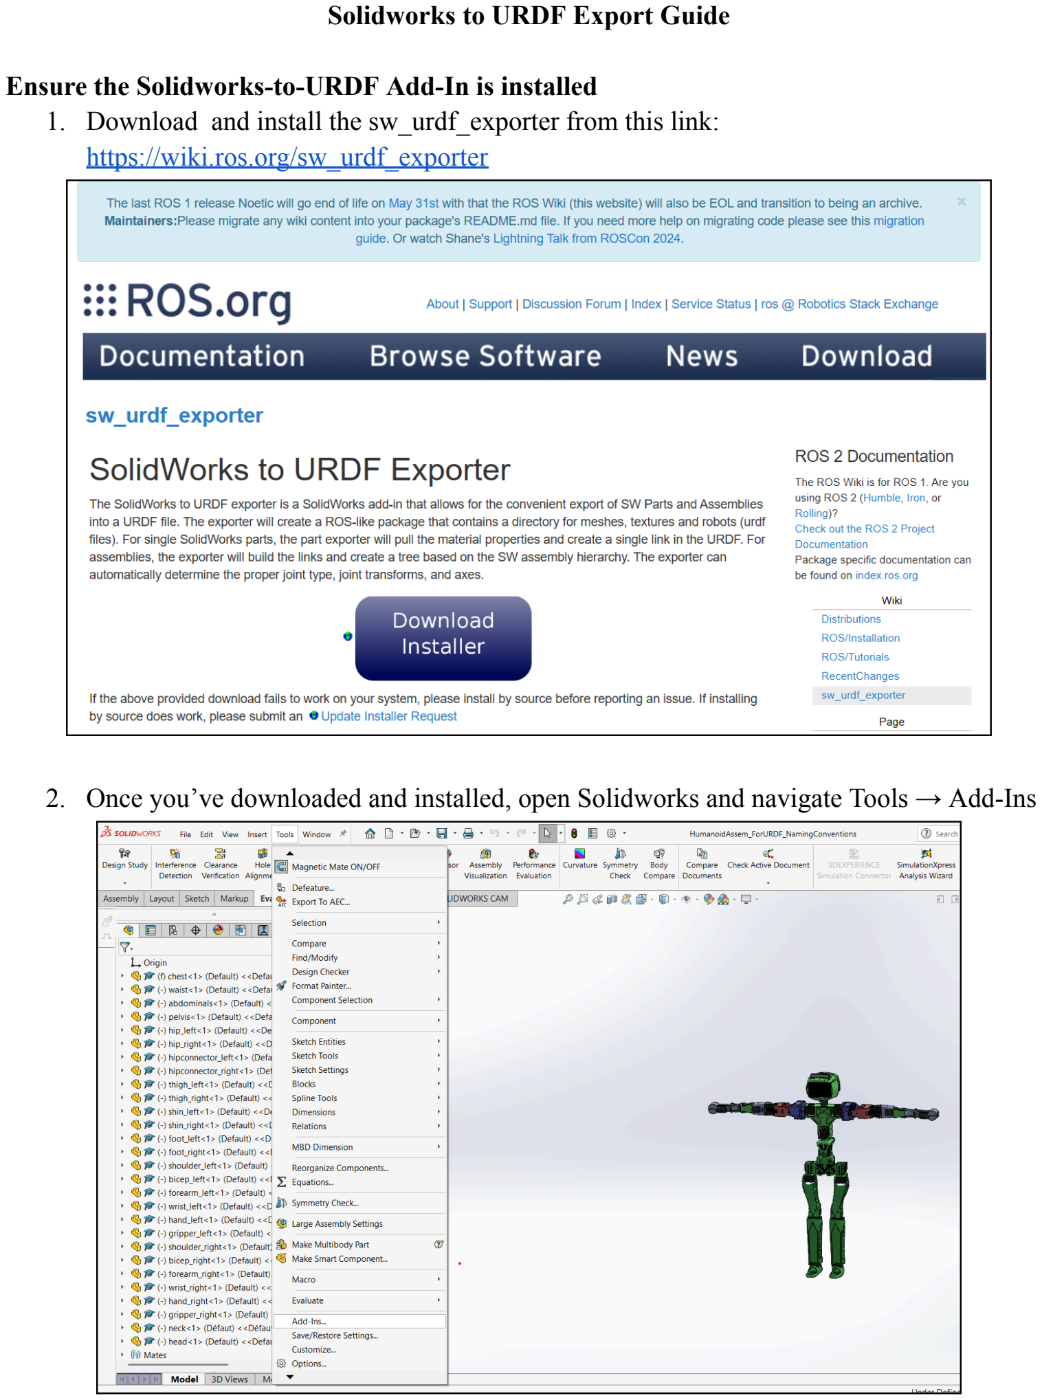
[picture p88: page 1]

Solidworks to URDF Export Guide

Ensure the Solidworks-to-URDF Add-In is installed
1. Download and install the sw_urdf_exporter from this link: https://wiki.ros.org/sw_urdf_exporter
2. Once you’ve downloaded and installed, open Solidworks and navigate Tools → Add-Ins

3. Activate the SW2URDF Add-In and click OK

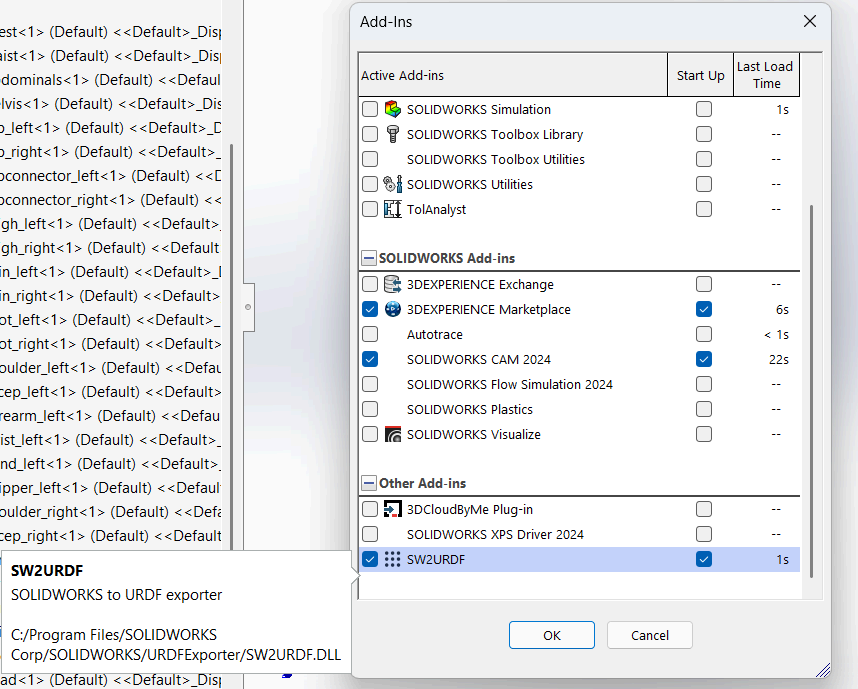
[picture p89: figure]
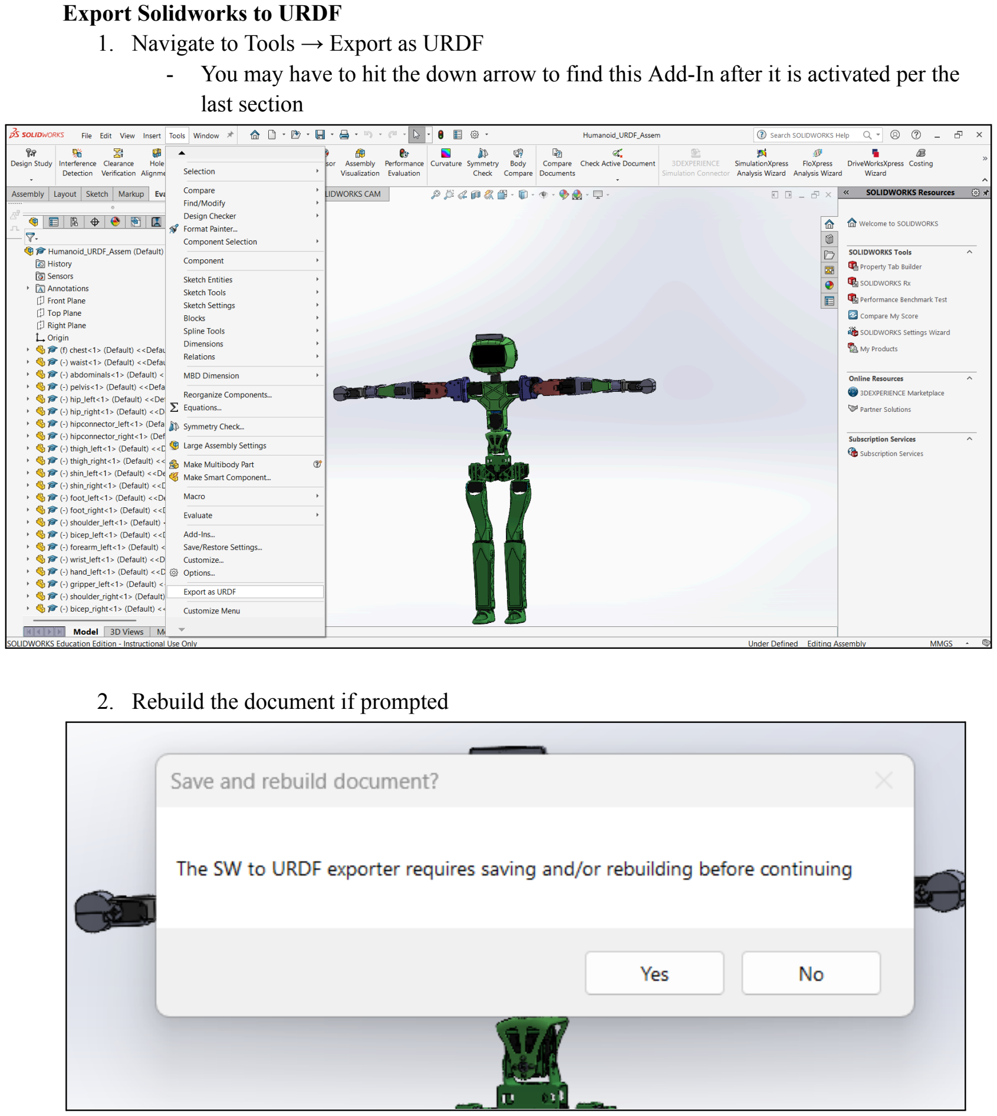
[picture p90: page 3]

Export Solidworks to URDF
1. Navigate to Tools → Export as URDF
- You may have to hit the down arrow to find this Add-In after it is activated per the last section
2. Rebuild the document if prompted

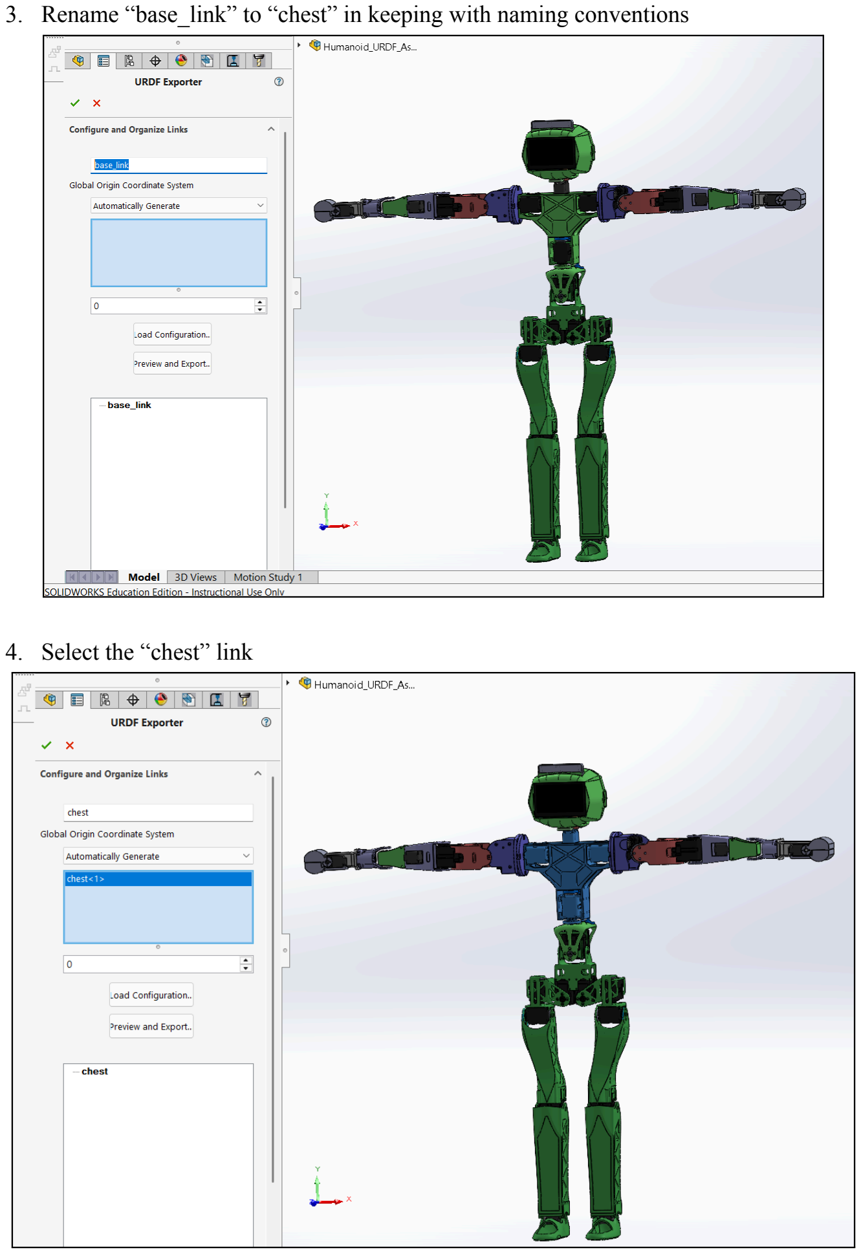
[picture p91: page 4]

3. Rename “base_link” to “chest” in keeping with naming conventions
4. Select the “chest” link

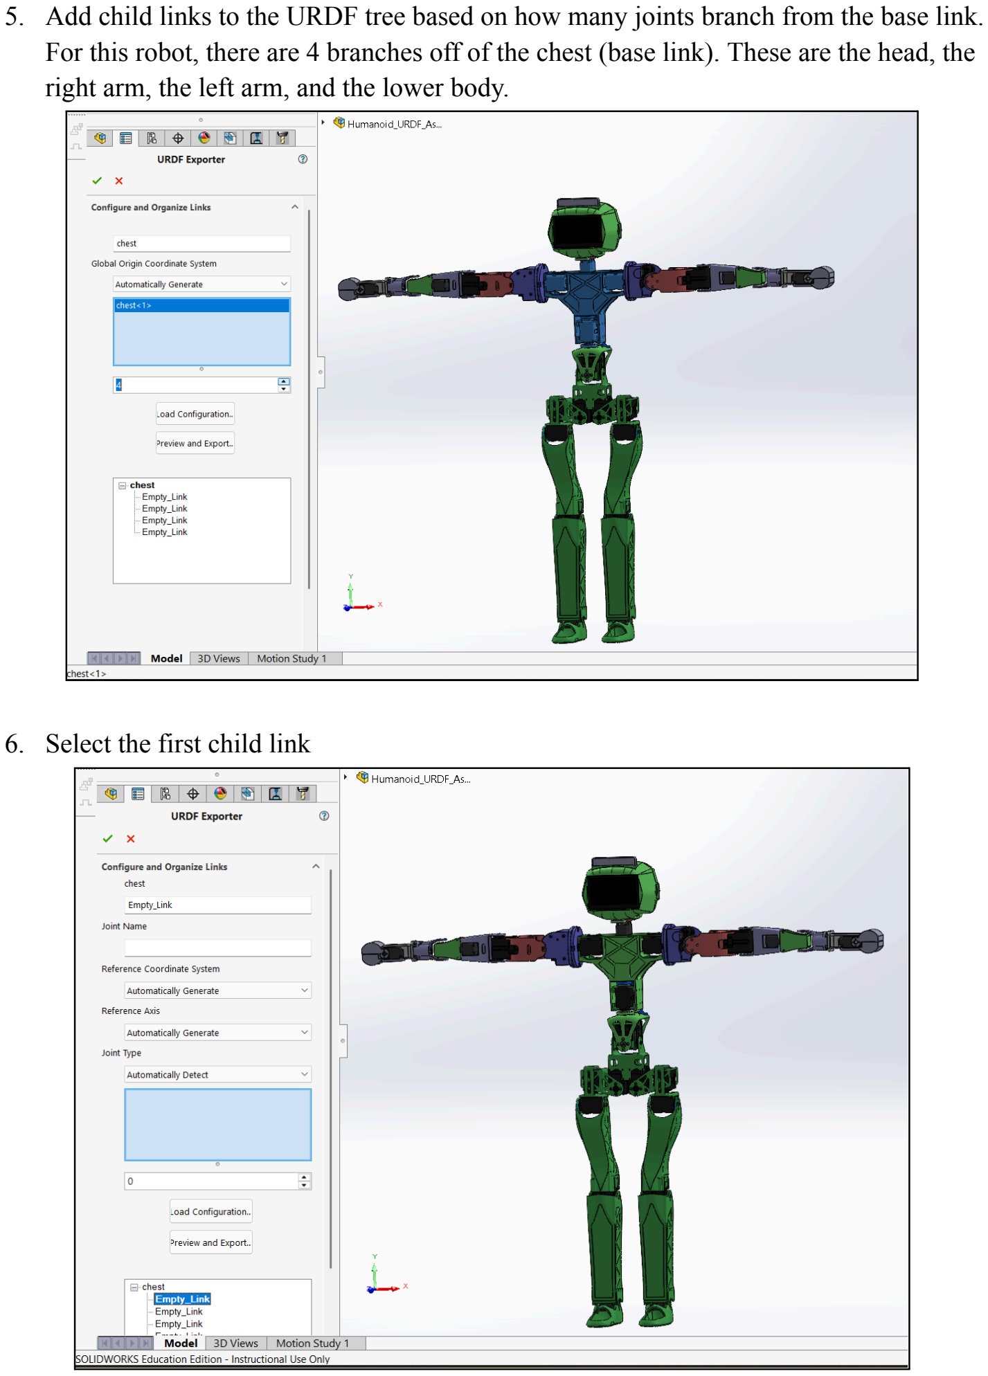
[picture p92: page 5]

5. Add child links to the URDF tree based on how many joints branch from the base link. For this robot, there are 4 branches off of the chest (base link). These are the head, the right arm, the left arm, and the lower body.
6. Select the first child link

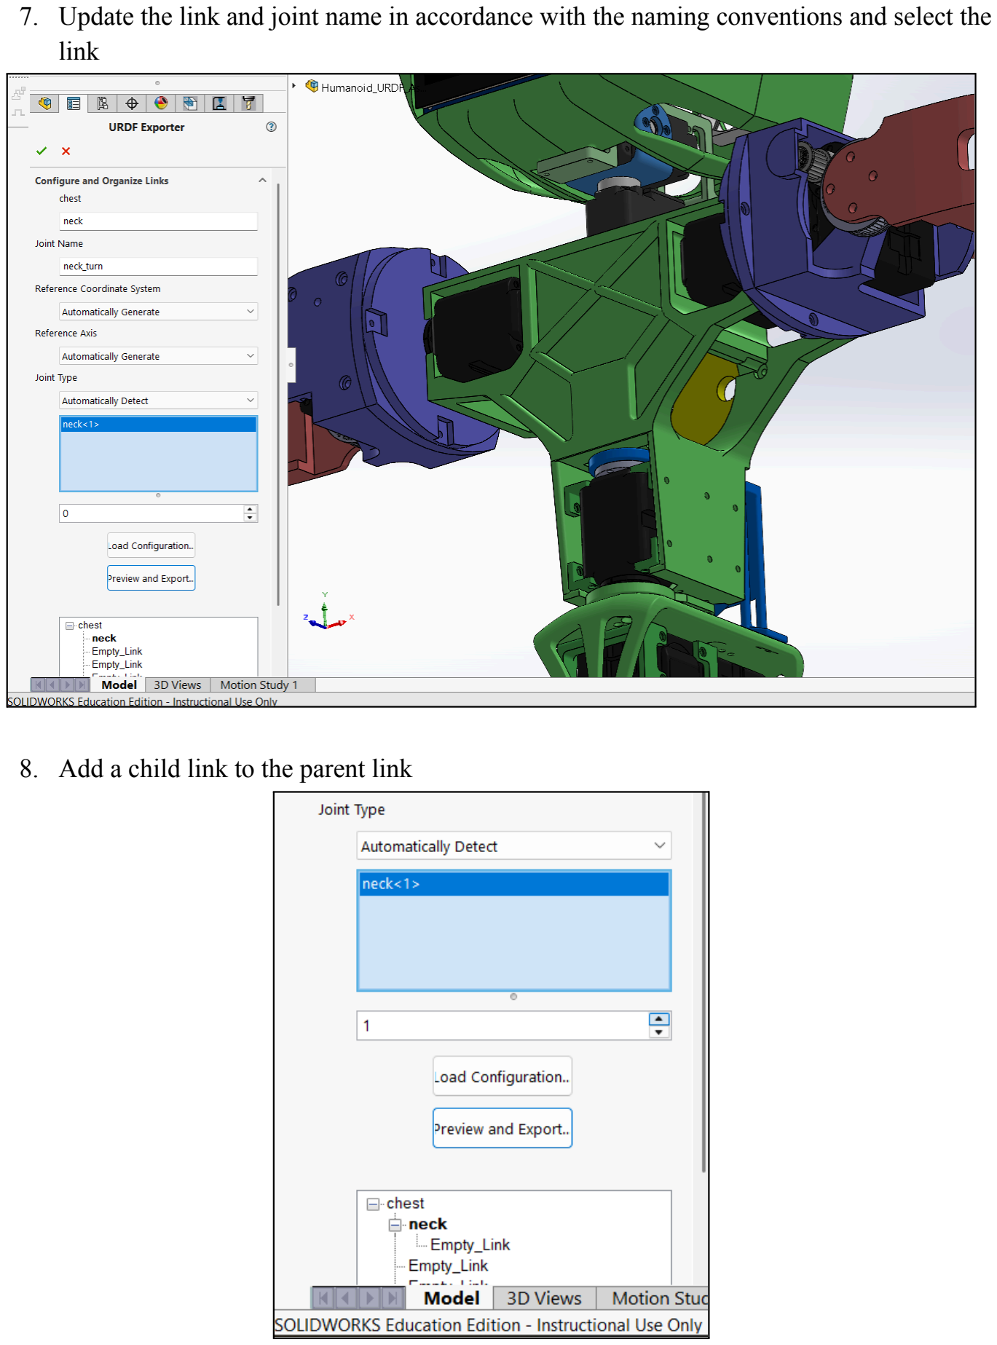
[picture p93: page 6]

7. Update the link and joint name in accordance with the naming conventions and select the link
8. Add a child link to the parent link

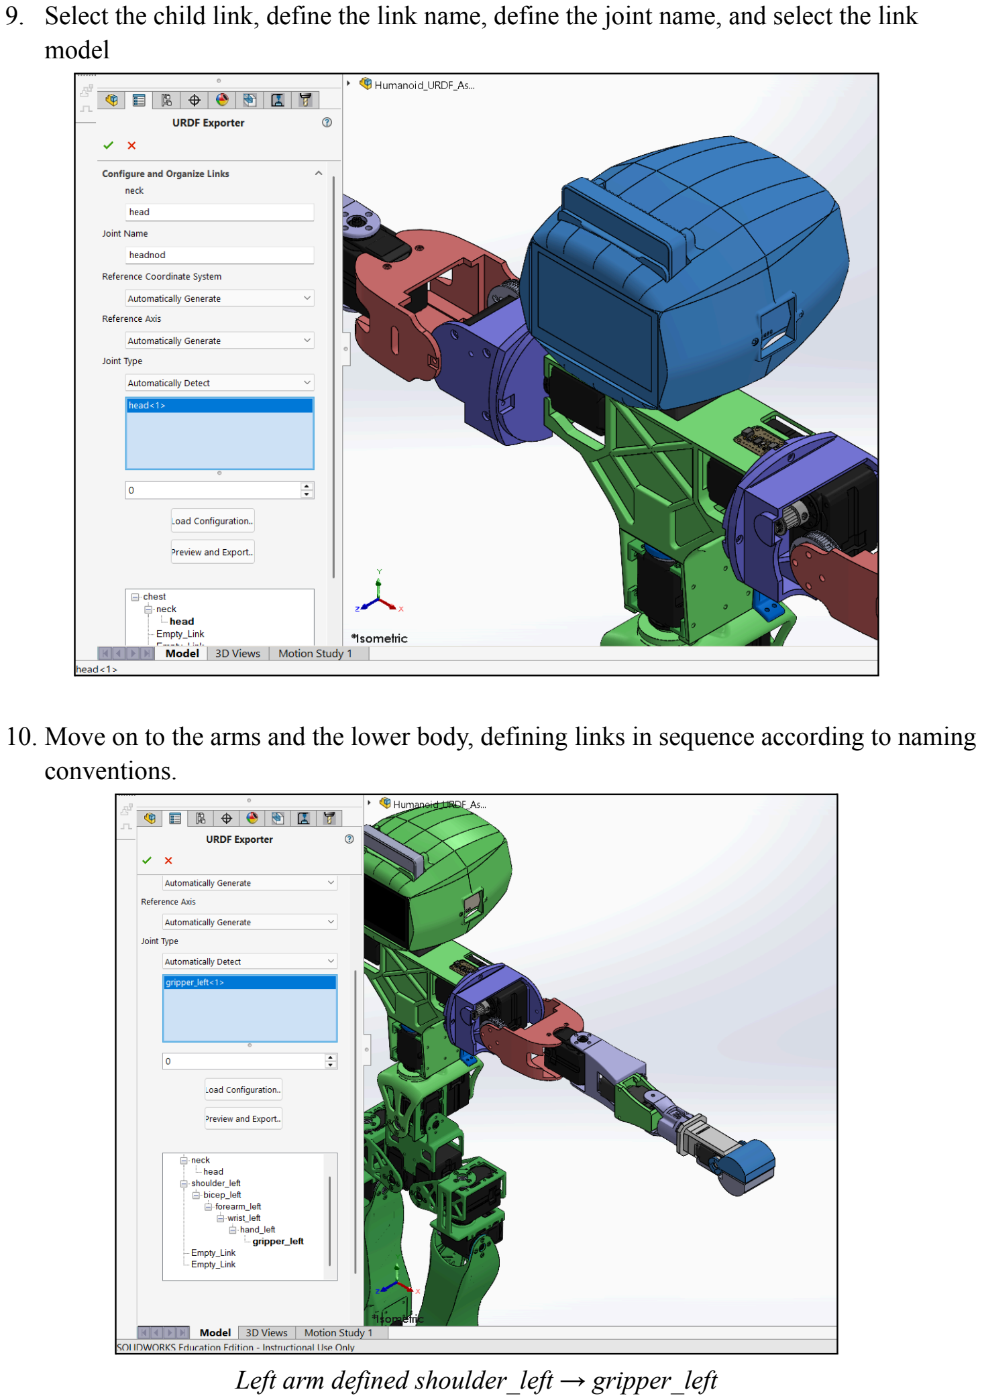
[picture p94: page 7]

9. Select the child link, define the link name, define the joint name, and select the link model
10. Move on to the arms and the lower body, defining links in sequence according to naming conventions.

Left arm defined shoulder_left → gripper_left

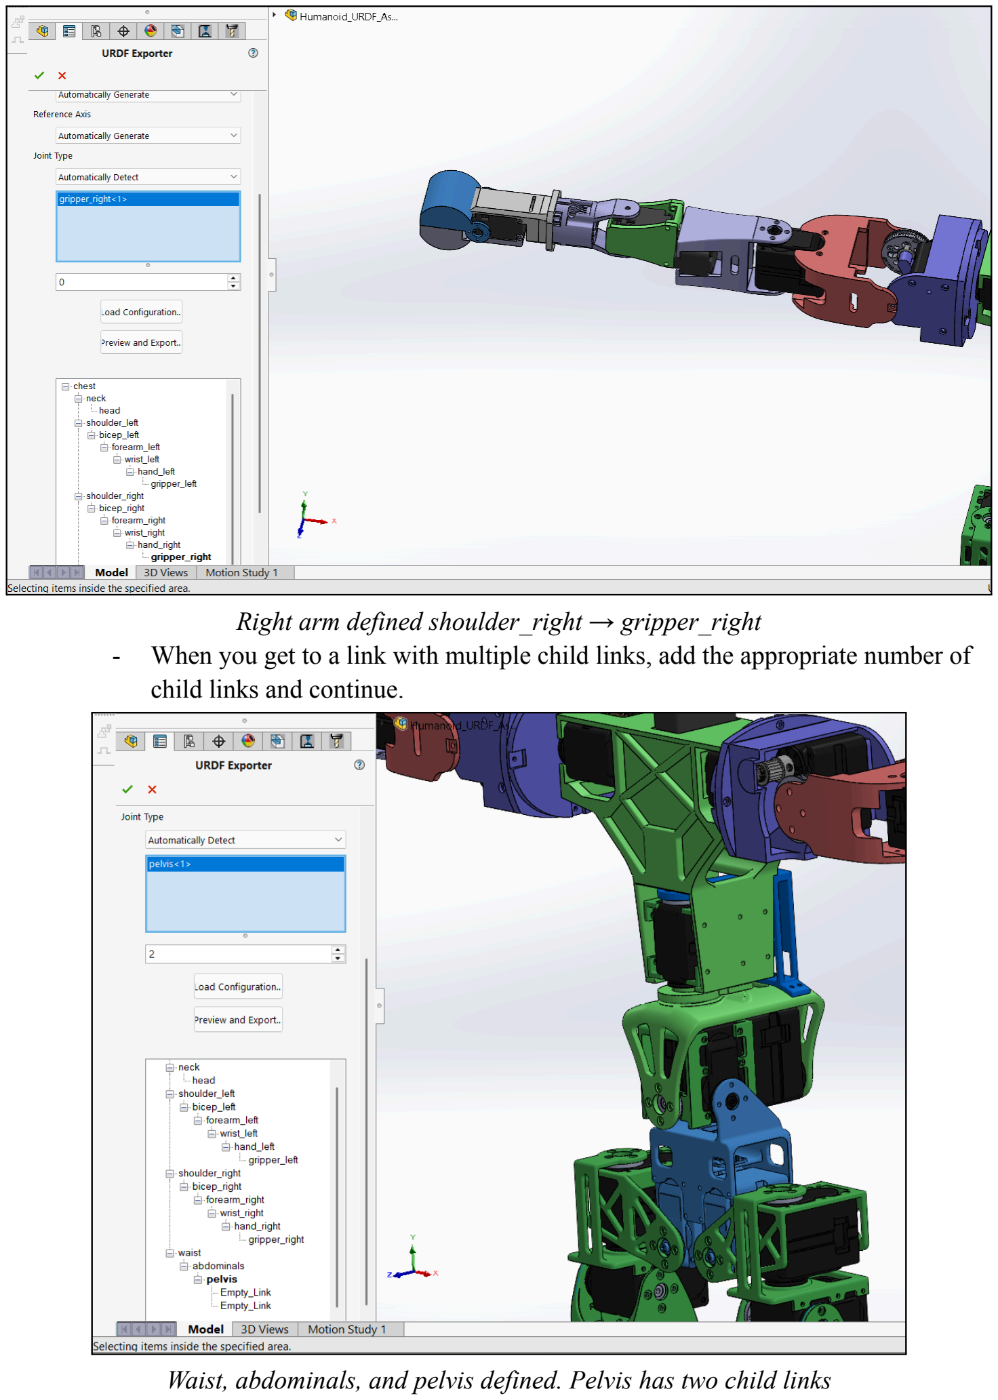
[picture p95: page 8]

Right arm defined shoulder_right → gripper_right
- When you get to a link with multiple child links, add the appropriate number of child links and continue.

Waist, abdominals, and pelvis defined. Pelvis has two child links

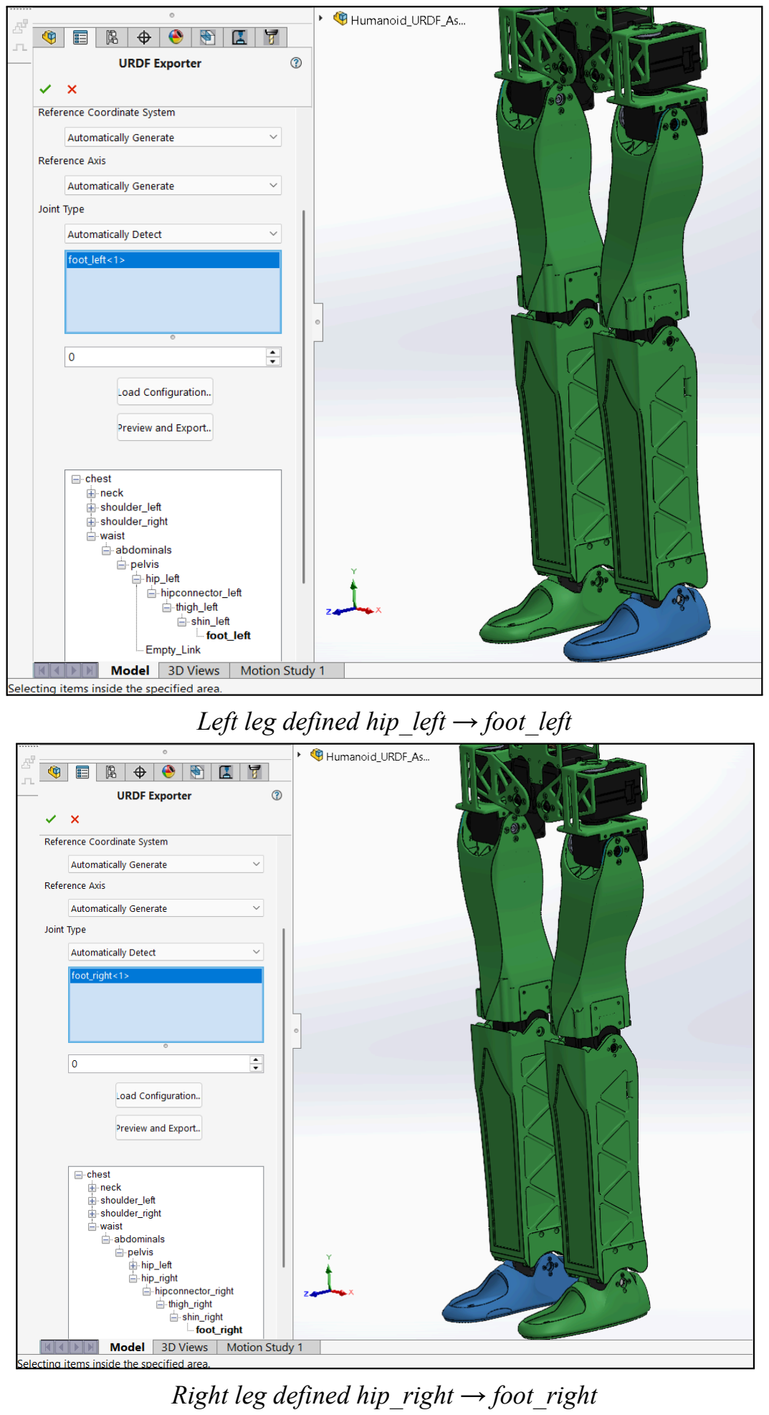
[picture p96: page 9]

Left leg defined hip_left → foot_left

Right leg defined hip_right → foot_right

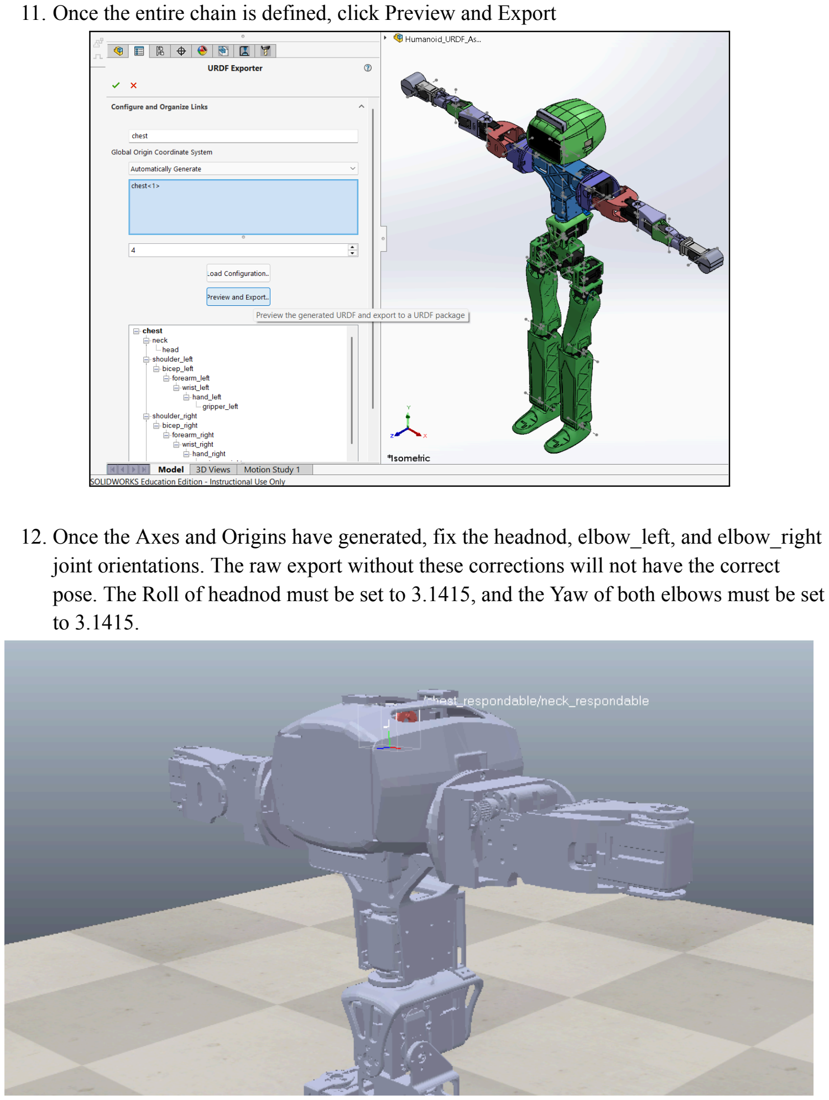
[picture p97: page 10]

11. Once the entire chain is defined, click Preview and Export
12. Once the Axes and Origins have generated, fix the headnod, elbow_left, and elbow_right joint orientations. The raw export without these corrections will not have the correct pose. The Roll of headnod must be set to 3.1415, and the Yaw of both elbows must be set to 3.1415.

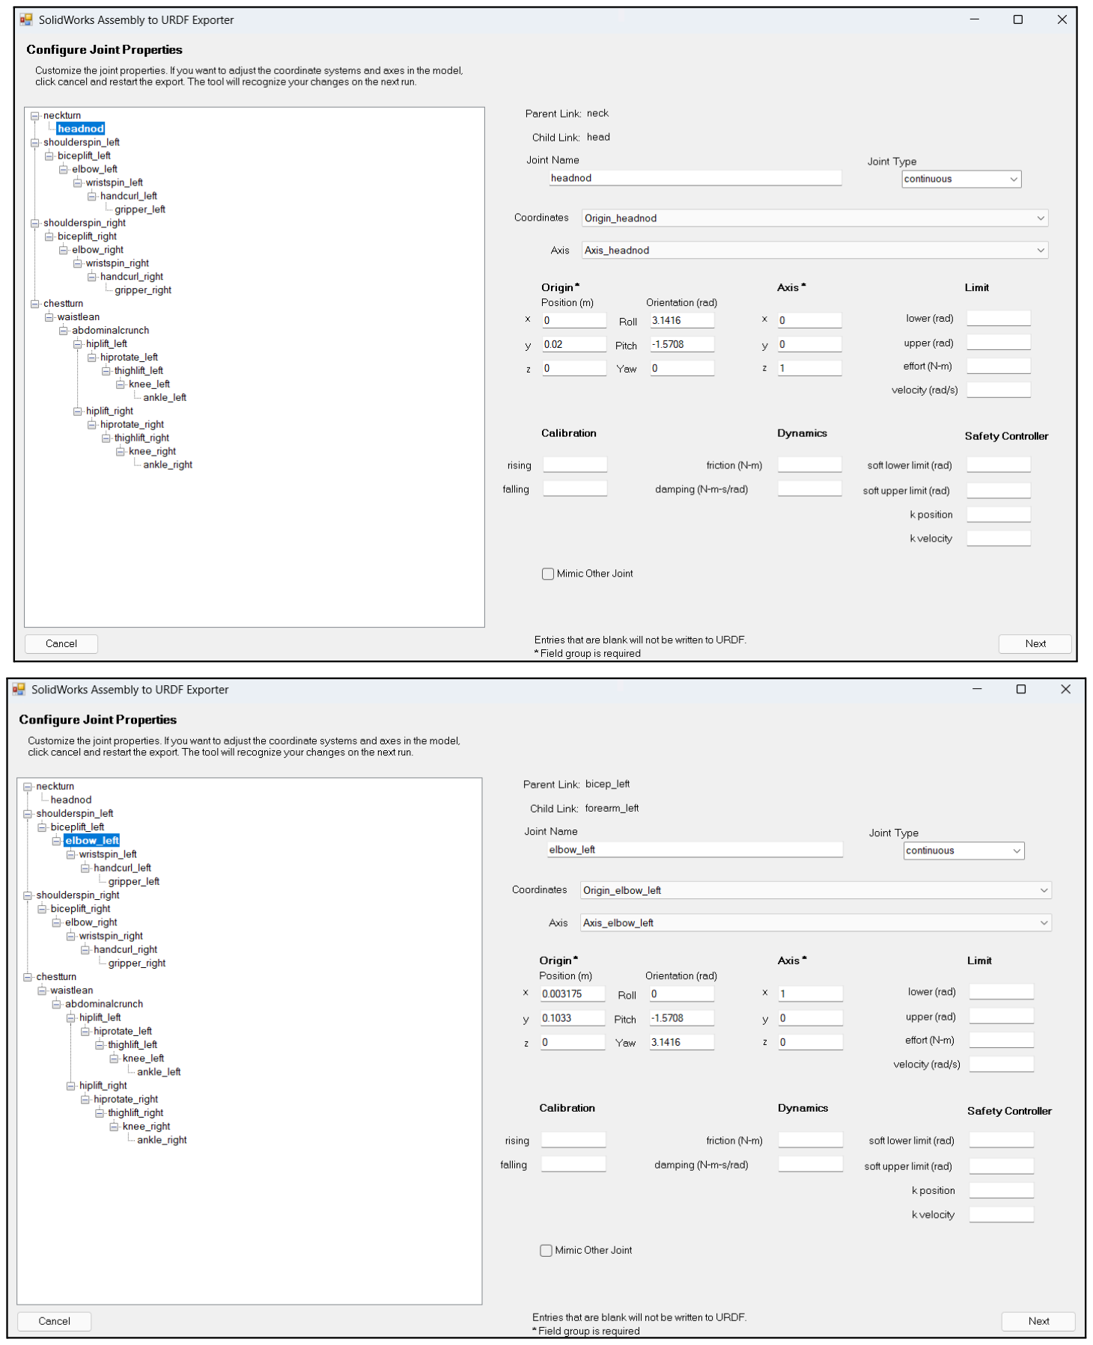
[picture p98: page 11]
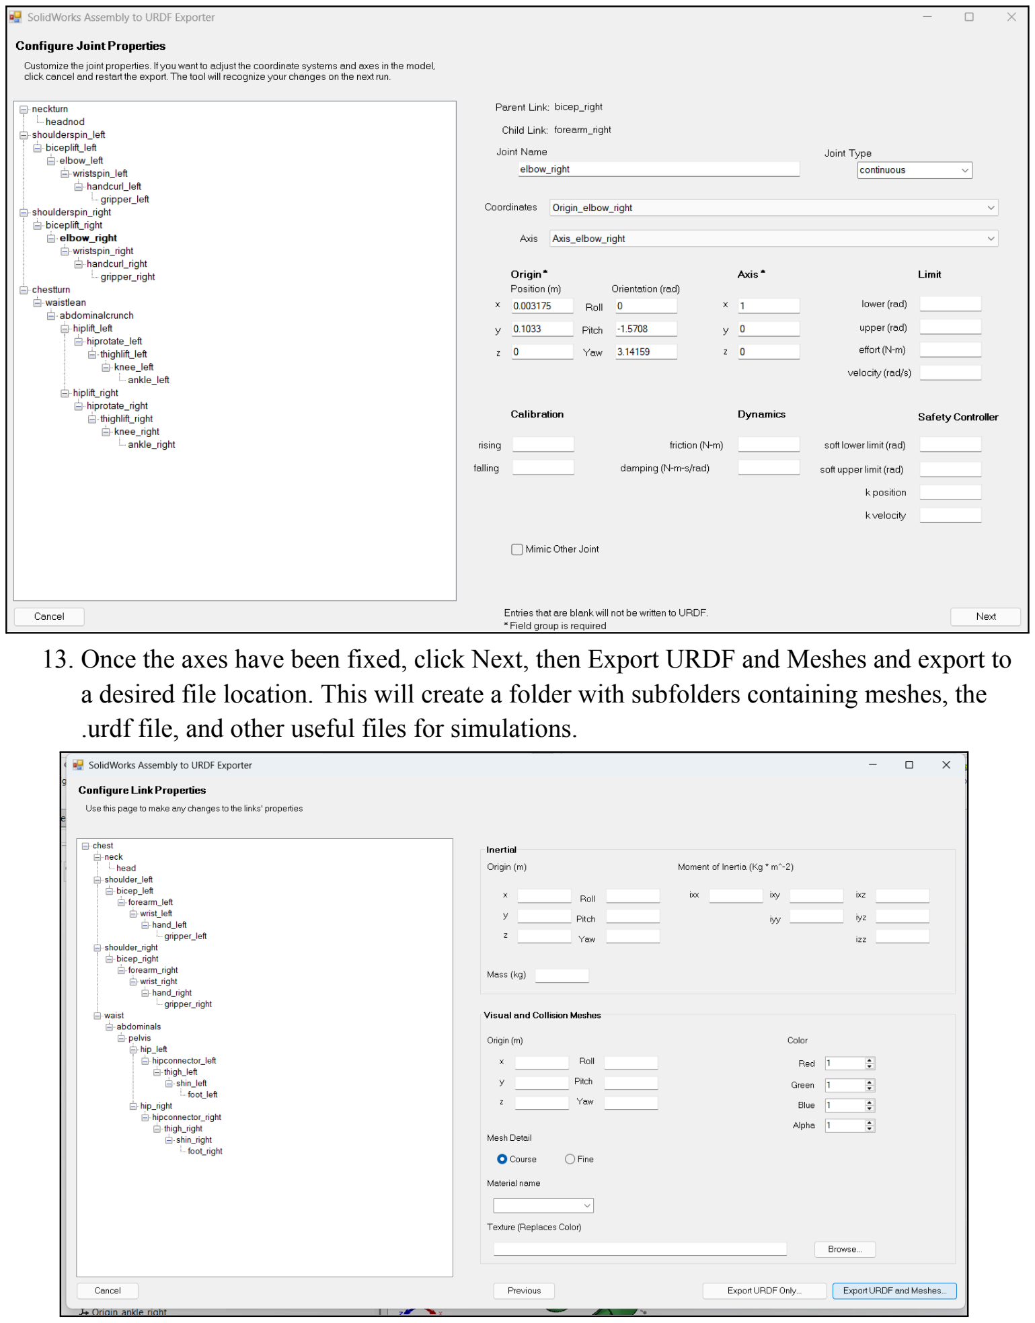
[picture p99: page 12]

13. Once the axes have been fixed, click Next, then Export URDF and Meshes and export to a desired file location. This will create a folder with subfolders containing meshes, the .urdf file, and other useful files for simulations.

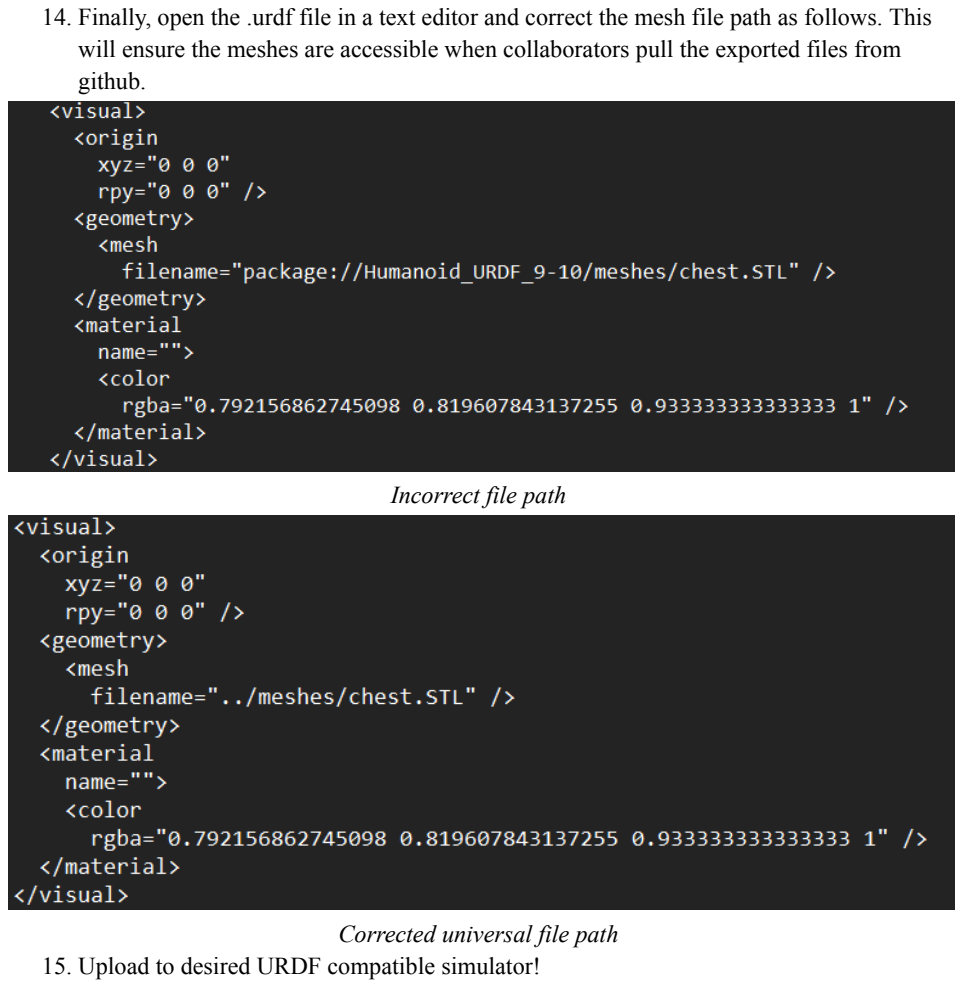
[picture p100: page 13]

14. Finally, open the .urdf file in a text editor and correct the mesh file path as follows. This will ensure the meshes are accessible when collaborators pull the exported files from github.

Incorrect file path

Corrected universal file path
15. Upload to desired URDF compatible simulator!
