KoalbyMQP/Hardware-Parts/datasheets/ESP-Prog/Debug-Help-ESP32-PROG-ALL-Connections.png

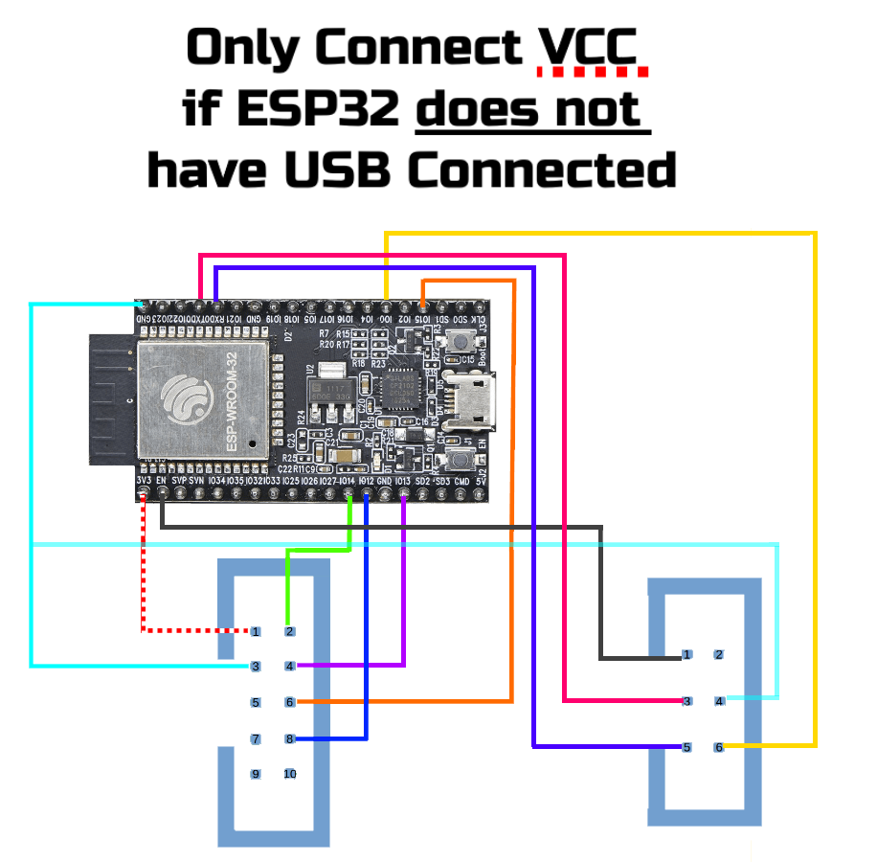
datasheets/ESP-Prog/Debug-Help-ESP32-PROG-ALL-Connections.png
