KoalbyMQP/Hardware-Parts/datasheets/ESP-Prog/Debug-Help-ESP32-PROG-JTAG-Connections.png

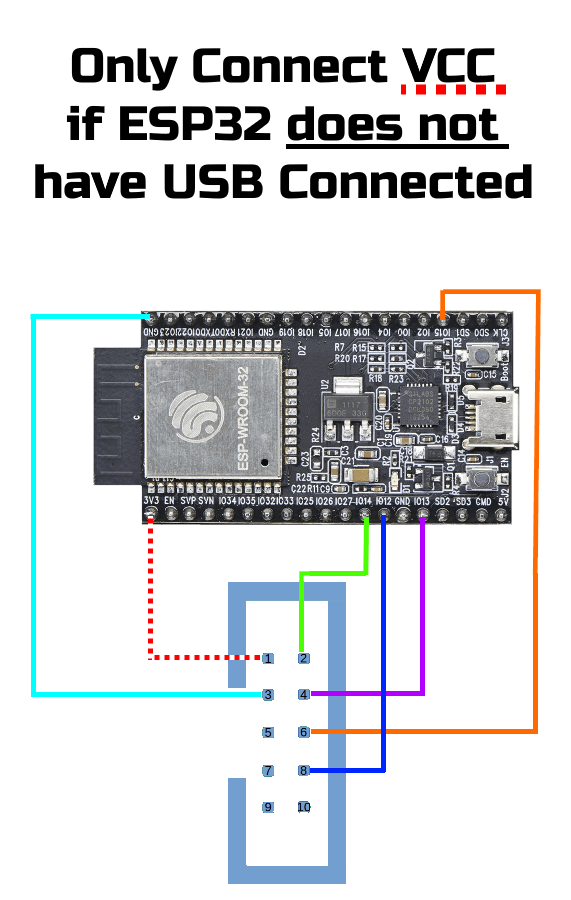
datasheets/ESP-Prog/Debug-Help-ESP32-PROG-JTAG-Connections.png
