KoalbyMQP/Hardware-Parts/(threads)

Thread 10 (2025-08-07):

Task/Leo/Head Bracket Reprint and Install

cjcotoia26, 2025-08-07:
HeadResinBracket part on leo broke, need a new resin print of this part for installation

Closed 2025-08-08.

Thread 12 (2025-09-01):

Task/Fix / Replace LCD Screen on AVA

MaceTheWindu66, 2025-09-01:
Screen on Ava is currently cracked and needs to be replaced and wired.

Thread 13 (2025-09-01):

Task/Complete Wiring for Ava Pi and Motors

MaceTheWindu66, 2025-09-01:
Ava needs to be brought up to date and wired up. Pi needs power cables wired and connection to the LCD screen. We also need to ensure all motors are connected/wired properly and that Ava is ready to be used.

Thread 16 (2025-09-01):

Task/Replace Main Switch

PauAlcolea, 2025-09-01:
Research different lighter switches to replace the heavy one on Ava

Thread 19 (2025-09-01):

Task/Redesign Tibia

PauAlcolea, 2025-09-01:
The current tibia is weak and deformed, the thought was for the battery to act as structural component but the new battery is too small for that. Maybe some crossbeams or something. Also, wires have to go through the mesh at the bottom, cad modification for that would be better than making a hole like it has been done in the past. (see picture for what I am saying)

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

Thread 25 (2025-09-16):

Improper mates in SW assembly

mlinman302, 2025-09-16:
Background:
Solidworks assemblies fix multiple parts in space using Mates. Mates propagate in the design tree under the "Mates" folder like features, and define relationships between certain parts. For example, the face of a motor can be mated to a face of a leg using a coincident mate. Multiple mates are needed to fully define a part in space. Mates can also be applied to assemblies.

Problem:
Mates in the "develop" branch of the robot are incorrect. This means that the positioning of the parts of the robot are incorrect. This propagates through the URDF export and IsaacSim import. While the errors are small, they mean that the positioning of the links will be different in simulation than in real life.

Example in Right Leg Assembly.SLDASM

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

Space in-between the motor and link. Could be there is a part missing, or that the link bends inwards to compliantly meet the face of the motor... but it's not clear. I know this is a holdover issue from last year's team as it's from last year's assembly, but I just didn't see anything about this in the GitHub.

Thread 26 (2025-09-24):

Merging branches into main containing CAD files

nicholascarignan, 2025-09-24:
Background:
When working with files in github, any changes are easily able to be committed to whatever branch you're on, and adding changes to a CAD file essentially replaces the old file when a push is done. When merging, however, github has a difficult time replacing files as done in a simple push, since github will add lines of code to keep or replace incoming code. This can't be done with a file of this kind.

Problem:
When merging the develop branch into the main branch (in this instance), github did not allow merge conflicts to be solved within the pull request. Instead, changes need to be done in the command line. This brings up two issues: a branch attempting to merge into main can be both ahead and behind of main, and files cannot be automatically replaced. They instead need to be manually replaced.

Solution:
In order to merge a branch into main, you need to create a pull request to see which files cannot be automatically merged. These could be files that are changed, replaced, or new. Using the 'theirs' command will allow you to select which version of a file you are keeping through the merge. Below is a step-by-step process to avoid this conflict merging a branch into main:

In the command terminal:
1. Access your repo --> cd path/to/repo/Hardware-Parts
2. Checkout your main branch --> git checkout main
3. Fetch the origin, and pull current main branch --> git fetch origin , git pull origin main
4. Start the merge --> git merge (your_branch)
5. For any files that show conflict (which can be found on the pull req on github or in the terminal after merge starts), use 'theirs' to select files from (your_branch) as the prominent file --> git checkout --theirs "(file_path)" [You will need to do this for all files]
6. Add these files to the commit --> git add .
7. Finalize merge --> git commit -m "Merging (your_branch) into main"
8. Finally, push the commit to main --> git push origin main

This process should replace any files with conflicts (parts or assemblies) with the file version in your original branch.

Thread 27 (2025-09-30):

Test Motors Ava

PauAlcolea, 2025-09-30:

PauAlcolea, 2025-09-30:
Completed by Evan, Max and I. We tested all the motors on Ava (they all work), and a couple of extra motors (one of the unused motors does work). We also made sure that the labels were correct with the id number for the motor.

Closed 2025-09-30.
