KoalbyMQP/Hardware-Parts/electrical/HeadPCB/PCBschematic1/PCBschematic1.kicad_pcb

## KiCad design electrical/HeadPCB/PCBschematic1/PCBschematic1.kicad_pcb (2026-10-28)

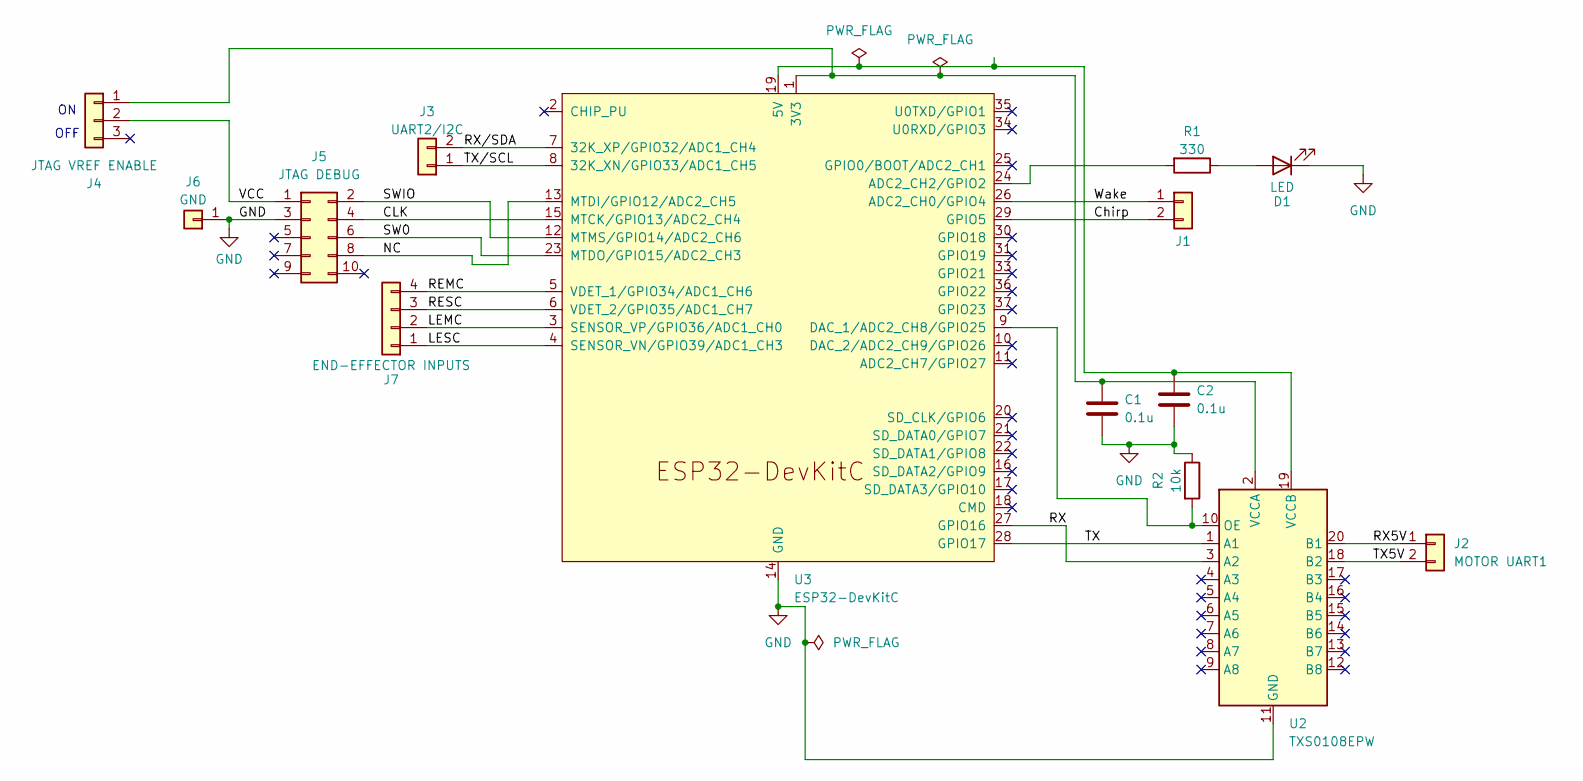
[picture p103: schematic PCBschematic1.kicad_sch]

Parts:
C1, C2: 0.1u; C_Axial_L3.8mm_D2.6mm_P7.50mm_Horizontal
D1: LED; LED_D5.0mm
J1: Conn_01x02; JST_XH_B2B-XH-A_1x02_P2.50mm_Vertical
J2: MOTOR UART1; JST_XH_B2B-XH-A_1x02_P2.50mm_Vertical
J3: UART2/I2C; JST_XH_B2B-XH-A_1x02_P2.50mm_Vertical
J4: JTAG VREF ENABLE; PinHeader_1x03_P2.54mm_Vertical
J5: JTAG DEBUG; PinHeader_2x05_P1.27mm_Vertical
J6: GND; PinHeader_1x01_P2.54mm_Vertical
J7: END-EFFECTOR INPUTS; JST_XH_B4B-XH-A_1x04_P2.50mm_Vertical
R1: 330; R_Axial_DIN0207_L6.3mm_D2.5mm_P7.62mm_Horizontal
R2: 10k; R_Axial_DIN0207_L6.3mm_D2.5mm_P7.62mm_Horizontal
U2: TXS0108EPW; TSSOP-20_4.4x6.5mm_P0.65mm
U3: ESP32-DevKitC

Connections:
/CLK: J5.4, U3.15 (MTCK/GPIO13/ADC2_CH4)
/Chirp: J1.2, U3.29 (GPIO5)
/LEMC: J7.2, U3.3 (SENSOR_VP/GPIO36/ADC1_CH0)
/LESC: J7.1, U3.4 (SENSOR_VN/GPIO39/ADC1_CH3)
/NC: J5.8, U3.13 (MTDI/GPIO12/ADC2_CH5)
/REMC: J7.4, U3.5 (VDET_1/GPIO34/ADC1_CH6)
/RESC: J7.3, U3.6 (VDET_2/GPIO35/ADC1_CH7)
/RX: U2.3 (A2), U3.27 (GPIO16)
/RX5V: J2.1, U2.20 (B1)
/RX/SDA: J3.2, U3.7 (32K_XP/GPIO32/ADC1_CH4)
/SW0: J5.6, U3.23 (MTDO/GPIO15/ADC2_CH3)
/SWIO: J5.2, U3.12 (MTMS/GPIO14/ADC2_CH6)
/TX: U2.1 (A1), U3.28 (GPIO17)
/TX5V: J2.2, U2.18 (B2)
/TX/SCL: J3.1, U3.8 (32K_XN/GPIO33/ADC1_CH5)
/VCC: J4.2, J5.1
/Wake: J1.1, U3.26 (ADC2_CH0/GPIO4)
GND: C1.2, C2.2, D1.1 (K), J5.3, J6.1 (Pin_1_1), R2.1, U2.11 (GND), U3.14 (GND), U3.32 (GND), U3.38 (GND)
unnamed: D1.2 (A), R1.1
unnamed: C1.1, J4.1, U2.2 (VCCA), U3.1 (3V3)
unnamed: R2.2, U2.10 (OE), U3.9 (DAC_1/ADC2_CH8/GPIO25)
unnamed: C2.1, U2.19 (VCCB), U3.19 (5V)
unnamed: R1.2, U3.24 (ADC2_CH2/GPIO2)

Notes on the sheet:
OFF

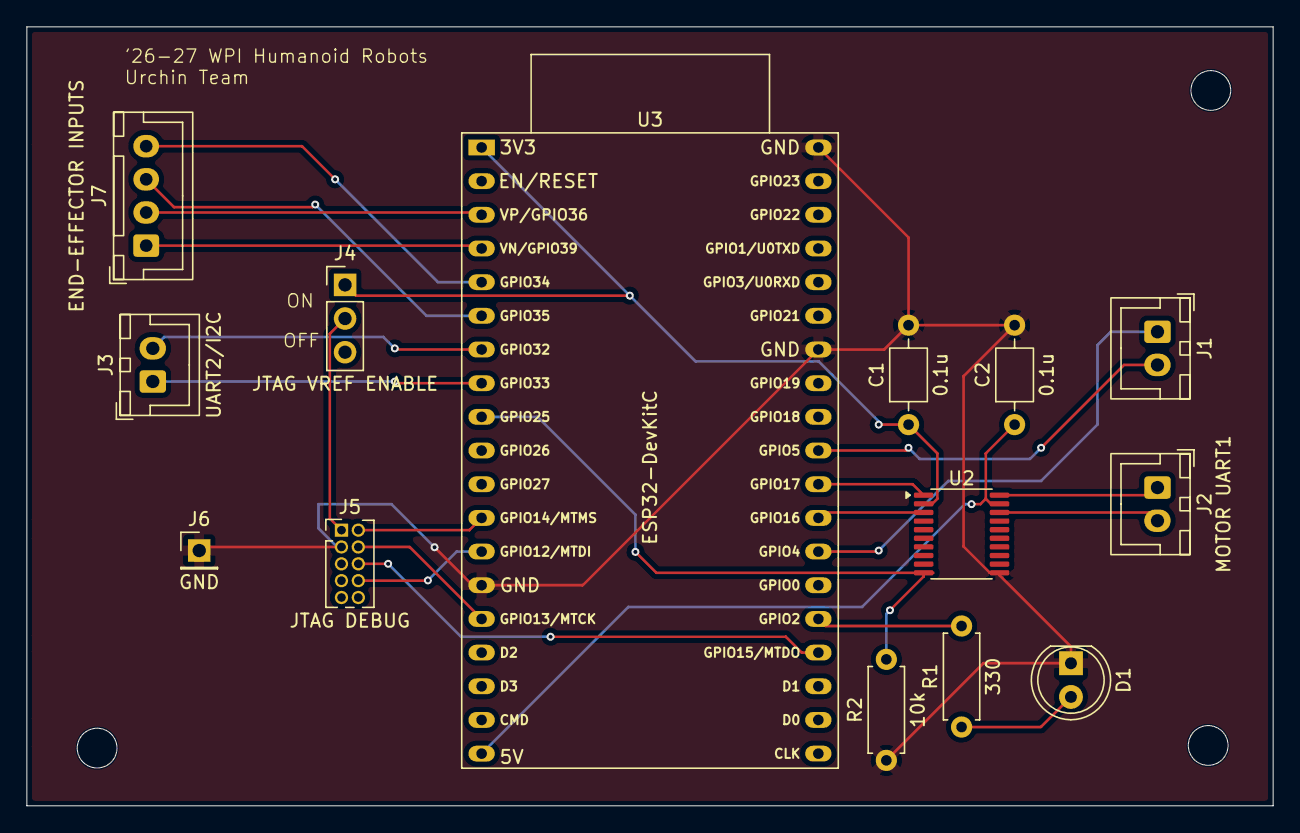
[picture p104: board PCBschematic1.kicad_pcb from above]

Board: 2 copper layers, 94.0 x 58.8 mm, 14 parts (0 on the bottom side), 23 nets.
