KoalbyMQP/Hardware-Parts/(commit log)

2025-07-14 Added ESP-PROG, product page and wiring diagram
2025-09-01 Uploaded updated master and sub assemblies
    [Arm_Assem.SLDASM, Head_Assem.SLDASM, Left_Leg_Assem.SLDASM, Right_Leg_Assem.SLDASM, Torso_Assem.SLDASM]
2025-09-01 updated foot soles
    [Left_Foot_Sole.SLDPRT, Right_Foot_Sole.SLDPRT]
2025-09-01 directory update
    [16-24_Gearbox.SLDASM, Arm_Assem.SLDASM, Head_Assem.SLDASM, Left_Leg_Assem.SLDASM, Right_Leg_Assem.SLDASM, Torso_Assem.SLDASM]
2025-09-01 directory fixes
    [16-24_Gearbox.SLDASM, Arm_Assem.SLDASM, Head_Assem.SLDASM, Left_Leg_Assem.SLDASM, Right_Leg_Assem.SLDASM, Torso_Assem.SLDASM]
2025-09-01 File system uprgrade and directory fixes
    [0601_No_Horn.SLDPRT, 0601_Spacer.SLDPRT, 16-24Ring.SLDPRT, 16-24_Gearbox.SLDASM, 16TGear.SLDPRT, 24T_Carrier.SLDPRT, 24T_Gear.SLDPRT, 3421-0014-0060 SW assembly.SLDASM]
2025-09-03 Solidworks update
    trying to fix the foot soles
    [Arm_Assem.SLDASM, FinleyPulleyShoulderAssy.SLDASM, Head_Assem.SLDASM, Left_Leg_Assem.SLDASM, Left_Thigh.SLDPRT, Right_Leg_Assem.SLDASM, Torso_Assem.SLDASM, gripperAssem.SLDASM]
2025-09-07 Reorganized pathways in master assembly
    this is the master assembly in the assemblies folder not in the Master_Assem folder
    [16-24_Gearbox.SLDASM, 3421-0014-0060 SW assembly.SLDASM, 3421-0014-0060 SW part.SLDPRT, 3421-0014-0060 assembly.STEP, 3684N13_Corrosion-Resistant HTD Timing Belt Pulley.SLDPRT, 5905K354_Needle-Roller Bearing.SLDPRT, 7947K717_High-Strength Ultra-Quiet Timing Belt.SLDPRT, 90265A199_18-8 Stainless Steel Shoulder Screw.SLDPRT]
2025-09-08 Solidworks Assembly for URDF Exporting
    Uploaded the Solidworks Assembly and parts with correct link definition and naming conventions
    [abdominals.SLDPRT, bicep_left.SLDPRT, bicep_right.SLDPRT, chest.SLDPRT, foot_left.SLDPRT, foot_right.SLDPRT, forearm_left.SLDPRT, forearm_right.SLDPRT]
2025-09-09 removed urdf export config to fix it
2025-09-10 Uploaded URDF
    Exported URDF from the solidworks assembly. Currently the head is upside down and the elbows are backwards, I am working on fixing in the exporter.
    [Humanoid_URDF.csv, Humanoid_URDF.urdf, abdominals.STL, bicep_left.STL, bicep_right.STL, chest.STL, foot_left.STL, foot_right.STL]
2025-09-10 Updated URDF configuration
    Use Humanoid_URDF_9-10 for Nvidia IssacSim
    [Humanoid_URDF.csv, Humanoid_URDF.urdf, Humanoid_URDF_9-10.csv, Humanoid_URDF_9-10.urdf, abdominals.STL, bicep_left.STL, bicep_right.STL, chest.STL]
2025-09-10 renamed urdf forlder to Simulation Files for clarity
    [Humanoid_URDF_9-10.csv, Humanoid_URDF_9-10.urdf, abdominals.SLDPRT, abdominals.STL, bicep_left.SLDPRT, bicep_left.STL, bicep_right.SLDPRT, bicep_right.STL]
2025-09-11 Update Solidworks to URDF Export Guide.pdf
2025-09-15 Added labels to Torso
    [Torso_Assem.SLDASM]
2025-09-15 Fixing Master Assy
    [Arm_Assem.SLDASM, DM9095_enclosure.SLDASM, FinleyPulleyShoulderAssy.SLDASM, Foot Sole.SLDPRT, Foot.SLDPRT, Foot_Sole.SLDPRT, Head_Assem.SLDASM, Left_Foot_Sole.SLDPRT]
2025-09-15 Updating Part Names pt1
    [Abdomen v1.SLDPRT, Abdomen.SLDPRT, Arm_Assem.SLDASM, Back Hook v1.SLDPRT, Back_Hook.SLDPRT, Chest v1.SLDPRT, Chest.SLDPRT, FinleyPulleyShoulderAssy.SLDASM]
2025-09-15 Added versions to CAD Part names
    All parts now end in "v1" to mark they are the version from the end of last year
    [0601 Spacer v1.SLDPRT, 0601_Spacer.SLDPRT, Arm_Assem.SLDASM, Bicep v1.SLDPRT, Blindfold v1.SLDPRT, Blindfold.SLDPRT, FinleyPulleyShoulderAssy.SLDASM, FinleyShoulderAdapter.SLDPRT]
2025-09-15 Deleting Master_assem pack and go folder
    [0601_No_Horn.SLDPRT, 0601_Spacer.SLDPRT, 16-24Ring.SLDPRT, 16-24_Gearbox.SLDASM, 16TGear.SLDPRT, 24T_Carrier.SLDPRT, 24T_Gear.SLDPRT, 3421-0014-0060 SW assembly.SLDASM]
2025-09-15 renaming assemblys
    [Arm Assembly.SLDASM, Arm_Assem.SLDASM, Head Assembly.SLDASM, Head_Assem.SLDASM, Left Leg Assembly.SLDASM, Left Shin v1.SLDPRT, Left_Leg_Assem.SLDASM, Right Leg Assembly.SLDASM]
2025-09-21 New Motor Bracket design to test
    [92125A126_18-8 Stainless Steel Hex Drive Flat Head Screw.SLDPRT, 97505A103_Slotted Low-Profile Steel Shoulder Screw.SLDPRT, Assy.SLDASM, Countersunk Motor Bracket.SLDPRT]
2025-09-22 STL of New Bracket
    [Assy.SLDASM, Countersunk Motor Bracket.SLDPRT]
2025-09-22 Updated to new motor bracket
    [Assy.SLDASM, Countersunk Motor Bracket.SLDPRT, Countersunk Motor Bracket.STL]
2025-09-24 added changes to incorporate head model into CAD
    [Arduino_Backplate_Head.SLDPRT, Head 2.0.SLDPRT, Head_Assem.SLDASM, Head_Boards_Mount.SLDASM, Head_Boards_Mount.SLDPRT, Head_Boards_Mount_2.SLDPRT, RPi_Backplate_Head.SLDPRT]
2025-12-09 temporary arm fixes
    [13mm_and_8.5mm_OD_gear.SLDASM, Arm Assembly.SLDASM, FinleyPulleyShoulderAssy.SLDASM, GearboxShoulder_Assembly.SLDASM, Lower Forearm Assembly.SLDASM, Lower_Forearm_Assembly.SLDASM, MirrorArm Assembly.SLDASM, MirrorFinleyPulleyShoulderAssy.SLDASM]
2025-12-09 Updated chest
    [BearingContainer.SLDPRT, Chest Assembly SW2024 - Copy.SLDASM, Chest Assembly SW2024.SLDASM, ChestRotate.SLDPRT, MotorMountsChest.SLDPRT]
2025-12-09 add head and hip (updated)
    [DM9095_enclosure.SLDASM, Head Assembly.SLDASM, Hip Connector v2.SLDPRT, MirrorThigh Lift.SLDPRT, Pelvis Connector.SLDPRT, Thigh Lift.SLDPRT, Thigh Spin.SLDPRT, pelvis.SLDASM]
2025-12-09 updated legs
    [Foot Motor Flipped.SLDPRT, Foot.SLDASM, MirrorFoot Motor Flipped.SLDPRT, Mirrorcalf-v2.SLDPRT, calf-v2.SLDPRT, driven_0601-bracket.SLDPRT, mount_0201-bracket.SLDPRT, mount_0601-bracket.SLDPRT]
2025-12-09 gearbox for knee
    [0601_No_Horn.SLDPRT, 16-24Ring.SLDPRT, 16TGear.SLDPRT, 24T_Carrier.SLDPRT, 24T_Gear.SLDPRT, 90236A107_(M2x12mm).SLDPRT, 90236A114_(M2.5x12mm).SLDPRT, 91290A111_(M3x6mm).SLDPRT]
2025-12-09 Delete ava2.0 directory
    (it was a mistake)
    [13mm_and_8.5mm_OD_gear.SLDASM, Arm Assembly.SLDASM, BearingContainer.SLDPRT, Chest Assembly SW2024 - Copy.SLDASM, Chest Assembly SW2024.SLDASM, ChestRotate.SLDPRT, DM9095_enclosure.SLDASM, FinleyPulleyShoulderAssy.SLDASM]
2026-02-05 Create board
2026-02-05 Adding Chess Board Files
    [Bishop.step, CLOCK.step, Chess Board asembly.SLDASM, Chess clock top.stl, Chess-Board-Boarder.SLDPRT, King - Part 2.step, Knight.step, Pawn.step]
2026-10-28 Create HeadPCB
    Printed Circuit Board for the robot's head
